VincentttWang/MSP430_WirelessCar/docs/hardware/MSP-EXP430F5529 硬件开发与引脚速查.md

# MSP-EXP430F5529 实验板硬件开发与引脚速查工程手册

> **文档依据**：TI 官方用户指南 *SLAU330B* (Rev 2.0 / Rev 2.2 PCB)
> **适用核心**：MSP430F5529 (80-Pin LQFP 封装)
> **手册定位**：嵌入式工程开发随身字典，涵盖所有可用引脚定义、物理排针映射、总线共享冲突、外设跳线及底层避坑指南。

---

## 目录

1. **MCU GPIO 端口全集引脚速查表 (Port 1 ~ Port 8)**
2. **板载外部扩展排针物理引脚图鉴 (J4, J5, J12, J13, RF1/2)**
3. **板载外设专用引脚分配与控制时序说明**
* 3.1 DOGS102x64 点阵液晶与背光驱动
* 3.2 MicroSD 卡 SPI 接口
* 3.3 三轴数字加速度计 (LIS3DH / CMA3000)
* 3.4 人机交互：按键、LED、电容触摸按键与电位器
* 3.5 调试、下载与板载虚拟串口 (eZ-FET / JTAG)

4. **板载跳线器 (Jumpers) 与电源模式配置指南**
5. **工程开发高频踩坑与冲突规避 (Critical Gotchas)**

---

## 1. MCU GPIO 端口全集引脚速查表 (Port 1 ~ Port 8)

| GPIO 引脚 | 复用功能 / 硬件外设 | 默认板载连接 / 物理去向 | 引出排针位置 | 硬件特性与工程开发注意事项 |
| --- | --- | --- | --- | --- |
| **P1.0** | TA0CLK / ACLK | 板载 LED1 (红色) | J12 Pin 15, JP3 | 经过跳线 `JP3 (LED JMP)` 和 470Ω 电阻接地。若作为高阻抗输入或捕获引脚，**必须拔下 JP3** 消除 LED 负载影响。 |
| **P1.1** | TA0.0 | 板载电容触摸 Pad 1 (叉号形 ╳) | 无直接排针 | 板载串联 680Ω 电阻至反贴蓝色 LED4，并连接触摸焊盘。不可作为通用高阻抗数字输入。 |
| **P1.2** | TA0.1 | 板载电容触摸 Pad 2 (方形 ◻) | 无直接排针 | 串接 680Ω 电阻至反贴蓝色 LED5，带触摸容性负载。 |
| **P1.3** | TA0.2 | 板载电容触摸 Pad 3 (八角形 ⯄) | 无直接排针 | 串接 680Ω 电阻至反贴蓝色 LED6，带触摸容性负载。 |
| **P1.4** | TA0.3 | 板载电容触摸 Pad 4 (三角形 △) | 无直接排针 | 串接 680Ω 电阻至反贴蓝色 LED7，带触摸容性负载。 |
| **P1.5** | TA0.4 / CBOUT | 板载电容触摸 Pad 5 (圆形 ◯) | 无直接排针 | 串接 680Ω 电阻至反贴蓝色 LED8，带触摸容性负载。 |
| **P1.6** | GPIO | USB PUR (上拉电阻使能) | 无外部排针 | 连接至 USB 硬件上拉控制网络及 BSL 按键 S4，用于向 USB Host 声明设备接入。一般开发请勿随意翻转。 |
| **P1.7** | GPIO | 用户按键 S1 | 无外部排针 | 按键按下时接地，板载**无硬件上拉电阻**，软件必须配置 `P1REN` 及 `P1OUT` 开启内部上拉。 |
| **P2.0** | TA1.1 | RF 接口定时器捕获/比较 | J12 Pin 16, RF1 Pin 9 | 专用于射频扩展模块或作为通用 GPIO / 定时器输出。 |
| **P2.1** | TA1.2 | 加速度计中断 2 (LIS3DH INT2)  | J12 Pin 6 | 在 Rev 2.2 PCB 上通过 0Ω 电阻 R58 连接加速度计 INT2。 |
| **P2.2** | GPIO | 用户按键 S2 | 无外部排针 | 按键按下时接地，板载**无硬件外部上拉**，MCU 端必须使能内部弱上拉。 |
| **P2.3** | TA2.0 | RF 模块扩展 / 定时器通道 | J12 Pin 5, RF1 Pin 7 | 通用引出，无板载外设干扰。 |
| **P2.4** | TA2.1 | RF 模块扩展 / 定时器通道 | J12 Pin 10, RF1 Pin 10 | 通用引出，无板载外设干扰。 |
| **P2.5** | GPIO | 加速度计中断 1 (ACCEL_INT1) | 无外部排针 | 接收加速度计中断脉冲，应配置为上升沿/下降沿外部中断。 |
| **P2.6** | TA0.1 / RF_STE | 射频模块片选 (RF_STE) | J12 Pin 1, RF1 Pin 11 | 作为 SPI 从机使能或主控软件片选输出。 |
| **P2.7** | GPIO | 加速度计片选 (ACCEL_CS) | 无外部排针 | 低电平有效。加速度计 SPI 传输时置低。 |
| **P3.0** | UCB0SIMO | RF 模块 / 加速度计共用 MOSI | J12 Pin 2, RF2 Pin 17 | ⚠️ **多设备总线共享**：同时连接至加速度计和射频插座，需依靠片选严格分时复用。 |
| **P3.1** | UCB0SOMI | RF 模块 / 加速度计共用 MISO | J12 Pin 3, RF2 Pin 19 | ⚠️ **多设备总线共享**：同上。 |
| **P3.2** | UCB0CLK | RF 模块 / 加速度计共用 SCK | J12 Pin 4, RF2 Pin 15 | ⚠️ **多设备总线共享**：同上。 |
| **P3.3** | XT2IN | 高频晶振输入 | 无 | 接入 4MHz 晶振 Q2。 |
| **P3.4** | XT2OUT | 高频晶振输出 | 无 | 接入 4MHz 晶振 Q2。 |
| **P3.5** | GPIO | 预留 / 内部无走线 | 无 | 内部未引出外设。 |
| **P3.6** | GPIO | 加速度计电源使能 (ACCEL_PWR)  | 无 | 输出高电平时为 LIS3DH/CMA3000 加速度计供电；低电平关断以降低系统待机功耗。 |
| **P3.7** | TB0OUTH / SVMOUT | MicroSD 卡片选 (SD_CS) | J5 Pin 11 | MicroSD SPI 片选，板载接有 47kΩ 上拉电阻。也可作为 TimerB 比较输出。 |
| **P4.0** | UCB1STE / UCA1CLK | RF 扩展接口控制线 | J5 Pin 9, J12 Pin 14, RF1 Pin 13 | USCI 扩展引脚。 |
| **P4.1** | UCB1SIMO / UCB1SDA  | LCD 显示屏 / SD 卡共用 MOSI | J5 Pin 5 & 10 | ⚠️ **多设备总线共享**：同时连接液晶屏与 MicroSD 卡。 |
| **P4.2** | UCB1SOMI / UCB1SCL  | MicroSD 卡数据输出 MISO | J5 Pin 3 & 12 | MicroSD 读数据线，兼做 I2C SCL。 |
| **P4.3** | UCB1CLK / UCA1STE | LCD 显示屏 / SD 卡共用 SCLK | J5 Pin 7 | ⚠️ **多设备总线共享**：LCD 与 SD 卡共用 SPI 时钟线。 |
| **P4.4** | UCA1TXD / UCA1SIMO  | 虚拟串口 TXD (发送) | J4 Pin 5 & 12, J12 Pin 13, J16, RF1 Pin 15 | 连接板载 eZ-FET 转换芯片 TUSB3410。通过 JP16 跳线连接；亦映射至排针。 |
| **P4.5** | UCA1RXD / UCA1SOMI  | 虚拟串口 RXD (接收) | J4 Pin 3 & 10, J12 Pin 11, J16, RF1 Pin 17 | 连接板载 eZ-FET 转换芯片。若外部占用串口，建议断开 JP16 对应跳线。 |
| **P4.6** | GPIO | RF 模块扩展 GPIO | J4 Pin 7, J12 Pin 12, RF1 Pin 19 | 干净的通用 I/O 引脚，无板载负载干扰。 |
| **P4.7** | GPIO | RF 模块扩展 GPIO | J4 Pin 9, J12 Pin 9, RF2 Pin 18 | 干净的通用 I/O 引脚。 |
| **P5.0** | A8 / VREF+ / VeREF+ | ADC 正基准电压输入/测试点 | TP1 测试点 | 可外部输入精准 ADC 参考基准。 |
| **P5.1** | A9 / VREF- / VeREF- | ADC 负基准电压输入 | J4 Pin 11 | 可配置为模拟通道 A9 或参考低端。 |
| **P5.2** | XT1IN | 低频 RTC 晶振输入 | 无 | 接入 32.768kHz 晶振 Q1。 |
| **P5.3** | XT1OUT | 低频 RTC 晶振输出 | 无 | 接入 32.768kHz 晶振 Q1。 |
| **P5.5** | GPIO | LCD 数据/命令选择 (LCD_D/C) | 无外部排针 | 高电平 = 数据 (Display RAM)；低电平 = 寄存器指令。 |
| **P5.6** | GPIO | LCD 硬件复位 (LCD_RST) | 无外部排针 | 低电平复位。板载接有 47kΩ 上拉电阻。 |
| **P5.7** | GPIO | LCD 片选使能 (LCD_CS) | 无外部排针 | 低电平有效。板载接有 47kΩ 上拉电阻。 |
| **P6.6** | CB6 / A6 | 比较器通道 6 / ADC 输入 6 | J4 Pin 2 | 独立模拟量输入通道，排针直出。 |
| **P6.7** | CB7 / A7 | 比较器通道 7 / ADC 输入 7 | J4 Pin 14 | 独立模拟量输入通道，排针直出。 |
| **P7.0** | CB8 / A12 | 比较器通道 8 / ADC 输入 12 | J5 Pin 2 | 独立模拟量输入通道。 |
| **P7.1** | CB9 / A13 | 比较器通道 9 / ADC 输入 13 | J5 Pin 4 | 独立模拟量输入通道。 |
| **P7.2** | CB10 / A14 | 比较器通道 10 / ADC 输入 14 | J5 Pin 6 | 独立模拟量输入通道。 |
| **P7.3** | CB11 / A15 | 比较器通道 11 / ADC 输入 15 | J5 Pin 8 | 独立模拟量输入通道。 |
| **P7.5** | TB0.3 | 定时器 B 通道 3 | J12 Pin 7, RF2 Pin 16 | 硬件 PWM 输出或输入捕获。 |
| **P7.6** | TB0.4 / GPIO | LCD 背光使能 (LCD_BLEN) | 无外部排针 | 连接至恒流芯片 TPS75105 的 EN。输入 PWM 信号可调节屏幕背光灰度。 |
| **P7.7** | TB0CLK / MCLK | 主时钟输出 / 定时器时钟输入 | J5 Pin 14 | 可用于时钟信号向外同步输出。 |
| **P8.0** | GPIO / A0 (模拟) | 模拟拇指滚轮电位器 (POT) | J4 Pin 8, JP2 | 经过跳线 `JP2 (POT)` 接到 50kΩ 电位器。**不用时请拔下 JP2**，避免分压漏电与模拟窜扰。 |
| **P8.1** | GPIO | 板载 LED2 (绿色) | J4 Pin 4 | 串接 470Ω 限流电阻至绿色 LED2。输出高电平点亮。 |
| **P8.2** | GPIO | 板载 LED3 (黄色) | J4 Pin 6 | 串接 470Ω 限流电阻至黄色 LED3。*(注：官方手册文档文字有笔误标为 P8.3，实际原理图与排针布线均为 P8.2)*。 |
| **RST/NMI** | SBWTDIO / JTAG_RST  | 硬件复位 / 仿真数据 | J1 Pin 11, JP16 Pin 3, S3 | 连接复位轻触按键 S3，接有 47kΩ 上拉和对地 1.1nF 电容滤波。 |
| **TEST** | SBWTCK / JTAG_TCK | 仿真时钟 | J1 Pin 8, JP16 Pin 1 | Spy-Bi-Wire 关键引脚。 |

---

## 2. 板载外部扩展排针物理引脚图鉴

实验板引出了 J4、J5 以及 J12/J13 等多组间距为 0.1 英寸（2.54mm）的双排针，方便用杜邦线或示波器探头外接信号。

### 2.1 排针 J4 (F5529 Pin Access Header 1)

*位置：单片机右上方靠近 USB 接口区域。标准 2×7 双排公针。*

```text
                  +-----+-----+
   (VCC 输出) VCC |  1  |  2  | P6.6 (CB6 / A6)
(UCA1RXD)    P4.5 |  3  |  4  | P8.1 (GPIO - LED2)
(UCA1TXD)    P4.4 |  5  |  6  | P8.2 (GPIO - LED3)
(GPIO)       P4.6 |  7  |  8  | P8.0 (GPIO - POT)
(GPIO)       P4.7 |  9  | 10  | P4.5 (UCA1RXD / UCA1SOMI)
(A9/VREF-)   P5.1 | 11  | 12  | P4.4 (UCA1TXD / UCA1SIMO)
            GND   | 13  | 14  | P6.7 (CB7 / A7)
                  +-----+-----+

```

> 📌 **注意**：P4.4 和 P4.5 在 J4 上各有**两个**物理引出引脚（Pin 3/10 与 Pin 5/12 同源），这是 PCB 为方便射频和串口双重跳线设计的并联网络。

---

### 2.2 排针 J5 (F5529 Pin Access Header 2)

*位置：单片机右下方靠近滚轮区域。标准 2×7 双排公针。*

```text
                               +-----+-----+
                (VCC 输出) VCC |  1  |  2  | P7.0 (CB8 / A12)
(UCB1SOMI / SD)           P4.2 |  3  |  4  | P7.1 (CB9 / A13)
(UCB1SIMO / LCD+SD)       P4.1 |  5  |  6  | P7.2 (CB10 / A14)
(UCB1CLK / LCD+SD)        P4.3 |  7  |  8  | P7.3 (CB11 / A15)
(UCB1STE / RF)            P4.0 |  9  | 10  | P4.1 (UCB1SIMO - LCD/SD)
(TB0OUTH / SD_CS)         P3.7 | 11  | 12  | P4.2 (UCB1SOMI - SD)
                         GND   | 13  | 14  | P7.7 (TB0CLK / MCLK)
                               +-----+-----+

```

> 📌 **注意**：J5 排针大量暴露了 UCB1 SPI 总线信号（P4.1、P4.2、P4.3）。若用于外接通用传感器，注意不要与板载 LCD 或 SD 卡发生总线争用。

---

### 2.3 排针 J12 (eZ-RF1 / eZ430-RF2500 Header)

*位置：板子右上方，标准 2×9 双排公针，兼容 TI eZ430-RF2500T 模块引脚。*

```text
                     +-----+-----+
(RF_STE)        P2.6 |  1  |  2  | P3.0 (RF_SIMO / UCB0)
(RF_SOMI)       P3.1 |  3  |  4  | P3.2 (RF_CLK / UCB0)
(TA2.0)         P2.3 |  5  |  6  | P2.1 (TA1.2)
(TB0.3)         P7.5 |  7  |  8  | GND
(GPIO)          P4.7 |  9  | 10  | P2.4 (TA2.1)
(RXD)           P4.5 | 11  | 12  | P4.6 (GPIO)
(TXD)           P4.4 | 13  | 14  | P4.0 (UCx1xx)
(LED1)          P1.0 | 15  | 16  | P2.0 (TA1.1)
               GND   | 17  | 18  | RF_PWR (受 JP14 控制供电)
                     +-----+-----+

```

> ⚠️ **供电警示**：J12 的 Pin 18 (`RF_PWR`) 必须在插上 **JP14 跳线帽** 后才有 3.3V 供电；若未插跳线，外接模块将无法上电。

---

### 2.4 排针 J13 (eZ-RF Target 调试接口)

*位置：6-Pin 单排接口，用于直插 eZ430 目标小板。*

| J13 引脚号 | 信号名 | MCU 连接端 / 功能 |
| --- | --- | --- |
| **Pin 1**  | TXD | P4.4 (UCA1TXD) |
| **Pin 2**  | RF_PWR | 受 JP14 控制的 3.3V 射频电源 |
| **Pin 3**  | RXD | P4.5 (UCA1RXD) |
| **Pin 4**  | GND | 系统参考地 |
| **Pin 5**  | RST | SBWTDIO (复位线) |
| **Pin 6**  | TEST | SBWTCK (测试时钟线) |

---

## 3. 板载外设专用引脚分配与控制时序说明

### 3.1 点阵液晶屏 DOGS102x64 与背光驱动

板载一块分辨率为 $102\times64$ 的单色点阵液晶（控制器 UC1701）及专用白色 LED 背光驱动。

| 功能信号 | 对应 MCU 引脚 | 电气特性与编程注意事项 |
| --- | --- | --- |
| **LCD_SIMO** | **P4.1** (UCB1SIMO) | SPI 数据输出，配置为 3 线 SPI Master（MSB first, Mode 0 或 Mode 3）。 |
| **LCD_SCLK** | **P4.3** (UCB1CLK)  | SPI 串行时钟线。最高支持约 20MHz。 |
| **LCD_CS** | **P5.7** | 片选低有效。板载带 47kΩ 上拉。向屏幕写指令或刷新显存前拉低，完成后拉高。 |
| **LCD_D/C**  | **P5.5** | 指令/数据选择：**低电平** 为控制命令；**高电平** 为显存数据。 |
| **LCD_RST**  | **P5.6** | 硬件复位低有效。板载带 47kΩ 上拉。上电后需给出不低于 10µs 的低脉冲完成硬件重置。 |
| **LCD_BLEN** | **P7.6** (TB0.4) | 背光恒流驱动 IC (TPS75105) 使能脚。常高全亮；使用 TimerB4 输出 PWM 可调节 0%~100% 亮度。 |

---

### 3.2 MicroSD 存储卡接口

采用 SPI 模式驱动标准 FAT16/FAT32 文件系统，插座位于板子顶部中央。

| 功能信号 | 对应 MCU 引脚 | 硬件特性与编程注意事项 |
| --- | --- | --- |
| **SD_CS** | **P3.7** | 片选低有效。板载带 47kΩ 强上拉电阻，空闲时保证 SD 卡处于未选中状态。 |
| **SD_SIMO** | **P4.1** (UCB1SIMO) | 与 LCD 共用。向 SD 卡发送 CMD 命令或写入 Block 块。 |
| **SD_SOMI** | **P4.2** (UCB1SOMI) | SD 卡数据返回（MISO）。板载带 47kΩ 上拉。 |
| **SD_SCLK** | **P4.3** (UCB1CLK)  | 与 LCD 共用。卡初始化阶段频率应限制在 100k~400kHz；进入传输阶段后再提速至 10M~20MHz。 |

---

### 3.3 三轴加速度计 (LIS3DH / CMA3000)

Rev 2.0 原装为 CMA3000-D01，Rev 2.2 替代为 ST 公司的 LIS3DH。采用 SPI 通信。

| 功能信号 | 对应 MCU 引脚 | 硬件特性与编程注意事项 |
| --- | --- | --- |
| **ACCEL_PWR**  | **P3.6** | **核心控制引脚**：加速度计电源通过 P3.6 供电。**初始化前必须将 P3.6 置高（输出 3.3V）并延时约 5ms 稳定电源**，否则读写寄存器无应答。 |
| **ACCEL_CS** | **P2.7** | 片选低有效。默认拉高。 |
| **ACCEL_SCK**  | **P3.2** (UCB0CLK)  | 与 RF 接口共享 UCB0 时钟。 |
| **ACCEL_SIMO** | **P3.0** (UCB0SIMO) | 与 RF 接口共享 UCB0 数据输出。 |
| **ACCEL_SOMI** | **P3.1** (UCB0SOMI) | 与 RF 接口共享 UCB0 数据输入。 |
| **ACCEL_INT1** | **P2.5** | 加速度阈值/敲击事件中断 1。 |
| **ACCEL_INT2** | **P2.1** | 仅限 Rev 2.2 PCB（通过 0Ω 电阻 R58 接入）。 |

---

### 3.4 人机交互元件

#### (1) 按键与电位器

* **按键 S1 (P1.7)**：按下为低电平。需配置内部弱上拉 (`P1REN |= BIT7; P1OUT |= BIT7;`)。
* **按键 S2 (P2.2)**：按下为低电平。需配置内部弱上拉 (`P2REN |= BIT2; P2OUT |= BIT2;`)。
* **复位按键 S3 (RST)**：硬件连通 MSP430 复位脚。
* **BSL 激活键 S4 (PUR)**：配合冷启动进入 USB 固件升级引导模式。
* **模拟滑轮电位器 (P8.0)**：接入 50kΩ 电位器滑动端。如果使用 ADC 通道采集电压，需闭合 **JP2 跳线**；若不用，务必断开 JP2，避免电位器分压消耗静态电流。

#### (2) LED 指示灯

* **LED1 (红色)**：接 **P1.0**。中间串接 **JP3 (LED JMP)**。高电平点亮。
* **LED2 (绿色)**：接 **P8.1**。高电平点亮。
* **LED3 (黄色)**：接 **P8.2**。高电平点亮。*(注：官方手册 Table 2 误标为 P8.3，请以 P8.2 为准)*。

#### (3) 触摸焊盘 (Cap-Touch Slider) 与背部指示灯

板子下方提供 5 个电容触摸电极（PAD1 ~ PAD5），每个焊盘反向焊有专属蓝色 LED（LED4 ~ LED8）：

* **PAD1 (╳)**：`P1.1` | **PAD2 (◻)**：`P1.2` | **PAD3 (⯄)**：`P1.3`
* **PAD4 (△)**：`P1.4` | **PAD5 (◯)**：`P1.5`
* **驱动原理**：利用 MSP430F5529 的 Pin-Oscillator 或外部 RC 充放电测量容值变化。引脚内部经过 680Ω 电阻连接至蓝色 LED 后接地。

---

### 3.5 调试、编程与通信接口

#### (1) 板载 eZ430-FET 仿真器跳线区 (JP16)

JP16 是一组 2×5 排针桥接器，连接板载仿真芯片与 F5529：

* `DVCC`：为板载仿真器的电平转换芯片提供目标板电压参考。
* `TXD`：P4.4 (MCU TX) $\rightarrow$ PC 虚拟串口接收端。
* `RXD`：P4.5 (MCU RX) $\leftarrow$ PC 虚拟串口发送端。
* `RST`：Spy-Bi-Wire 调试数据线 (SBWTDIO)。
* `TEST`：Spy-Bi-Wire 调试时钟线 (SBWTCK)。

> 💡 若需完全隔离板载仿真器（例如使用外接高精度分析仪或外接 JTAG 仿真盒），直接拔除 JP16 的全部跳线帽。

#### (2) 14-Pin 传统 JTAG 接口 (J1)

提供标准 14 针 JTAG 接口，支持外接 `MSP-FET430UIF` 开展 4-Wire 极速 JTAG 调试。

---

## 4. 板载跳线器 (Jumpers) 与电源模式配置指南

### 4.1 全板跳线器功能速查表

| 跳线位号 | 丝印名称  | 闭合 (插上跳线帽) | 断开 (拔除跳线帽) | 默认推荐状态 |
| --- | --- | --- | --- | --- |
| **JP2**  | POT | 连接 P8.0 至模拟电位器 | 断开 P8.0，释放为干净 GPIO/ADC | 使用滚轮时闭合 |
| **JP3**  | LED1 | 连接 P1.0 至 LED1 (红色) | 断开 P1.0，消除 LED 电流负载 | 调试指示时闭合 |
| **JP6**  | 430 PWR | 为 MCU 单片机供电 (DVCC) | MCU 断电。**可串联万用表测 MCU 单独功耗** | **必须闭合** |
| **JP7**  | SYS PWR | 为板载所有外设系统供电 (VCC) | 板载外设断电。**可串入万用表测整板功耗**  | **必须闭合** |
| **JP8**  | LDO (3针) | **ALT** (默认): 使用外部 TPS73533 高性能 3.3V LDO<br> | | |

<br>**INT**: 使用 F5529 片内集成 LDO 为系统供电 | 5529 USB 供电时无系统 VCC 输出 | 默认插在 **ALT** 侧 |
| **JP11** | JTAG (3针) | **EXT** (默认): JTAG 仿真盒不供电，需板载供电<br>

<br>**INT**: 允许 JTAG 仿真盒反向为板子系统供电 | JTAG 无法向系统供电 | 默认插在 **EXT** 侧 |
| **JP14** | RF PWR | 为射频扩展座 (J12, J13, RF2) 输送 3.3V 核心电源 | 射频扩展座完全断电 | 插入射频板时闭合 |
| **JP15** | USB PWR | 连通 5529 Mini-USB 的 5V VBUS 电源输入 | 5529 USB 接口供电断开 | 使用 5529 USB 供电时闭合 |
| **JP16** | eZ-FET | 连接 eZ-FET 调试仿真器与 UART 串口各路信号 | 彻底断开仿真模块与主控单片机的电气联系 | 正常开发全闭合 |

---

### 4.2 电源选择开关 (SW1) 与常用供电组合

板子左上方的拨动开关 **SW1 (POWER SEL)** 决定系统的电能入口：

```text
       SW1 档位设置                      工作模式说明
   +-------------------+
   | [■] LDO           | -> 使用右上方 "5529 USB" 端口供电 (经 TPS73533 降至 3.3V)
   | [ ] eZ            | -> 使用左下方 "eZ-FET USB" 端口供电 (经 TPS77301 降至 3.6V)
   | [ ] JTAG / BATT   | -> 使用 J10 接线端子外接干电池 (2~3V) 或通过 JTAG 仿真器供电
   +-------------------+

```

#### 四种常用供电配置速查：

1. **单 USB 独立运行开发 (最常用)**：
* 拨码开关 SW1 拨至 **`LDO`**。
* 数据线接入 **5529 USB**（右上角）。
* 跳线 `JP8` 选 **`ALT`**，`JP15` 闭合。

2. **免外接仿真器调试 (eZ-FET 调试)**：
* 拨码开关 SW1 拨至 **`eZ`**。
* 数据线接入 **eZ-FET USB**（左下角）。
* `JP16` 所有 5 组跳线帽全部短接。

3. **外接电池供电 (移动脱机)**：
* 电池插座 J10 接入 2 节 1.5V 干电池。
* 拨码开关 SW1 拨至 **`JTAG/BATT`**。
* 跳线 `JP11` 必须插在 **`EXT`** 位置。

4. **外部 MSP-FET430UIF 仿真盒供电**：
* SW1 拨至 **`JTAG/BATT`**。
* 跳线 `JP11` 插在 **`INT`** 位置。

---

### 4.3 超低功耗 (ULP) 动态电流测量方法

1. **仅测量 MSP430F5529 单芯片电流**：
* 取下 **JP6** 跳线帽。
* 将高精度微安表/皮安表串接在 **JP6** 的两个插针之间（或使用 JP6 旁边两个大过孔“430 PWR”引出线夹）。
* 此时可精准测得活动模式或 LPM3 停机模式下的 MCU 级电流（LPM3 典型值约为 2µA）。

2. **测量整板全系统功耗 (System Current)**：
* 取下 **JP7** 跳线帽。
* 将万用表串接入 **JP7** 两端。
* ⚠️ 注意：开启屏幕背光时整板电流约为 **25mA ~ 30mA** 属于正常状态。若要测试低功耗系统，需关闭液晶和背光。

---

## 5. 工程开发高频踩坑与冲突规避 (Critical Gotchas)

### ⚠️ 陷阱 1：SPI 外设总线复用踩坑

* **LCD 与 MicroSD 冲突**：
两者共用 **UCB1** 总线（`P4.1` SIMO, `P4.3` SCLK）。
* **解决法则**：操作 SD 卡前，务必先将 LCD 片选 `P5.7` 置高（禁用 LCD）；操作 LCD 前，务必先将 MicroSD 卡片选 `P3.7` 置高（禁用 SD 卡）。

* **加速度计与 RF 模块冲突**：
两者共用 **UCB0** 总线（`P3.0` SIMO, `P3.1` SOMI, `P3.2` SCK）。
* **解决法则**：在与无线射频通信时，确保加速度计片选 `P2.7` 保持高电平。

### ⚠️ 陷阱 2：加速度计读不出数据？P3.6 是使能开关！

许多开发者常误以为加速度计由系统 VCC 常供电，实际上 TI 原理图为了极限低功耗，将传感器 VDD 接在 **`P3.6`** 上。

* **避坑代码**：
```c
P3DIR |= BIT6;
P3OUT |= BIT6;   // 必须拉高给加速度计供电
__delay_cycles(50000); // 必须延时等待传感器电源稳定，再发起 SPI 寻址！

```

### ⚠️ 陷阱 3：官方文档 Table 2 与原理图的 LED3 勘误

* 官方手册第 19 页 Table 2 中将 **LED3** 误标记为 **P8.3**。
* **纠偏真相**：查阅原理图 Sheet 1 (Figure 10) 及 Table 3 (J4 排针定义)，LED3 硬件上实际连接至 **`P8.2`**。在工程中控制黄色 LED3，必须配置 `P8DIR |= BIT2; P8OUT |= BIT2;`。

### ⚠️ 陷阱 4：JTAG 彻底锁死 (Lockup) 应急抢救流程

如果由于电源不稳定、烧录时突然拔线或配置了非法的主频/核心电压（PMM VCORE 配置错误），导致 CCS 报错 `Unable to connect to target` 或 JTAG 锁死：

1. 拔下所有连接线（拔除 JTAG 线、USB 5529 线及 eZ-FET USB 线）。
2. 将电源选择开关 SW1 拨到 **`eZ`** 档位。
3. 用一根杜邦线将板子上的 **GND 测试孔** 与 **430 PWR 测试孔**（JP6 旁边的过孔）**短接 3 秒**，泄放 MCU 内部残余电荷。
4. 重新接上 USB 线，即可顺利解除锁死。

### ⚠️ 陷阱 5：USB 与干电池混用导致的“反充爆炸风险”

* 严禁在 SW1 拨在 `LDO` 档且插入 5529 USB 供电时，同时在 J10 接入普通不可充电干电池且将跳线乱插。
* 错误的供电跳线组合会导致 5V/3.3V 电源逆向灌入干电池夹，造成电池发热甚至漏液损坏板卡。使用电池供电时，必须将 SW1 切至 `JTAG/BATT`，且 JP11 选 `EXT`。

### ⚠️ 陷阱 6：P1.1 ~ P1.5 触摸按键不可当普通高阻输入

P1.1 至 P1.5 物理走线上并联有电容焊盘、680Ω 电阻以及 LED4~LED8 的对地回路。如果用于外接数字传感器作为输入引脚，电平会被下拉电阻强制拉低。建议这些引脚只用于原生的电容触摸方案，避免外部扩展使用。通用外接数字信号请优先使用排针 **J4、J5** 上的独立端口（如 P4.6, P4.7, P6.6, P6.7, P7.0~P7.3）。
