VincentttWang/MSP430_WirelessCar/NUEDC_2026/[Doc] Hardware/感为灰度Keil_MSPM0例程/examples/Software_IIC/keil/Objects/gpio_toggle_output_LP_MSPM0G3507_nortos_keil.htm

# Static Call Graph for image .\Objects\gpio_toggle_output_LP_MSPM0G3507_nortos_keil.axf

#<CALLGRAPH># ARM Linker, 6210000: Last Updated: Tue Jul 22 17:33:17 2025

### Maximum Stack Usage = 184 bytes + Unknown(Cycles, Untraceable Function Pointers)

### Call chain for Maximum Stack Depth:

__rt_entry_main ⇒ main ⇒ Ping ⇒ IIC_ReadBytes ⇒ IIC_RecvByte ⇒ delay_us

### Mutually Recursive functions

- NMI_Handler ⇒ NMI_Handler
- HardFault_Handler ⇒ HardFault_Handler
- SVC_Handler ⇒ SVC_Handler
- PendSV_Handler ⇒ PendSV_Handler
- SysTick_Handler ⇒ SysTick_Handler

### Function Pointers

- ADC0_IRQHandler from startup_mspm0g350x_uvision.o(.text) referenced from startup_mspm0g350x_uvision.o(RESET)
- ADC1_IRQHandler from startup_mspm0g350x_uvision.o(.text) referenced from startup_mspm0g350x_uvision.o(RESET)
- AES_IRQHandler from startup_mspm0g350x_uvision.o(.text) referenced from startup_mspm0g350x_uvision.o(RESET)
- CANFD0_IRQHandler from startup_mspm0g350x_uvision.o(.text) referenced from startup_mspm0g350x_uvision.o(RESET)
- DAC0_IRQHandler from startup_mspm0g350x_uvision.o(.text) referenced from startup_mspm0g350x_uvision.o(RESET)
- DMA_IRQHandler from startup_mspm0g350x_uvision.o(.text) referenced from startup_mspm0g350x_uvision.o(RESET)
- GROUP0_IRQHandler from startup_mspm0g350x_uvision.o(.text) referenced from startup_mspm0g350x_uvision.o(RESET)
- GROUP1_IRQHandler from startup_mspm0g350x_uvision.o(.text) referenced from startup_mspm0g350x_uvision.o(RESET)
- HardFault_Handler from startup_mspm0g350x_uvision.o(.text) referenced from startup_mspm0g350x_uvision.o(RESET)
- I2C0_IRQHandler from startup_mspm0g350x_uvision.o(.text) referenced from startup_mspm0g350x_uvision.o(RESET)
- I2C1_IRQHandler from startup_mspm0g350x_uvision.o(.text) referenced from startup_mspm0g350x_uvision.o(RESET)
- NMI_Handler from startup_mspm0g350x_uvision.o(.text) referenced from startup_mspm0g350x_uvision.o(RESET)
- PendSV_Handler from startup_mspm0g350x_uvision.o(.text) referenced from startup_mspm0g350x_uvision.o(RESET)
- RTC_IRQHandler from startup_mspm0g350x_uvision.o(.text) referenced from startup_mspm0g350x_uvision.o(RESET)
- Reset_Handler from startup_mspm0g350x_uvision.o(.text) referenced from startup_mspm0g350x_uvision.o(RESET)
- SPI0_IRQHandler from startup_mspm0g350x_uvision.o(.text) referenced from startup_mspm0g350x_uvision.o(RESET)
- SPI1_IRQHandler from startup_mspm0g350x_uvision.o(.text) referenced from startup_mspm0g350x_uvision.o(RESET)
- SVC_Handler from startup_mspm0g350x_uvision.o(.text) referenced from startup_mspm0g350x_uvision.o(RESET)
- SysTick_Handler from startup_mspm0g350x_uvision.o(.text) referenced from startup_mspm0g350x_uvision.o(RESET)
- TIMA0_IRQHandler from startup_mspm0g350x_uvision.o(.text) referenced from startup_mspm0g350x_uvision.o(RESET)
- TIMA1_IRQHandler from startup_mspm0g350x_uvision.o(.text) referenced from startup_mspm0g350x_uvision.o(RESET)
- TIMG0_IRQHandler from startup_mspm0g350x_uvision.o(.text) referenced from startup_mspm0g350x_uvision.o(RESET)
- TIMG12_IRQHandler from startup_mspm0g350x_uvision.o(.text) referenced from startup_mspm0g350x_uvision.o(RESET)
- TIMG6_IRQHandler from startup_mspm0g350x_uvision.o(.text) referenced from startup_mspm0g350x_uvision.o(RESET)
- TIMG7_IRQHandler from startup_mspm0g350x_uvision.o(.text) referenced from startup_mspm0g350x_uvision.o(RESET)
- TIMG8_IRQHandler from startup_mspm0g350x_uvision.o(.text) referenced from startup_mspm0g350x_uvision.o(RESET)
- UART0_IRQHandler from startup_mspm0g350x_uvision.o(.text) referenced from startup_mspm0g350x_uvision.o(RESET)
- UART1_IRQHandler from startup_mspm0g350x_uvision.o(.text) referenced from startup_mspm0g350x_uvision.o(RESET)
- UART2_IRQHandler from startup_mspm0g350x_uvision.o(.text) referenced from startup_mspm0g350x_uvision.o(RESET)
- UART3_IRQHandler from startup_mspm0g350x_uvision.o(.text) referenced from startup_mspm0g350x_uvision.o(RESET)
- __main from __main.o(!!!main) referenced from startup_mspm0g350x_uvision.o(.text)
- _printf_input_char from _printf_char_common.o(.text) referenced from _printf_char_common.o(.text)
- _sputc from _sputc.o(.text) referenced from noretval__2sprintf.o(.text)

### Global Symbols

__main (Thumb, 8 bytes, Stack size 0 bytes, __main.o(!!!main))

[Calls]

- >> __scatterload
- >> __rt_entry

[Address Reference Count : 1]

- startup_mspm0g350x_uvision.o(.text)

__scatterload (Thumb, 0 bytes, Stack size unknown bytes, __scatter.o(!!!scatter))

[Called By]

- >> __main

__scatterload_rt2 (Thumb, 74 bytes, Stack size unknown bytes, __scatter.o(!!!scatter), UNUSED)

[Calls]

- >> __rt_entry

__scatterload_rt2_thumb_only (Thumb, 0 bytes, Stack size unknown bytes, __scatter.o(!!!scatter), UNUSED)

__scatterload_loop (Thumb, 0 bytes, Stack size unknown bytes, __scatter.o(!!!scatter), UNUSED)

__scatterload_copy (Thumb, 26 bytes, Stack size unknown bytes, __scatter_copy.o(!!handler_copy), UNUSED)

[Calls]

- >> __scatterload_copy

[Called By]

- >> __scatterload_copy

__scatterload_null (Thumb, 2 bytes, Stack size unknown bytes, __scatter.o(!!handler_null), UNUSED)

__scatterload_zeroinit (Thumb, 28 bytes, Stack size unknown bytes, __scatter_zi.o(!!handler_zi), UNUSED)

_printf_percent (Thumb, 0 bytes, Stack size unknown bytes, _printf_percent.o(.ARM.Collect$$_printf_percent$$00000000))

[Called By]

- >> __printf

_printf_d (Thumb, 0 bytes, Stack size unknown bytes, _printf_d.o(.ARM.Collect$$_printf_percent$$00000009))

[Stack]

- Max Depth = 72 + Unknown Stack Size
- Call Chain = _printf_d ⇒ _printf_int_dec ⇒ _printf_int_common

[Calls]

- >> _printf_percent_end
- >> _printf_int_dec

_printf_percent_end (Thumb, 0 bytes, Stack size unknown bytes, _printf_percent_end.o(.ARM.Collect$$_printf_percent$$00000017))

[Called By]

- >> _printf_d

__rt_lib_init (Thumb, 0 bytes, Stack size unknown bytes, libinit.o(.ARM.Collect$$libinit$$00000000))

[Called By]

- >> __rt_entry_li

__rt_lib_init_alloca_1 (Thumb, 0 bytes, Stack size unknown bytes, libinit2.o(.ARM.Collect$$libinit$$00000030))

__rt_lib_init_argv_1 (Thumb, 0 bytes, Stack size unknown bytes, libinit2.o(.ARM.Collect$$libinit$$0000002E))

__rt_lib_init_atexit_1 (Thumb, 0 bytes, Stack size unknown bytes, libinit2.o(.ARM.Collect$$libinit$$0000001D))

__rt_lib_init_clock_1 (Thumb, 0 bytes, Stack size unknown bytes, libinit2.o(.ARM.Collect$$libinit$$00000023))

__rt_lib_init_cpp_1 (Thumb, 0 bytes, Stack size unknown bytes, libinit2.o(.ARM.Collect$$libinit$$00000034))

__rt_lib_init_exceptions_1 (Thumb, 0 bytes, Stack size unknown bytes, libinit2.o(.ARM.Collect$$libinit$$00000032))

__rt_lib_init_fp_1 (Thumb, 0 bytes, Stack size unknown bytes, libinit2.o(.ARM.Collect$$libinit$$00000002))

__rt_lib_init_fp_trap_1 (Thumb, 0 bytes, Stack size unknown bytes, libinit2.o(.ARM.Collect$$libinit$$00000021))

__rt_lib_init_getenv_1 (Thumb, 0 bytes, Stack size unknown bytes, libinit2.o(.ARM.Collect$$libinit$$00000025))

__rt_lib_init_heap_1 (Thumb, 0 bytes, Stack size unknown bytes, libinit2.o(.ARM.Collect$$libinit$$0000000C))

__rt_lib_init_lc_collate_1 (Thumb, 0 bytes, Stack size unknown bytes, libinit2.o(.ARM.Collect$$libinit$$00000013))

__rt_lib_init_lc_ctype_1 (Thumb, 0 bytes, Stack size unknown bytes, libinit2.o(.ARM.Collect$$libinit$$00000015))

__rt_lib_init_lc_monetary_1 (Thumb, 0 bytes, Stack size unknown bytes, libinit2.o(.ARM.Collect$$libinit$$00000017))

__rt_lib_init_lc_numeric_1 (Thumb, 0 bytes, Stack size unknown bytes, libinit2.o(.ARM.Collect$$libinit$$00000019))

__rt_lib_init_lc_time_1 (Thumb, 0 bytes, Stack size unknown bytes, libinit2.o(.ARM.Collect$$libinit$$0000001B))

__rt_lib_init_preinit_1 (Thumb, 0 bytes, Stack size unknown bytes, libinit2.o(.ARM.Collect$$libinit$$00000006))

__rt_lib_init_rand_1 (Thumb, 0 bytes, Stack size unknown bytes, libinit2.o(.ARM.Collect$$libinit$$00000010))

__rt_lib_init_relocate_pie_1 (Thumb, 0 bytes, Stack size unknown bytes, libinit2.o(.ARM.Collect$$libinit$$00000004))

__rt_lib_init_return (Thumb, 0 bytes, Stack size unknown bytes, libinit2.o(.ARM.Collect$$libinit$$00000035))

__rt_lib_init_signal_1 (Thumb, 0 bytes, Stack size unknown bytes, libinit2.o(.ARM.Collect$$libinit$$0000001F))

__rt_lib_init_stdio_1 (Thumb, 0 bytes, Stack size unknown bytes, libinit2.o(.ARM.Collect$$libinit$$00000027))

__rt_lib_init_user_alloc_1 (Thumb, 0 bytes, Stack size unknown bytes, libinit2.o(.ARM.Collect$$libinit$$0000000E))

__rt_lib_shutdown (Thumb, 0 bytes, Stack size unknown bytes, libshutdown.o(.ARM.Collect$$libshutdown$$00000000))

[Called By]

- >> __rt_exit_ls

__rt_lib_shutdown_cpp_1 (Thumb, 0 bytes, Stack size unknown bytes, libshutdown2.o(.ARM.Collect$$libshutdown$$00000002))

__rt_lib_shutdown_fp_trap_1 (Thumb, 0 bytes, Stack size unknown bytes, libshutdown2.o(.ARM.Collect$$libshutdown$$00000007))

__rt_lib_shutdown_heap_1 (Thumb, 0 bytes, Stack size unknown bytes, libshutdown2.o(.ARM.Collect$$libshutdown$$0000000F))

__rt_lib_shutdown_return (Thumb, 0 bytes, Stack size unknown bytes, libshutdown2.o(.ARM.Collect$$libshutdown$$00000010))

__rt_lib_shutdown_signal_1 (Thumb, 0 bytes, Stack size unknown bytes, libshutdown2.o(.ARM.Collect$$libshutdown$$0000000A))

__rt_lib_shutdown_stdio_1 (Thumb, 0 bytes, Stack size unknown bytes, libshutdown2.o(.ARM.Collect$$libshutdown$$00000004))

__rt_lib_shutdown_user_alloc_1 (Thumb, 0 bytes, Stack size unknown bytes, libshutdown2.o(.ARM.Collect$$libshutdown$$0000000C))

__rt_entry (Thumb, 0 bytes, Stack size unknown bytes, __rtentry.o(.ARM.Collect$$rtentry$$00000000))

[Called By]

- >> __scatterload_rt2
- >> __main

__rt_entry_presh_1 (Thumb, 0 bytes, Stack size unknown bytes, __rtentry2.o(.ARM.Collect$$rtentry$$00000002))

__rt_entry_sh (Thumb, 0 bytes, Stack size unknown bytes, __rtentry4.o(.ARM.Collect$$rtentry$$00000004))

[Stack]

- Max Depth = 8 + Unknown Stack Size
- Call Chain = __rt_entry_sh ⇒ __user_setup_stackheap

[Calls]

- >> __user_setup_stackheap

__rt_entry_li (Thumb, 0 bytes, Stack size unknown bytes, __rtentry2.o(.ARM.Collect$$rtentry$$0000000A))

[Calls]

- >> __rt_lib_init

__rt_entry_postsh_1 (Thumb, 0 bytes, Stack size unknown bytes, __rtentry2.o(.ARM.Collect$$rtentry$$00000009))

__rt_entry_main (Thumb, 0 bytes, Stack size unknown bytes, __rtentry2.o(.ARM.Collect$$rtentry$$0000000D))

[Stack]

- Max Depth = 184 + Unknown Stack Size
- Call Chain = __rt_entry_main ⇒ main ⇒ Ping ⇒ IIC_ReadBytes ⇒ IIC_RecvByte ⇒ delay_us

[Calls]

- >> main
- >> exit

__rt_entry_postli_1 (Thumb, 0 bytes, Stack size unknown bytes, __rtentry2.o(.ARM.Collect$$rtentry$$0000000C))

__rt_exit (Thumb, 0 bytes, Stack size unknown bytes, rtexit.o(.ARM.Collect$$rtexit$$00000000))

[Called By]

- >> exit

__rt_exit_ls (Thumb, 0 bytes, Stack size unknown bytes, rtexit2.o(.ARM.Collect$$rtexit$$00000003))

[Calls]

- >> __rt_lib_shutdown

__rt_exit_prels_1 (Thumb, 0 bytes, Stack size unknown bytes, rtexit2.o(.ARM.Collect$$rtexit$$00000002))

__rt_exit_exit (Thumb, 0 bytes, Stack size unknown bytes, rtexit2.o(.ARM.Collect$$rtexit$$00000004))

[Calls]

- >> _sys_exit

Reset_Handler (Thumb, 4 bytes, Stack size 0 bytes, startup_mspm0g350x_uvision.o(.text))
[Address Reference Count : 1]

- startup_mspm0g350x_uvision.o(RESET)

NMI_Handler (Thumb, 2 bytes, Stack size 0 bytes, startup_mspm0g350x_uvision.o(.text))

[Calls]

- >> NMI_Handler

[Called By]

- >> NMI_Handler

[Address Reference Count : 1]

- startup_mspm0g350x_uvision.o(RESET)

HardFault_Handler (Thumb, 2 bytes, Stack size 0 bytes, startup_mspm0g350x_uvision.o(.text))

[Calls]

- >> HardFault_Handler

[Called By]

- >> HardFault_Handler

[Address Reference Count : 1]

- startup_mspm0g350x_uvision.o(RESET)

SVC_Handler (Thumb, 2 bytes, Stack size 0 bytes, startup_mspm0g350x_uvision.o(.text))

[Calls]

- >> SVC_Handler

[Called By]

- >> SVC_Handler

[Address Reference Count : 1]

- startup_mspm0g350x_uvision.o(RESET)

PendSV_Handler (Thumb, 2 bytes, Stack size 0 bytes, startup_mspm0g350x_uvision.o(.text))

[Calls]

- >> PendSV_Handler

[Called By]

- >> PendSV_Handler

[Address Reference Count : 1]

- startup_mspm0g350x_uvision.o(RESET)

SysTick_Handler (Thumb, 2 bytes, Stack size 0 bytes, startup_mspm0g350x_uvision.o(.text))

[Calls]

- >> SysTick_Handler

[Called By]

- >> SysTick_Handler

[Address Reference Count : 1]

- startup_mspm0g350x_uvision.o(RESET)

ADC0_IRQHandler (Thumb, 0 bytes, Stack size 0 bytes, startup_mspm0g350x_uvision.o(.text))
[Address Reference Count : 1]

- startup_mspm0g350x_uvision.o(RESET)

ADC1_IRQHandler (Thumb, 0 bytes, Stack size 0 bytes, startup_mspm0g350x_uvision.o(.text))
[Address Reference Count : 1]

- startup_mspm0g350x_uvision.o(RESET)

AES_IRQHandler (Thumb, 0 bytes, Stack size 0 bytes, startup_mspm0g350x_uvision.o(.text))
[Address Reference Count : 1]

- startup_mspm0g350x_uvision.o(RESET)

CANFD0_IRQHandler (Thumb, 0 bytes, Stack size 0 bytes, startup_mspm0g350x_uvision.o(.text))
[Address Reference Count : 1]

- startup_mspm0g350x_uvision.o(RESET)

DAC0_IRQHandler (Thumb, 0 bytes, Stack size 0 bytes, startup_mspm0g350x_uvision.o(.text))
[Address Reference Count : 1]

- startup_mspm0g350x_uvision.o(RESET)

DMA_IRQHandler (Thumb, 0 bytes, Stack size 0 bytes, startup_mspm0g350x_uvision.o(.text))
[Address Reference Count : 1]

- startup_mspm0g350x_uvision.o(RESET)

Default_Handler (Thumb, 2 bytes, Stack size 0 bytes, startup_mspm0g350x_uvision.o(.text), UNUSED)

[Calls]

- >> Default_Handler

[Called By]

- >> Default_Handler

GROUP0_IRQHandler (Thumb, 0 bytes, Stack size 0 bytes, startup_mspm0g350x_uvision.o(.text))
[Address Reference Count : 1]

- startup_mspm0g350x_uvision.o(RESET)

GROUP1_IRQHandler (Thumb, 0 bytes, Stack size 0 bytes, startup_mspm0g350x_uvision.o(.text))
[Address Reference Count : 1]

- startup_mspm0g350x_uvision.o(RESET)

I2C0_IRQHandler (Thumb, 0 bytes, Stack size 0 bytes, startup_mspm0g350x_uvision.o(.text))
[Address Reference Count : 1]

- startup_mspm0g350x_uvision.o(RESET)

I2C1_IRQHandler (Thumb, 0 bytes, Stack size 0 bytes, startup_mspm0g350x_uvision.o(.text))
[Address Reference Count : 1]

- startup_mspm0g350x_uvision.o(RESET)

RTC_IRQHandler (Thumb, 0 bytes, Stack size 0 bytes, startup_mspm0g350x_uvision.o(.text))
[Address Reference Count : 1]

- startup_mspm0g350x_uvision.o(RESET)

SPI0_IRQHandler (Thumb, 0 bytes, Stack size 0 bytes, startup_mspm0g350x_uvision.o(.text))
[Address Reference Count : 1]

- startup_mspm0g350x_uvision.o(RESET)

SPI1_IRQHandler (Thumb, 0 bytes, Stack size 0 bytes, startup_mspm0g350x_uvision.o(.text))
[Address Reference Count : 1]

- startup_mspm0g350x_uvision.o(RESET)

TIMA0_IRQHandler (Thumb, 0 bytes, Stack size 0 bytes, startup_mspm0g350x_uvision.o(.text))
[Address Reference Count : 1]

- startup_mspm0g350x_uvision.o(RESET)

TIMA1_IRQHandler (Thumb, 0 bytes, Stack size 0 bytes, startup_mspm0g350x_uvision.o(.text))
[Address Reference Count : 1]

- startup_mspm0g350x_uvision.o(RESET)

TIMG0_IRQHandler (Thumb, 0 bytes, Stack size 0 bytes, startup_mspm0g350x_uvision.o(.text))
[Address Reference Count : 1]

- startup_mspm0g350x_uvision.o(RESET)

TIMG12_IRQHandler (Thumb, 0 bytes, Stack size 0 bytes, startup_mspm0g350x_uvision.o(.text))
[Address Reference Count : 1]

- startup_mspm0g350x_uvision.o(RESET)

TIMG6_IRQHandler (Thumb, 0 bytes, Stack size 0 bytes, startup_mspm0g350x_uvision.o(.text))
[Address Reference Count : 1]

- startup_mspm0g350x_uvision.o(RESET)

TIMG7_IRQHandler (Thumb, 0 bytes, Stack size 0 bytes, startup_mspm0g350x_uvision.o(.text))
[Address Reference Count : 1]

- startup_mspm0g350x_uvision.o(RESET)

TIMG8_IRQHandler (Thumb, 0 bytes, Stack size 0 bytes, startup_mspm0g350x_uvision.o(.text))
[Address Reference Count : 1]

- startup_mspm0g350x_uvision.o(RESET)

UART0_IRQHandler (Thumb, 0 bytes, Stack size 0 bytes, startup_mspm0g350x_uvision.o(.text))
[Address Reference Count : 1]

- startup_mspm0g350x_uvision.o(RESET)

UART1_IRQHandler (Thumb, 0 bytes, Stack size 0 bytes, startup_mspm0g350x_uvision.o(.text))
[Address Reference Count : 1]

- startup_mspm0g350x_uvision.o(RESET)

UART2_IRQHandler (Thumb, 0 bytes, Stack size 0 bytes, startup_mspm0g350x_uvision.o(.text))
[Address Reference Count : 1]

- startup_mspm0g350x_uvision.o(RESET)

UART3_IRQHandler (Thumb, 0 bytes, Stack size 0 bytes, startup_mspm0g350x_uvision.o(.text))
[Address Reference Count : 1]

- startup_mspm0g350x_uvision.o(RESET)

__user_initial_stackheap (Thumb, 10 bytes, Stack size 0 bytes, startup_mspm0g350x_uvision.o(.text))

[Called By]

- >> __user_setup_stackheap

__2sprintf (Thumb, 36 bytes, Stack size 32 bytes, noretval__2sprintf.o(.text))

[Stack]

- Max Depth = 120 + Unknown Stack Size
- Call Chain = __2sprintf ⇒ _printf_char_common ⇒ __printf

[Calls]

- >> _sputc
- >> _printf_char_common

[Called By]

- >> main

__printf (Thumb, 108 bytes, Stack size 24 bytes, __printf.o(.text))

[Stack]

- Max Depth = 24 + Unknown Stack Size
- Call Chain = __printf

[Calls]

- >> _printf_percent

[Called By]

- >> _printf_char_common

_printf_int_dec (Thumb, 90 bytes, Stack size 32 bytes, _printf_dec.o(.text))

[Stack]

- Max Depth = 72
- Call Chain = _printf_int_dec ⇒ _printf_int_common

[Calls]

- >> __rt_udiv10
- >> _printf_int_common
- >> _printf_truncate_unsigned (Weak Reference)
- >> _printf_truncate_signed (Weak Reference)

[Called By]

- >> _printf_d

_memset_w (Thumb, 26 bytes, Stack size 0 bytes, rt_memclr.o(.text), UNUSED)

[Called By]

- >> __rt_memclr_w
- >> _memset

_memset (Thumb, 30 bytes, Stack size 0 bytes, rt_memclr.o(.text), UNUSED)

[Calls]

- >> _memset_w

[Called By]

- >> __aeabi_memclr

__aeabi_memclr (Thumb, 4 bytes, Stack size 0 bytes, rt_memclr.o(.text), UNUSED)

[Calls]

- >> _memset

__rt_memclr (Thumb, 0 bytes, Stack size 0 bytes, rt_memclr.o(.text), UNUSED)

__aeabi_memclr4 (Thumb, 0 bytes, Stack size 0 bytes, rt_memclr.o(.text))

[Called By]

- >> main

__aeabi_memclr8 (Thumb, 0 bytes, Stack size 0 bytes, rt_memclr.o(.text), UNUSED)

__rt_memclr_w (Thumb, 4 bytes, Stack size 0 bytes, rt_memclr.o(.text), UNUSED)

[Calls]

- >> _memset_w

__use_two_region_memory (Thumb, 2 bytes, Stack size 0 bytes, heapauxi.o(.text), UNUSED)

__rt_heap_escrow$2region (Thumb, 2 bytes, Stack size 0 bytes, heapauxi.o(.text), UNUSED)

__rt_heap_expand$2region (Thumb, 2 bytes, Stack size 0 bytes, heapauxi.o(.text), UNUSED)

_printf_int_common (Thumb, 176 bytes, Stack size 40 bytes, _printf_intcommon.o(.text))

[Stack]

- Max Depth = 40
- Call Chain = _printf_int_common

[Calls]

- >> _printf_pre_padding (Weak Reference)
- >> _printf_post_padding (Weak Reference)

[Called By]

- >> _printf_int_dec

_printf_char_common (Thumb, 32 bytes, Stack size 64 bytes, _printf_char_common.o(.text))

[Stack]

- Max Depth = 88 + Unknown Stack Size
- Call Chain = _printf_char_common ⇒ __printf

[Calls]

- >> __printf

[Called By]

- >> __2sprintf

_sputc (Thumb, 10 bytes, Stack size 0 bytes, _sputc.o(.text))

[Called By]

- >> __2sprintf

[Address Reference Count : 1]

- noretval__2sprintf.o(.text)

__rt_udiv10 (Thumb, 40 bytes, Stack size 0 bytes, rtudiv10.o(.text))

[Called By]

- >> _printf_int_dec

__user_setup_stackheap (Thumb, 62 bytes, Stack size 8 bytes, sys_stackheap_outer.o(.text))

[Stack]

- Max Depth = 8
- Call Chain = __user_setup_stackheap

[Calls]

- >> __user_initial_stackheap
- >> __user_perproc_libspace

[Called By]

- >> __rt_entry_sh

exit (Thumb, 16 bytes, Stack size 8 bytes, exit.o(.text))

[Stack]

- Max Depth = 8 + Unknown Stack Size
- Call Chain = exit

[Calls]

- >> __rt_exit
- >> _call_atexit_fns (Weak Reference)

[Called By]

- >> __rt_entry_main

__user_libspace (Thumb, 8 bytes, Stack size 0 bytes, libspace.o(.text), UNUSED)

__user_perproc_libspace (Thumb, 0 bytes, Stack size 0 bytes, libspace.o(.text))

[Called By]

- >> __user_setup_stackheap

__user_perthread_libspace (Thumb, 0 bytes, Stack size 0 bytes, libspace.o(.text), UNUSED)

_sys_exit (Thumb, 8 bytes, Stack size 0 bytes, sys_exit.o(.text))

[Called By]

- >> __rt_exit_exit

__I$use$semihosting (Thumb, 0 bytes, Stack size 0 bytes, use_no_semi.o(.text), UNUSED)

__use_no_semihosting_swi (Thumb, 2 bytes, Stack size 0 bytes, use_no_semi.o(.text), UNUSED)

__semihosting_library_function (Thumb, 0 bytes, Stack size unknown bytes, indicate_semi.o(.text), UNUSED)

DL_ADC12_setClockConfig (Thumb, 64 bytes, Stack size 16 bytes, dl_adc12.o(.text.DL_ADC12_setClockConfig))

[Stack]

- Max Depth = 16
- Call Chain = DL_ADC12_setClockConfig

[Called By]

- >> SYSCFG_DL_ADC1_init

DL_Common_delayCycles (Thumb, 10 bytes, Stack size 0 bytes, dl_common.o(.text.DL_Common_delayCycles))

[Called By]

- >> SYSCFG_DL_initPower

DL_DMA_initChannel (Thumb, 68 bytes, Stack size 16 bytes, dl_dma.o(.text.DL_DMA_initChannel))

[Stack]

- Max Depth = 16
- Call Chain = DL_DMA_initChannel

[Called By]

- >> SYSCFG_DL_DMA_CH0_init

DL_I2C_setClockConfig (Thumb, 38 bytes, Stack size 16 bytes, dl_i2c.o(.text.DL_I2C_setClockConfig))

[Stack]

- Max Depth = 16
- Call Chain = DL_I2C_setClockConfig

[Called By]

- >> SYSCFG_DL_I2C_0_init

DL_SYSCTL_configSYSPLL (Thumb, 196 bytes, Stack size 36 bytes, dl_sysctl_mspm0g1x0x_g3x0x.o(.text.DL_SYSCTL_configSYSPLL))

[Stack]

- Max Depth = 36
- Call Chain = DL_SYSCTL_configSYSPLL

[Called By]

- >> SYSCFG_DL_SYSCTL_init

DL_SYSCTL_setHFCLKSourceHFXTParams (Thumb, 80 bytes, Stack size 20 bytes, dl_sysctl_mspm0g1x0x_g3x0x.o(.text.DL_SYSCTL_setHFCLKSourceHFXTParams))

[Stack]

- Max Depth = 20
- Call Chain = DL_SYSCTL_setHFCLKSourceHFXTParams

[Called By]

- >> SYSCFG_DL_SYSCTL_init

DL_SYSCTL_switchMCLKfromSYSOSCtoHSCLK (Thumb, 40 bytes, Stack size 0 bytes, dl_sysctl_mspm0g1x0x_g3x0x.o(.text.DL_SYSCTL_switchMCLKfromSYSOSCtoHSCLK))

[Called By]

- >> SYSCFG_DL_SYSCTL_init

DL_UART_init (Thumb, 72 bytes, Stack size 16 bytes, dl_uart.o(.text.DL_UART_init))

[Stack]

- Max Depth = 16
- Call Chain = DL_UART_init

[Called By]

- >> SYSCFG_DL_UART_1_init
- >> SYSCFG_DL_UART_0_init

DL_UART_setClockConfig (Thumb, 18 bytes, Stack size 8 bytes, dl_uart.o(.text.DL_UART_setClockConfig))

[Stack]

- Max Depth = 8
- Call Chain = DL_UART_setClockConfig

[Called By]

- >> SYSCFG_DL_UART_1_init
- >> SYSCFG_DL_UART_0_init

IIC_ReadBytes (Thumb, 232 bytes, Stack size 48 bytes, software_iic.o(.text.IIC_ReadBytes))

[Stack]

- Max Depth = 120
- Call Chain = IIC_ReadBytes ⇒ IIC_RecvByte ⇒ delay_us

[Calls]

- >> IIC_RecvByte
- >> IIC_SendByte
- >> delay_us

[Called By]

- >> Ping
- >> main

IIC_RecvByte (Thumb, 268 bytes, Stack size 56 bytes, software_iic.o(.text.IIC_RecvByte))

[Stack]

- Max Depth = 72
- Call Chain = IIC_RecvByte ⇒ delay_us

[Calls]

- >> delay_us

[Called By]

- >> IIC_ReadBytes

IIC_SendByte (Thumb, 304 bytes, Stack size 24 bytes, software_iic.o(.text.IIC_SendByte))

[Stack]

- Max Depth = 40
- Call Chain = IIC_SendByte ⇒ delay_us

[Calls]

- >> delay_us

[Called By]

- >> IIC_WriteBytes
- >> IIC_ReadBytes
- >> i2c_reset

IIC_WriteBytes (Thumb, 144 bytes, Stack size 40 bytes, software_iic.o(.text.IIC_WriteBytes))

[Stack]

- Max Depth = 80
- Call Chain = IIC_WriteBytes ⇒ IIC_SendByte ⇒ delay_us

[Calls]

- >> IIC_SendByte
- >> delay_us

[Called By]

- >> main

Ping (Thumb, 30 bytes, Stack size 16 bytes, software_iic.o(.text.Ping))

[Stack]

- Max Depth = 136
- Call Chain = Ping ⇒ IIC_ReadBytes ⇒ IIC_RecvByte ⇒ delay_us

[Calls]

- >> IIC_ReadBytes

[Called By]

- >> main

SYSCFG_DL_ADC1_init (Thumb, 60 bytes, Stack size 8 bytes, ti_msp_dl_config.o(.text.SYSCFG_DL_ADC1_init))

[Stack]

- Max Depth = 24
- Call Chain = SYSCFG_DL_ADC1_init ⇒ DL_ADC12_setClockConfig

[Calls]

- >> DL_ADC12_setClockConfig

[Called By]

- >> SYSCFG_DL_init

SYSCFG_DL_DMA_CH0_init (Thumb, 16 bytes, Stack size 8 bytes, ti_msp_dl_config.o(.text.SYSCFG_DL_DMA_CH0_init))

[Stack]

- Max Depth = 24
- Call Chain = SYSCFG_DL_DMA_CH0_init ⇒ DL_DMA_initChannel

[Calls]

- >> DL_DMA_initChannel

[Called By]

- >> SYSCFG_DL_DMA_init

SYSCFG_DL_DMA_init (Thumb, 8 bytes, Stack size 8 bytes, ti_msp_dl_config.o(.text.SYSCFG_DL_DMA_init))

[Stack]

- Max Depth = 32
- Call Chain = SYSCFG_DL_DMA_init ⇒ SYSCFG_DL_DMA_CH0_init ⇒ DL_DMA_initChannel

[Calls]

- >> SYSCFG_DL_DMA_CH0_init

[Called By]

- >> SYSCFG_DL_init

SYSCFG_DL_GPIO_init (Thumb, 88 bytes, Stack size 0 bytes, ti_msp_dl_config.o(.text.SYSCFG_DL_GPIO_init))

[Called By]

- >> SYSCFG_DL_init

SYSCFG_DL_I2C_0_init (Thumb, 72 bytes, Stack size 8 bytes, ti_msp_dl_config.o(.text.SYSCFG_DL_I2C_0_init))

[Stack]

- Max Depth = 24
- Call Chain = SYSCFG_DL_I2C_0_init ⇒ DL_I2C_setClockConfig

[Calls]

- >> DL_I2C_setClockConfig

[Called By]

- >> SYSCFG_DL_init

SYSCFG_DL_SYSCTL_init (Thumb, 132 bytes, Stack size 24 bytes, ti_msp_dl_config.o(.text.SYSCFG_DL_SYSCTL_init))

[Stack]

- Max Depth = 60
- Call Chain = SYSCFG_DL_SYSCTL_init ⇒ DL_SYSCTL_configSYSPLL

[Calls]

- >> DL_SYSCTL_switchMCLKfromSYSOSCtoHSCLK
- >> DL_SYSCTL_configSYSPLL
- >> DL_SYSCTL_setHFCLKSourceHFXTParams

[Called By]

- >> SYSCFG_DL_init

SYSCFG_DL_SYSTICK_init (Thumb, 24 bytes, Stack size 0 bytes, ti_msp_dl_config.o(.text.SYSCFG_DL_SYSTICK_init))

[Called By]

- >> SYSCFG_DL_init

SYSCFG_DL_UART_0_init (Thumb, 76 bytes, Stack size 8 bytes, ti_msp_dl_config.o(.text.SYSCFG_DL_UART_0_init))

[Stack]

- Max Depth = 24
- Call Chain = SYSCFG_DL_UART_0_init ⇒ DL_UART_init

[Calls]

- >> DL_UART_init
- >> DL_UART_setClockConfig

[Called By]

- >> SYSCFG_DL_init

SYSCFG_DL_UART_1_init (Thumb, 92 bytes, Stack size 8 bytes, ti_msp_dl_config.o(.text.SYSCFG_DL_UART_1_init))

[Stack]

- Max Depth = 24
- Call Chain = SYSCFG_DL_UART_1_init ⇒ DL_UART_init

[Calls]

- >> DL_UART_init
- >> DL_UART_setClockConfig

[Called By]

- >> SYSCFG_DL_init

SYSCFG_DL_init (Thumb, 40 bytes, Stack size 8 bytes, ti_msp_dl_config.o(.text.SYSCFG_DL_init))

[Stack]

- Max Depth = 68
- Call Chain = SYSCFG_DL_init ⇒ SYSCFG_DL_SYSCTL_init ⇒ DL_SYSCTL_configSYSPLL

[Calls]

- >> SYSCFG_DL_SYSTICK_init
- >> SYSCFG_DL_DMA_init
- >> SYSCFG_DL_ADC1_init
- >> SYSCFG_DL_UART_1_init
- >> SYSCFG_DL_UART_0_init
- >> SYSCFG_DL_I2C_0_init
- >> SYSCFG_DL_SYSCTL_init
- >> SYSCFG_DL_GPIO_init
- >> SYSCFG_DL_initPower

[Called By]

- >> main

SYSCFG_DL_initPower (Thumb, 52 bytes, Stack size 16 bytes, ti_msp_dl_config.o(.text.SYSCFG_DL_initPower))

[Stack]

- Max Depth = 16
- Call Chain = SYSCFG_DL_initPower

[Calls]

- >> DL_Common_delayCycles

[Called By]

- >> SYSCFG_DL_init

delay_ms (Thumb, 64 bytes, Stack size 16 bytes, time.o(.text.delay_ms))

[Stack]

- Max Depth = 16
- Call Chain = delay_ms

[Called By]

- >> main

delay_us (Thumb, 64 bytes, Stack size 16 bytes, time.o(.text.delay_us))

[Stack]

- Max Depth = 16
- Call Chain = delay_us

[Called By]

- >> IIC_RecvByte
- >> IIC_SendByte
- >> IIC_WriteBytes
- >> IIC_ReadBytes
- >> i2c_reset

i2c_reset (Thumb, 176 bytes, Stack size 24 bytes, software_iic.o(.text.i2c_reset))

[Stack]

- Max Depth = 64
- Call Chain = i2c_reset ⇒ IIC_SendByte ⇒ delay_us

[Calls]

- >> IIC_SendByte
- >> delay_us

[Called By]

- >> main

main (Thumb, 412 bytes, Stack size 48 bytes, gpio_toggle_output.o(.text.main))

[Stack]

- Max Depth = 184 + Unknown Stack Size
- Call Chain = main ⇒ Ping ⇒ IIC_ReadBytes ⇒ IIC_RecvByte ⇒ delay_us

[Calls]

- >> IIC_WriteBytes
- >> IIC_ReadBytes
- >> delay_ms
- >> Ping
- >> uart0_send_string
- >> i2c_reset
- >> SYSCFG_DL_init
- >> __aeabi_memclr4
- >> __2sprintf

[Called By]

- >> __rt_entry_main

uart0_send_string (Thumb, 52 bytes, Stack size 0 bytes, uart.o(.text.uart0_send_string))

[Called By]

- >> main

### Local Symbols

_printf_input_char (Thumb, 10 bytes, Stack size 0 bytes, _printf_char_common.o(.text))
[Address Reference Count : 1]

- _printf_char_common.o(.text)

### Undefined Global Symbols

_call_atexit_fns (ARM, 0 bytes, Stack size 0 bytes, UNDEFINED)

[Called By]

- >> exit

_printf_post_padding (ARM, 0 bytes, Stack size 0 bytes, UNDEFINED)

[Called By]

- >> _printf_int_common

_printf_pre_padding (ARM, 0 bytes, Stack size 0 bytes, UNDEFINED)

[Called By]

- >> _printf_int_common

_printf_truncate_signed (ARM, 0 bytes, Stack size 0 bytes, UNDEFINED)

[Called By]

- >> _printf_int_dec

_printf_truncate_unsigned (ARM, 0 bytes, Stack size 0 bytes, UNDEFINED)

[Called By]

- >> _printf_int_dec
