VincentttWang/MSP430_WirelessCar/NUEDC_2026/[Demo] MSPM0_Car_v5/docs/interfaces/bsp_key.md

# bsp/key 接口说明

## 模块职责

`bsp/key` 负责板级按键读取、消抖和事件生成。接口、硬件配置表和状态数组都按多按键方式组织，当前实现三颗：

| ID | 引脚 | 用途 | 引脚初始化位置 |
| --- | --- | --- | --- |
| `KEY_ID_1` | PB21 | 板载用户键（菜单/确认） | SysConfig |
| `KEY_ID_DOWN` | PB25 | 巡线校准向导 | SysConfig |
| `KEY_ID_UP` | PA14 | OLED 页面切换（仪表盘 ⇄ 八路灰度监视） | `Key_Init()` 现场配置 |

该模块属于 BSP 层，只依赖：

- `board/sys_config/ti_msp_dl_config.h` 中的 GPIO 配置宏
- `bsp/time` 提供的毫秒时间源
- TI DriverLib 的 GPIO 读取接口

## 硬件映射宏

默认映射到 SysConfig 生成的 KEY1 引脚：

```c
#ifndef KEY1_PORT
#define KEY1_PORT Key_PORT
#endif

#ifndef KEY1_PIN
#define KEY1_PIN Key_PIN_1_PIN
#endif

#ifndef KEY1_ACTIVE_LOW
#define KEY1_ACTIVE_LOW 1U
#endif
```

如果后续改板或增加按键，可以在编译配置中覆盖这些宏，或在 `key.h` 中增加 `KEY2_PORT`、`KEY2_PIN`、`KEY2_ACTIVE_LOW`，再扩展内部 `s_key_hw[]` 配置表。

### UP 键（PA14）

`PA14` 没有进 SysConfig 的 Key 组，由 `Key_Init()` 现场按「上拉输入」配置：

```c
#ifndef KEY_UP_PORT
#define KEY_UP_PORT (GPIOA)
#endif
#ifndef KEY_UP_PIN
#define KEY_UP_PIN (DL_GPIO_PIN_14)
#endif
#ifndef KEY_UP_IOMUX
#define KEY_UP_IOMUX (IOMUX_PINCM36)
#endif
#ifndef KEY_UP_ACTIVE_LOW
#define KEY_UP_ACTIVE_LOW 1U
#endif
```

换脚或改板时改这四个宏即可，不需要重新生成 SysConfig。

## 时间参数宏

```c
#define KEY_DEBOUNCE_MS          20U
#define KEY_SHORT_PRESS_MIN_MS   50U
#define KEY_LONG_PRESS_MS        1000U
#define KEY_DOUBLE_CLICK_MS      300U
```

这些宏允许在编译期覆盖。当前不提供运行时配置接口，避免 BSP 驱动保存额外业务配置。

## 公开类型

### `KEY_ID`

```c
typedef enum {
    KEY_ID_1 = 0,
    KEY_ID_DOWN,
    KEY_ID_UP,
    KEY_ID_MAX
} KEY_ID;
```

### `KEY_EVENT`

```c
typedef enum {
    KEY_EVENT_NONE = 0,
    KEY_EVENT_SHORT_PRESS,
    KEY_EVENT_LONG_PRESS,
    KEY_EVENT_DOUBLE_CLICK
} KEY_EVENT;
```

事件类型仅描述稳定事件，不导出按下、释放、消抖等内部状态。

## 公开接口

### `void Key_Init(void)`

初始化按键内部状态。GPIO 初始化仍由 SysConfig 生成代码完成。

### `void Key_Scan(void)`

扫描并推进按键状态机。当前由 `SysTick_Handler()` 每 10 ms 调用。

### `KEY_EVENT Key_GetEvent(KEY_ID key_id)`

读取并消费指定按键的待处理事件。无事件或 `key_id` 非法时返回 `KEY_EVENT_NONE`。

### `bool Key_IsPressed(KEY_ID key_id)`

返回指定按键的稳定按下状态。

### `bool Key_IsShortPress(KEY_ID key_id)`

仅当待处理事件为短按时返回 `true`，并消费该事件；如果当前是长按或双击事件，不会误清除。

普通短按需要等待 `KEY_DOUBLE_CLICK_MS` 双击窗口超时后才会生成，因此它适合用于需要同时区分单击和双击的菜单逻辑。

### `bool Key_IsShortRelease(KEY_ID key_id)`

短按释放消抖完成后立即返回 `true`，不等待双击窗口超时。该接口被消费后，本次点击后续不会再生成普通短按事件。

该接口主要用于需要低延迟响应的测试动作，例如 `Device check` 中的 yaw/pitch 步进电机点动测试。使用时需要注意：它无法在触发前等待判断用户是否还会继续第二次点击，因此不适合替代普通菜单中的单击确认逻辑。

### `bool Key_IsLongPress(KEY_ID key_id)`

仅当待处理事件为长按时返回 `true`，并消费该事件。

### `bool Key_IsDoubleClick(KEY_ID key_id)`

仅当待处理事件为双击时返回 `true`，并消费该事件。

### `void Key_ClearEvent(KEY_ID key_id)`

清除指定按键的待处理事件。

### `void Key_ClearAllEvents(void)`

清除所有按键的待处理事件。

## 兼容宏

为了降低本轮重写对上层应用的影响，保留单按键便捷宏：

```c
#define Key_Read()         Key_IsPressed(KEY_ID_1)
#define Key_short_press()  Key_IsShortPress(KEY_ID_1)
#define Key_long_press()   Key_IsLongPress(KEY_ID_1)
#define Key_double_click() Key_IsDoubleClick(KEY_ID_1)

#define Key_Down_IsPressed()      Key_IsPressed(KEY_ID_DOWN)
#define Key_Down_IsShortPress()   Key_IsShortPress(KEY_ID_DOWN)
#define Key_Up_IsPressed()        Key_IsPressed(KEY_ID_UP)
#define Key_Up_IsShortPress()     Key_IsShortPress(KEY_ID_UP)
```

后续如果上层流程统一改用 `Key_GetEvent()`，可以再考虑移除这些兼容宏。
