VincentttWang/MSP430_WirelessCar/docs/images/report/fig4-1.png

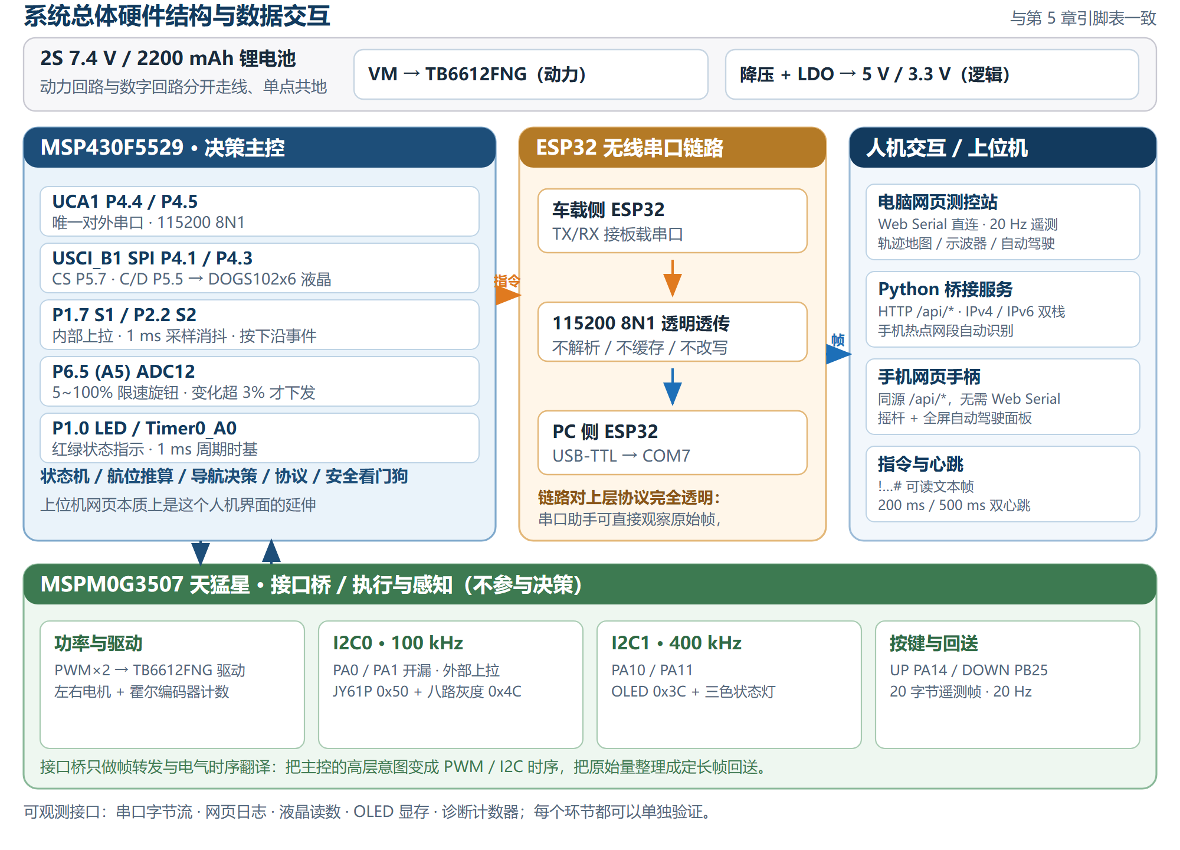
docs/images/report/fig4-1.png
