VincentttWang/MSP430_WirelessCar/docs/images/report/source/car_calib.jpg

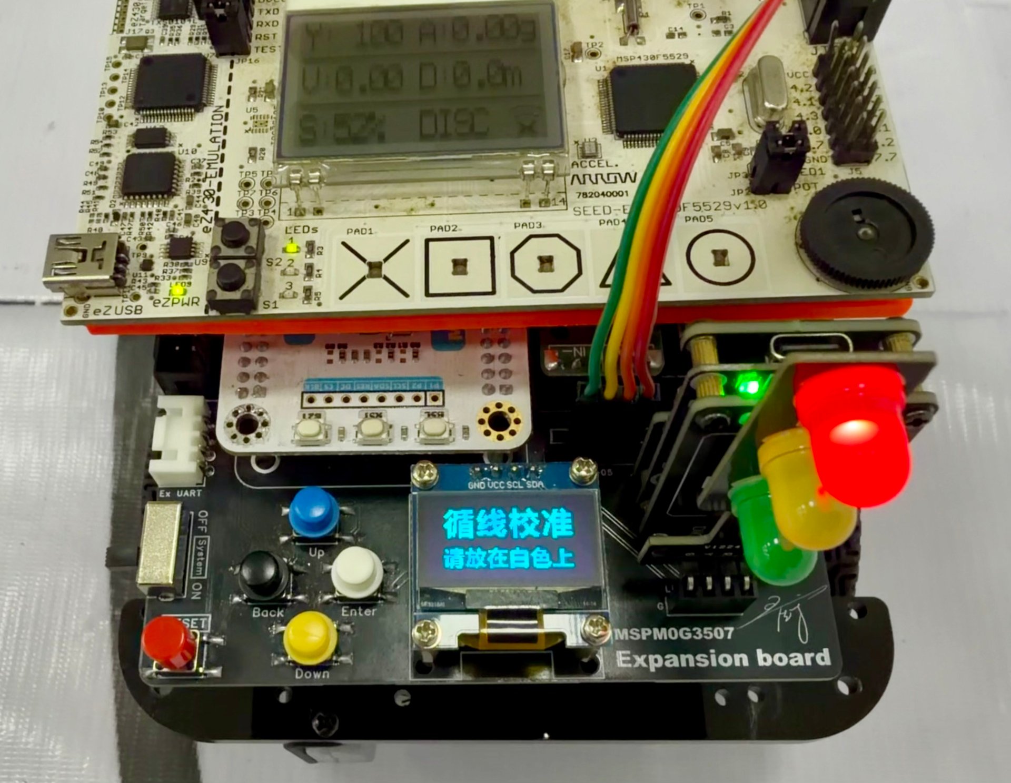
docs/images/report/source/car_calib.jpg
