VincentttWang/MSP430_WirelessCar/docs/images/report/source/car_dual_display.jpg

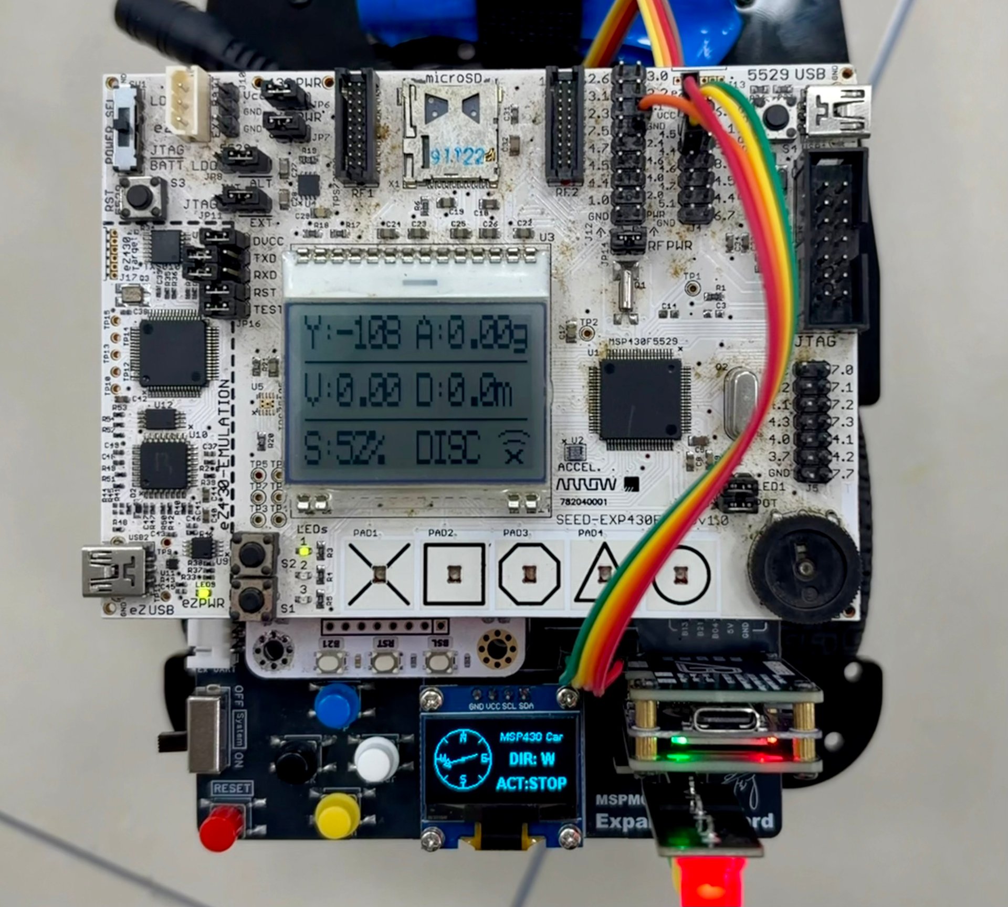
docs/images/report/source/car_dual_display.jpg
