VincentttWang/MSP430_WirelessCar/docs/images/report/source/car_gray_monitor.jpg

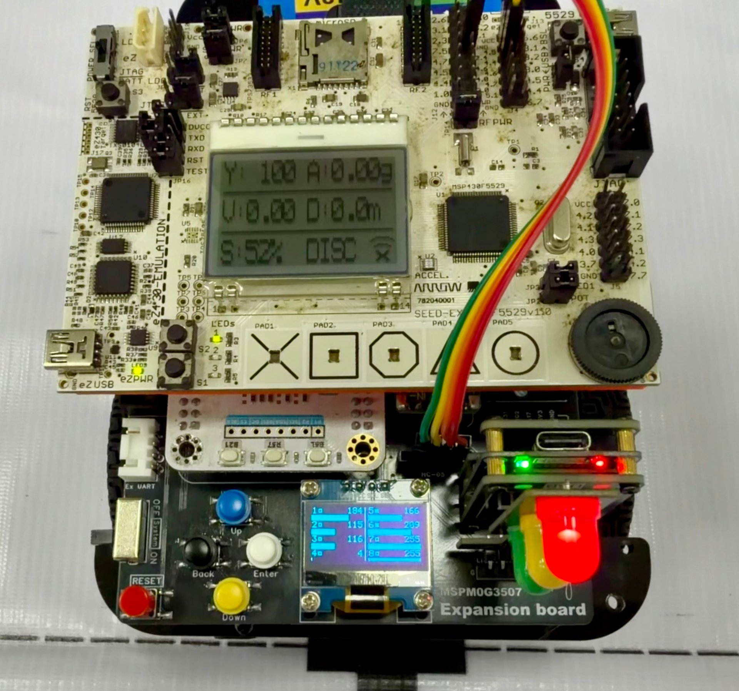
docs/images/report/source/car_gray_monitor.jpg
