VincentttWang/MSP430_WirelessCar/docs/images/tb6612_crop.png

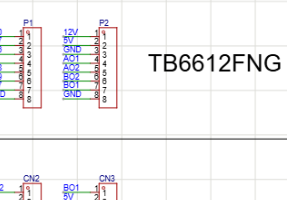
docs/images/tb6612_crop.png
