VincentttWang/MSP430_WirelessCar/docs/MSP430选题_U202413712_王佳宁/figures/fig6_dogs102_lcd.png

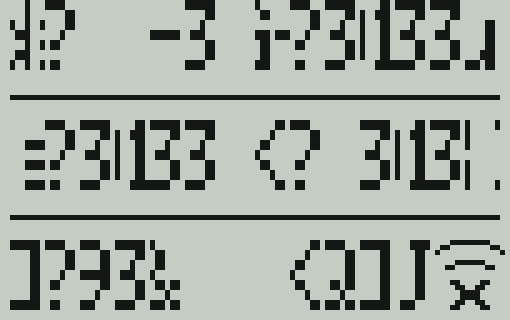
docs/MSP430选题_U202413712_王佳宁/figures/fig6_dogs102_lcd.png
