VincentttWang/MSP430_WirelessCar/docs/hardware/SCH_天猛星小车拓展板v5.pdf

# TB6612FNG

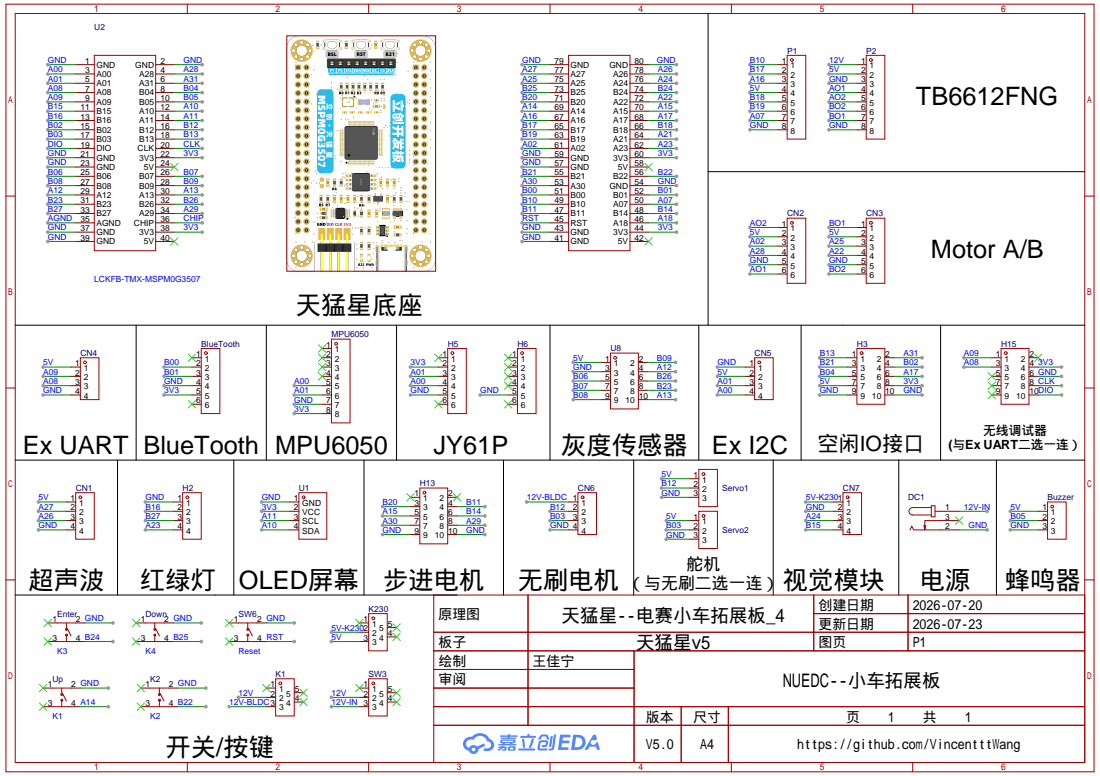
[picture p36: page 1]

更新日期 | 2026-07-23

板子 | 天猛星v5 | 图页 | P1
绘制 | 王佳宁 | NUEDC--小车拓展板
审阅

V5.0 | A4 | https://github.com/VincentttWang
