VincentttWang/MSP430_WirelessCar/firmware_MSP430F5529/HAL_Board.c

/*******************************************************************************
 *
 *  HAL_Board.c - General experimenter's board port initialization and control
 *
 *  Copyright (C) 2010 Texas Instruments Incorporated - http://www.ti.com/
 *
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
 *    Redistributions of source code must retain the above copyright
 *    notice, this list of conditions and the following disclaimer.
 *
 *    Redistributions in binary form must reproduce the above copyright
 *    notice, this list of conditions and the following disclaimer in the
 *    documentation and/or other materials provided with the
 *    distribution.
 *
 *    Neither the name of Texas Instruments Incorporated nor the names of
 *    its contributors may be used to endorse or promote products derived
 *    from this software without specific prior written permission.
 *
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
 ******************************************************************************/

/***************************************************************************//**
 * @file       HAL_Board.c
 * @addtogroup HAL_Board
 * @{
 ******************************************************************************/
#include "msp430.h"
#include "HAL_Board.h"

#define XT1_XT2_PORT_DIR            P5DIR
#define XT1_XT2_PORT_OUT            P5OUT
#define XT1_XT2_PORT_SEL            P5SEL
#define XT1_ENABLE                  (BIT4 + BIT5)
#define XT2_ENABLE                  (BIT2 + BIT3)

#define LED145678_PORT_DIR          P1DIR
#define LED145678_PORT_OUT          P1OUT
#define LED23_PORT_DIR              P8DIR
#define LED23_PORT_OUT              P8OUT

/***************************************************************************//**
 * @brief  Initialize the board - configure ports
 * @param  None
 * @return none
 ******************************************************************************/

void Board_init(void)
{
    // Setup XT1 and XT2
    XT1_XT2_PORT_SEL |= XT1_ENABLE;

    // Configure LED ports
    LED145678_PORT_OUT &= ~(BIT0 + BIT1 + BIT2 + BIT3 + BIT4 + BIT5);
    LED145678_PORT_DIR |= BIT0 + BIT1 + BIT2 + BIT3 + BIT4 + BIT5;
    LED23_PORT_OUT &= ~(BIT1 + BIT2);
    LED23_PORT_DIR |= BIT1 + BIT2;

    // Configure button ports
    PADIR &= ~0x0480;               // Buttons on P1.7/P2.2 are inputs

    // Configure CapTouch ports
    P1OUT &= ~0x7E;
    P1DIR |= 0x7E;
    P6OUT = 0x00;
    P6DIR = 0x00;

    // Configure Cma3000 ports
    P2DIR &= ~BIT5;                 // ACCEL_INT pin is input
    P2OUT &= ~BIT7;                 // SCK
    P2DIR |= BIT7;
    P3OUT &= ~(BIT3 + BIT5 + BIT6); // ACCEL_SIMO, ACCEL_CS, ACCEL_PWR to low
    P3DIR &= ~BIT4;                 // ACCEL_SOMI pin is input
    P3DIR |= BIT3 + BIT5 + BIT6;    // ACCEL_SIMO, ACCEL_CS, ACCEL_PWR as outp

    // Configure Dogs102x6 ports
    P5OUT &= ~(BIT6 + BIT7);        // LCD_C/D, LCD_RST
    P5DIR |= BIT6 + BIT7;
    P7OUT &= ~(BIT4 + BIT6);        // LCD_CS, LCD_BL_EN
    P7DIR |= BIT4 + BIT6;
    P4OUT &= ~(BIT1 + BIT3);        // SIMO, SCK
    P4DIR &= ~BIT2;                 // SOMI pin is input
    P4DIR |= BIT1 + BIT3;

    // Configure SDCard ports
    P3OUT |= BIT7;                  // SD_CS to high
    P3DIR |= BIT7;

    // Configure Wheel ports
    P6DIR &= ~BIT5;                 // A5 ADC input
    P8OUT &= ~BIT0;                 // POT_PWR
    P8DIR |= BIT0;

    // Configure unused ports for low power
    P2OUT &= ~(BIT0 + BIT1 + BIT3 + BIT4 + BIT6);
    P2DIR |= BIT0 + BIT1 + BIT3 + BIT4 + BIT6;

    P3OUT &= ~(BIT0 + BIT1 + BIT2);
    P3DIR |= BIT0 + BIT1 + BIT2;

    P4OUT &= ~(BIT0 + BIT6 + BIT7);
    P4DIR |= BIT0 + BIT6 + BIT7;

    P5OUT &= ~BIT1;
    P5DIR |= BIT1;

    P6OUT &= ~(BIT6 + BIT7);
    P6DIR |= BIT6 + BIT7;

    P7OUT &= ~(BIT0 + BIT1 + BIT2 + BIT3 + BIT5 + BIT7);
    P7DIR |= BIT0 + BIT1 + BIT2 + BIT3 + BIT5 + BIT7;
}

/***************************************************************************//**
 * @brief  Turn on LEDs
 * @param  ledMask   Use values defined in HAL_board.h for the LEDs to turn on
 * @return none
 ******************************************************************************/

void Board_ledOn(uint8_t ledMask)
{
    if (ledMask & LED1) LED145678_PORT_OUT |= BIT0;
    if (ledMask & LED2) LED23_PORT_OUT |= BIT1;
    if (ledMask & LED3) LED23_PORT_OUT |= BIT2;
    if (ledMask & LED4) LED145678_PORT_OUT |= BIT1;
    if (ledMask & LED5) LED145678_PORT_OUT |= BIT2;
    if (ledMask & LED6) LED145678_PORT_OUT |= BIT3;
    if (ledMask & LED7) LED145678_PORT_OUT |= BIT4;
    if (ledMask & LED8) LED145678_PORT_OUT |= BIT5;
}

/***************************************************************************//**
 * @brief  Turn off LEDs
 * @param  ledMask   Use values defined in HAL_board.h for the LEDs to turn off
 * @return none
 ******************************************************************************/

void Board_ledOff(uint8_t ledMask)
{
    if (ledMask & LED1) LED145678_PORT_OUT &= ~BIT0;
    if (ledMask & LED2) LED23_PORT_OUT &= ~BIT1;
    if (ledMask & LED3) LED23_PORT_OUT &= ~BIT2;
    if (ledMask & LED4) LED145678_PORT_OUT &= ~BIT1;
    if (ledMask & LED5) LED145678_PORT_OUT &= ~BIT2;
    if (ledMask & LED6) LED145678_PORT_OUT &= ~BIT3;
    if (ledMask & LED7) LED145678_PORT_OUT &= ~BIT4;
    if (ledMask & LED8) LED145678_PORT_OUT &= ~BIT5;
}

/***************************************************************************//**
 * @brief  Toggle LEDs
 * @param  ledMask   Use values defined in HAL_board.h for the LEDs to toggle
 * @return none
 ******************************************************************************/

void Board_ledToggle(uint8_t ledMask)
{
    if (ledMask & LED1) LED145678_PORT_OUT ^= BIT0;
    if (ledMask & LED2) LED23_PORT_OUT ^= BIT1;
    if (ledMask & LED3) LED23_PORT_OUT ^= BIT2;
    if (ledMask & LED4) LED145678_PORT_OUT ^= BIT1;
    if (ledMask & LED5) LED145678_PORT_OUT ^= BIT2;
    if (ledMask & LED6) LED145678_PORT_OUT ^= BIT3;
    if (ledMask & LED7) LED145678_PORT_OUT ^= BIT4;
    if (ledMask & LED8) LED145678_PORT_OUT ^= BIT5;
}

/***************************************************************************//**
 * @}
 ******************************************************************************/
