VincentttWang/MSP430_WirelessCar/firmware_MSP430F5529/HAL_UCS.c

/*******************************************************************************
 *
 * HAL_UCS.c
 * Provides Functions to Initialize the UCS/FLL and clock sources
 * 
 *
 * Copyright (C) 2010 Texas Instruments Incorporated - http://www.ti.com/ 
 * 
 * 
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
 *    Redistributions of source code must retain the above copyright 
 *    notice, this list of conditions and the following disclaimer.
 *
 *    Redistributions in binary form must reproduce the above copyright
 *    notice, this list of conditions and the following disclaimer in the 
 *    documentation and/or other materials provided with the   
 *    distribution.
 *
 *    Neither the name of Texas Instruments Incorporated nor the names of
 *    its contributors may be used to endorse or promote products derived
 *    from this software without specific prior written permission.
 *
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
 * Created: Version 1.0 11/24/2009
 * Updated: Version 2.0 12/15/2010
 *          Added Functions: XT2_Stop() and XT1_Stop()
 *          Modified all functions to preserve drive settings
 *  
 ******************************************************************************/

#include "msp430.h"
#include "HAL_UCS.h"

/*******************************************************************************
 * Check and define required Defines
 ******************************************************************************/
#ifndef XT1LFOFFG               // Defines if not available in header file
#define XT1LFOFFG   0
#endif

#ifndef XT1HFOFFG               // Defines if not available in header file
#define XT1HFOFFG   0
#endif

#ifndef XT2OFFG                 // Defines if not available in header file
#define XT2OFFG     0
#endif

#ifndef XTS                     // Defines if not available in header file
#define XTS         0
#endif

#ifndef XT2DRIVE_3              // Defines if not available in header file
#define XT2DRIVE_3  0
#endif

void LFXT_Start(uint16_t xtdrive)
{
  uint16_t timeout = 50000;
  // If the drive setting is not already set to maximum
  // Set it to max for LFXT startup
  if ((UCSCTL6 & XT1DRIVE_3)!= XT1DRIVE_3) { 
    UCSCTL6_L |= XT1DRIVE1_L + XT1DRIVE0_L; // Highest drive setting for XT1startup
  }

  while ((SFRIFG1 & OFIFG) && timeout--) {   // Check OFIFG fault flag with timeout
    UCSCTL7 &= ~(DCOFFG+XT1LFOFFG+XT1HFOFFG+XT2OFFG); // Clear OSC fault flags
    SFRIFG1 &= ~OFIFG;        // Clear OFIFG fault flag
  }
  
  UCSCTL6 = (UCSCTL6 & ~(XT1DRIVE_3)) | (xtdrive); // set requested Drive mode
}

uint16_t LFXT_Start_Timeout(uint16_t xtdrive, uint16_t timeout)
{
 // If the drive setting is not already set to maximum
  // Set it to max for LFXT startup
  if ((UCSCTL6 & XT1DRIVE_3)!= XT1DRIVE_3) { 
   UCSCTL6_L |= XT1DRIVE1_L+XT1DRIVE0_L; // Highest drive setting for XT1startup
  }

  while ((SFRIFG1 & OFIFG) && timeout--){   // Check OFIFG fault flag
    UCSCTL7 &= ~(DCOFFG+XT1LFOFFG+XT1HFOFFG+XT2OFFG); // Clear OSC flaut Flags fault flags
    SFRIFG1 &= ~OFIFG;        // Clear OFIFG fault flag
  }
  
  UCSCTL6 = (UCSCTL6 & ~(XT1DRIVE_3)) |(xtdrive); // set Drive mode
  
  if (timeout)
    return (UCS_STATUS_OK);
  else
    return (UCS_STATUS_ERROR);
}

void XT1_Start(uint16_t xtdrive)
{
  // Check if drive value is the expected one
  if ((UCSCTL6 & XT1DRIVE_3) != xtdrive) {
    UCSCTL6 &= ~XT1DRIVE_3;                 // Clear XT1drive field
    UCSCTL6 |= xtdrive;                     // Set requested value
  }
  
  UCSCTL6 &= ~XT1OFF;                       // Enable XT1
  UCSCTL6 |= XTS;                           // Enable HF mode

  while (SFRIFG1 & OFIFG) {   // Check OFIFG fault flag
    UCSCTL7 &= ~(DCOFFG+XT1LFOFFG+XT1HFOFFG+XT2OFFG); // Clear OSC flaut Flags
    SFRIFG1 &= ~OFIFG;        // Clear OFIFG fault flag
  }
}

uint16_t XT1_Start_Timeout(uint16_t xtdrive, uint16_t timeout)
{
  // Check if drive value is the expected one
  if ((UCSCTL6 & XT1DRIVE_3) != xtdrive) {
    UCSCTL6 &= ~XT1DRIVE_3;                 // Clear XT1drive field
    UCSCTL6 |= xtdrive;                     // Set requested value
  }
  
  UCSCTL6 &= ~XT1OFF;                       // Enable XT1
  UCSCTL6 |= XTS;                           // Enable HF mode

  while ((SFRIFG1 & OFIFG) && timeout--) {  // Check OFIFG fault flag
    UCSCTL7 &= ~(DCOFFG+XT1LFOFFG+XT1HFOFFG+XT2OFFG); // Clear OSC flaut Flags
    SFRIFG1 &= ~OFIFG;                      // Clear OFIFG fault flag
  }
  
  if (timeout) {
    return UCS_STATUS_OK;
  }
  else {
    return UCS_STATUS_ERROR;
  }
}

void XT1_Bypass(void)
{
  UCSCTL6 |= XT1BYPASS;

  while (SFRIFG1 & OFIFG) {   // Check OFIFG fault flag
    UCSCTL7 &= ~(DCOFFG+XT1LFOFFG+XT1HFOFFG+XT2OFFG); // Clear OSC flaut Flags
    SFRIFG1 &= ~OFIFG;        // Clear OFIFG fault flag
  }
}

void XT1_Stop(void)
{
  UCSCTL6 |= XT1OFF;                         // Switch off XT1 oscillator
}

void XT2_Start(uint16_t xtdrive)
{
  // Check if drive value is the expected one
  if ((UCSCTL6 & XT2DRIVE_3) != xtdrive) {
    UCSCTL6 &= ~XT2DRIVE_3;                 // Clear XT2drive field
    UCSCTL6 |= xtdrive;                     // Set requested value
  }
  
  UCSCTL6 &= ~XT2OFF; 
  
  while (SFRIFG1 & OFIFG) {                 // Check OFIFG fault flag
    UCSCTL7 &= ~(DCOFFG+XT1LFOFFG+XT1HFOFFG+XT2OFFG); // Clear OSC flaut Flags
    SFRIFG1 &= ~OFIFG;                      // Clear OFIFG fault flag
  }
}

uint16_t XT2_Start_Timeout(uint16_t xtdrive, uint16_t timeout)
{
  // Check if drive value is the expected one
  if ((UCSCTL6 & XT2DRIVE_3) != xtdrive)  {
    UCSCTL6 &= ~XT2DRIVE_3;                 // Clear XT2drive field
    UCSCTL6 |= xtdrive;                     // Set requested value
  }
  
  UCSCTL6 &= ~XT2OFF; 

  while ((SFRIFG1 & OFIFG) && timeout--) {  // Check OFIFG fault flag
    UCSCTL7 &= ~(DCOFFG+XT1LFOFFG+XT1HFOFFG+XT2OFFG); // Clear OSC flaut Flags
    SFRIFG1 &= ~OFIFG;        // Clear OFIFG fault flag
  }
  
  if (timeout) {
    return UCS_STATUS_OK;
  }
  else {
    return UCS_STATUS_ERROR;
  }
}

void XT2_Bypass(void)
{
#ifdef XT2BYPASS              // On devices without XT2 this function will be empty
  UCSCTL6 |= XT2BYPASS;

  while (SFRIFG1 & OFIFG) {   // Check OFIFG fault flag
    UCSCTL7 &= ~(DCOFFG+XT1LFOFFG+XT1HFOFFG+XT2OFFG); // Clear OSC flaut Flags
    SFRIFG1 &= ~OFIFG;        // Clear OFIFG fault flag
  }
#endif
}

void XT2_Stop(void)
{
  UCSCTL6 |= XT2OFF;                         // Switch off XT2 oscillator
}

void Init_FLL_Settle(uint16_t fsystem, uint16_t ratio)
{
  volatile uint16_t x = ratio * 32;       

  Init_FLL(fsystem, ratio);
  
  while (x--) {
   __delay_cycles(30); 
  }
}

void Init_FLL(uint16_t fsystem, uint16_t ratio)
{
  uint16_t d, dco_div_bits;
  uint16_t mode = 0;

  // Save actual state of FLL loop control, then disable it. This is needed to
  // prevent the FLL from acting as we are making fundamental modifications to
  // the clock setup.
  uint16_t srRegisterState = __get_SR_register() & SCG0;
  __bic_SR_register(SCG0);  
  
  d = ratio;
  dco_div_bits = FLLD__2;        // Have at least a divider of 2
  
  if (fsystem > 16000) {
    d >>= 1 ;
    mode = 1;
  }
  else {
    fsystem <<= 1;               // fsystem = fsystem * 2
  }

  while (d > 512) {
    dco_div_bits = dco_div_bits + FLLD0;  // Set next higher div level
    d >>= 1;
  }

  UCSCTL0 = 0x0000;              // Set DCO to lowest Tap

  UCSCTL2 &= ~(0x03FF);          // Reset FN bits
  UCSCTL2 = dco_div_bits | (d - 1);

  if (fsystem <= 630)            //           fsystem < 0.63MHz
	UCSCTL1 = DCORSEL_0;
  else if (fsystem <  1250)      // 0.63MHz < fsystem < 1.25MHz
	UCSCTL1 = DCORSEL_1;
  else if (fsystem <  2500)      // 1.25MHz < fsystem <  2.5MHz
	UCSCTL1 = DCORSEL_2;
  else if (fsystem <  5000)      // 2.5MHz  < fsystem <    5MHz
	UCSCTL1 = DCORSEL_3;
  else if (fsystem <  10000)     // 5MHz    < fsystem <   10MHz
	UCSCTL1 = DCORSEL_4;
  else if (fsystem <  20000)     // 10MHz   < fsystem <   20MHz
	UCSCTL1 = DCORSEL_5;
  else if (fsystem <  40000)     // 20MHz   < fsystem <   40MHz
	UCSCTL1 = DCORSEL_6;
  else
	UCSCTL1 = DCORSEL_7;

  uint16_t fll_timeout = 50000;
  while ((SFRIFG1 & OFIFG) && fll_timeout--) {            // Check OFIFG fault flag with timeout
    UCSCTL7 &= ~(DCOFFG+XT1LFOFFG+XT1HFOFFG+XT2OFFG);     // Clear OSC fault flags
    SFRIFG1 &= ~OFIFG;                                    // Clear OFIFG fault flag
  }

  if (mode == 1) {                              		  // fsystem > 16000
    SELECT_MCLK_SMCLK(SELM__DCOCLK + SELS__DCOCLK);       // Select DCOCLK
  }
  else {
    SELECT_MCLK_SMCLK(SELM__DCOCLKDIV + SELS__DCOCLKDIV); // Select DCODIVCLK
  }
  
  __bis_SR_register(srRegisterState);	                  // Restore previous SCG0
}
