VincentttWang/MSP430_WirelessCar/NUEDC_2026/[Doc] Hardware/感为灰度Keil_MSPM0例程/examples/Hardware_IIC/keil/User/hardware_iic.h

#include "IIC.h"
#include "gw_grayscale_sensor.h"
unsigned char Ping(void);
unsigned char IIC_Get_Digtal(void);
unsigned char IIC_Get_Anolog(unsigned char * Result,unsigned char len);
unsigned char IIC_Get_Single_Anolog(unsigned char Channel);
unsigned char IIC_Get_Normalize(unsigned char * Result,unsigned char len);
unsigned short IIC_Get_Offset(void );
unsigned char IIC_ReadByte(unsigned char Salve_Adress,unsigned char Reg_Address);
unsigned char IIC_ReadBytes(unsigned char Salve_Adress,unsigned char Reg_Address,unsigned char *Result,unsigned char len);
unsigned char IIC_WriteByte(unsigned char Salve_Adress,unsigned char Reg_Address,unsigned char data);
unsigned char IIC_WriteBytes(unsigned char Salve_Adress,unsigned char Reg_Address,unsigned char *data,unsigned char len);
void i2c_reset(void);
