VincentttWang/MSP430_WirelessCar/NUEDC_2026/[Doc] Hardware/感为灰度Keil_MSPM0例程/examples/Software_IIC/keil/User/hardware_iic.h

#include "IIC.h"
#include "gw_color_sensor.h"
unsigned char Ping(void);
unsigned char IIC_Get_HSL(unsigned char * Result,unsigned char len);
unsigned char IIC_Get_RGB(unsigned char * Result,unsigned char len);
