VincentttWang/MSP430_WirelessCar/NUEDC_2026/[Demo] MSPM0_Car_v5/board/sys_config/ti_msp_dl_config.c

/*
 * Copyright (c) 2023, Texas Instruments Incorporated
 * All rights reserved.
 *
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
 * *  Redistributions of source code must retain the above copyright
 *    notice, this list of conditions and the following disclaimer.
 *
 * *  Redistributions in binary form must reproduce the above copyright
 *    notice, this list of conditions and the following disclaimer in the
 *    documentation and/or other materials provided with the distribution.
 *
 * *  Neither the name of Texas Instruments Incorporated nor the names of
 *    its contributors may be used to endorse or promote products derived
 *    from this software without specific prior written permission.
 *
 * THIS SOFTWARE IS PROVIDED BY THE COPYRIGHT HOLDERS AND CONTRIBUTORS "AS IS"
 * AND ANY EXPRESS OR IMPLIED WARRANTIES, INCLUDING, BUT NOT LIMITED TO,
 * THE IMPLIED WARRANTIES OF MERCHANTABILITY AND FITNESS FOR A PARTICULAR
 * PURPOSE ARE DISCLAIMED. IN NO EVENT SHALL THE COPYRIGHT OWNER OR
 * CONTRIBUTORS BE LIABLE FOR ANY DIRECT, INDIRECT, INCIDENTAL, SPECIAL,
 * EXEMPLARY, OR CONSEQUENTIAL DAMAGES (INCLUDING, BUT NOT LIMITED TO,
 * PROCUREMENT OF SUBSTITUTE GOODS OR SERVICES; LOSS OF USE, DATA, OR PROFITS;
 * OR BUSINESS INTERRUPTION) HOWEVER CAUSED AND ON ANY THEORY OF LIABILITY,
 * WHETHER IN CONTRACT, STRICT LIABILITY, OR TORT (INCLUDING NEGLIGENCE OR
 * OTHERWISE) ARISING IN ANY WAY OUT OF THE USE OF THIS SOFTWARE,
 * EVEN IF ADVISED OF THE POSSIBILITY OF SUCH DAMAGE.
 */

/*
 *  ============ ti_msp_dl_config.c =============
 *  Configured MSPM0 DriverLib module definitions
 *
 *  DO NOT EDIT - This file is generated for the MSPM0G350X
 *  by the SysConfig tool.
 */

#include "ti_msp_dl_config.h"

DL_TimerG_backupConfig gMotorBackup;
DL_TimerG_backupConfig gSMotor_1Backup;
DL_TimerA_backupConfig gTIMER_0Backup;

/*
 *  ======== SYSCFG_DL_init ========
 *  Perform any initialization needed before using any board APIs
 */
SYSCONFIG_WEAK void SYSCFG_DL_init(void)
{
    SYSCFG_DL_initPower();
    SYSCFG_DL_GPIO_init();
    /* Module-Specific Initializations*/
    SYSCFG_DL_SYSCTL_init();
    SYSCFG_DL_Motor_init();
    SYSCFG_DL_MotorA_init();
    SYSCFG_DL_SMotor_1_init();
    SYSCFG_DL_SMotor_2_init();
    SYSCFG_DL_TIMER_0_init();
    SYSCFG_DL_OLED_init();
    SYSCFG_DL_Gray_JY61P_I2C_init();
    SYSCFG_DL_Debug_init();
    SYSCFG_DL_Wireless_init();
    SYSCFG_DL_K230_init();
    SYSCFG_DL_SYSTICK_init();
    /* Ensure backup structures have no valid state */
	gMotorBackup.backupRdy 	= false;
	gSMotor_1Backup.backupRdy 	= false;
	gTIMER_0Backup.backupRdy 	= false;


}
/*
 * User should take care to save and restore register configuration in application.
 * See Retention Configuration section for more details.
 */
SYSCONFIG_WEAK bool SYSCFG_DL_saveConfiguration(void)
{
    bool retStatus = true;

	retStatus &= DL_TimerG_saveConfiguration(Motor_INST, &gMotorBackup);
	retStatus &= DL_TimerG_saveConfiguration(SMotor_1_INST, &gSMotor_1Backup);
	retStatus &= DL_TimerA_saveConfiguration(TIMER_0_INST, &gTIMER_0Backup);

    return retStatus;
}


SYSCONFIG_WEAK bool SYSCFG_DL_restoreConfiguration(void)
{
    bool retStatus = true;

	retStatus &= DL_TimerG_restoreConfiguration(Motor_INST, &gMotorBackup, false);
	retStatus &= DL_TimerG_restoreConfiguration(SMotor_1_INST, &gSMotor_1Backup, false);
	retStatus &= DL_TimerA_restoreConfiguration(TIMER_0_INST, &gTIMER_0Backup, false);

    return retStatus;
}

SYSCONFIG_WEAK void SYSCFG_DL_initPower(void)
{
    DL_GPIO_reset(GPIOA);
    DL_GPIO_reset(GPIOB);
    DL_TimerG_reset(Motor_INST);
    DL_TimerG_reset(MotorA_INST);
    DL_TimerG_reset(SMotor_1_INST);
    DL_TimerG_reset(SMotor_2_INST);
    DL_TimerA_reset(TIMER_0_INST);
    DL_I2C_reset(OLED_INST);
    DL_I2C_reset(Gray_JY61P_I2C_INST);
    DL_UART_Main_reset(Debug_INST);
    DL_UART_Main_reset(Wireless_INST);
    DL_UART_Main_reset(K230_INST);


    DL_GPIO_enablePower(GPIOA);
    DL_GPIO_enablePower(GPIOB);
    DL_TimerG_enablePower(Motor_INST);
    DL_TimerG_enablePower(MotorA_INST);
    DL_TimerG_enablePower(SMotor_1_INST);
    DL_TimerG_enablePower(SMotor_2_INST);
    DL_TimerA_enablePower(TIMER_0_INST);
    DL_I2C_enablePower(OLED_INST);
    DL_I2C_enablePower(Gray_JY61P_I2C_INST);
    DL_UART_Main_enablePower(Debug_INST);
    DL_UART_Main_enablePower(Wireless_INST);
    DL_UART_Main_enablePower(K230_INST);

    delay_cycles(POWER_STARTUP_DELAY);
}

SYSCONFIG_WEAK void SYSCFG_DL_GPIO_init(void)
{
    /* 初始化三色 LED (H2: PB16红, PB27黄, PA23绿) */
    DL_GPIO_initDigitalOutputFeatures(LED_R_IOMUX,
        DL_GPIO_INVERSION_DISABLE, DL_GPIO_RESISTOR_PULL_DOWN,
        DL_GPIO_DRIVE_STRENGTH_LOW, DL_GPIO_HIZ_DISABLE);
    DL_GPIO_initDigitalOutputFeatures(LED_Y_IOMUX,
        DL_GPIO_INVERSION_DISABLE, DL_GPIO_RESISTOR_PULL_DOWN,
        DL_GPIO_DRIVE_STRENGTH_LOW, DL_GPIO_HIZ_DISABLE);
    DL_GPIO_initDigitalOutputFeatures(LED_G_IOMUX,
        DL_GPIO_INVERSION_DISABLE, DL_GPIO_RESISTOR_PULL_DOWN,
        DL_GPIO_DRIVE_STRENGTH_LOW, DL_GPIO_HIZ_DISABLE);

    /* 初始未连接状态：红灯亮，黄灯灭，绿灯灭 */
    DL_GPIO_setPins(LED_R_PORT, LED_R_PIN);
    DL_GPIO_clearPins(LED_Y_PORT, LED_Y_PIN);
    DL_GPIO_clearPins(LED_G_PORT, LED_G_PIN);
    DL_GPIO_enableOutput(LED_R_PORT, LED_R_PIN);
    DL_GPIO_enableOutput(LED_Y_PORT, LED_Y_PIN);
    DL_GPIO_enableOutput(LED_G_PORT, LED_G_PIN);


    DL_GPIO_initPeripheralOutputFunction(GPIO_Motor_C0_IOMUX,GPIO_Motor_C0_IOMUX_FUNC);
    DL_GPIO_enableOutput(GPIO_Motor_C0_PORT, GPIO_Motor_C0_PIN);
    DL_GPIO_initPeripheralOutputFunction(GPIO_Motor_C1_IOMUX,GPIO_Motor_C1_IOMUX_FUNC);
    DL_GPIO_enableOutput(GPIO_Motor_C1_PORT, GPIO_Motor_C1_PIN);
    DL_GPIO_initPeripheralOutputFunction(GPIO_SMotor_1_C0_IOMUX,GPIO_SMotor_1_C0_IOMUX_FUNC);
    DL_GPIO_enableOutput(GPIO_SMotor_1_C0_PORT, GPIO_SMotor_1_C0_PIN);
    DL_GPIO_initPeripheralOutputFunction(GPIO_SMotor_2_C1_IOMUX,GPIO_SMotor_2_C1_IOMUX_FUNC);
    DL_GPIO_enableOutput(GPIO_SMotor_2_C1_PORT, GPIO_SMotor_2_C1_PIN);

    DL_GPIO_initPeripheralInputFunctionFeatures(GPIO_OLED_IOMUX_SDA,
        GPIO_OLED_IOMUX_SDA_FUNC, DL_GPIO_INVERSION_DISABLE,
        DL_GPIO_RESISTOR_NONE, DL_GPIO_HYSTERESIS_DISABLE,
        DL_GPIO_WAKEUP_DISABLE);
    DL_GPIO_initPeripheralInputFunctionFeatures(GPIO_OLED_IOMUX_SCL,
        GPIO_OLED_IOMUX_SCL_FUNC, DL_GPIO_INVERSION_DISABLE,
        DL_GPIO_RESISTOR_NONE, DL_GPIO_HYSTERESIS_DISABLE,
        DL_GPIO_WAKEUP_DISABLE);
    DL_GPIO_enableHiZ(GPIO_OLED_IOMUX_SDA);
    DL_GPIO_enableHiZ(GPIO_OLED_IOMUX_SCL);

    DL_GPIO_initPeripheralInputFunctionFeatures(GPIO_Gray_JY61P_I2C_IOMUX_SDA,
        GPIO_Gray_JY61P_I2C_IOMUX_SDA_FUNC, DL_GPIO_INVERSION_DISABLE,
        DL_GPIO_RESISTOR_PULL_UP, DL_GPIO_HYSTERESIS_DISABLE,
        DL_GPIO_WAKEUP_DISABLE);
    DL_GPIO_initPeripheralInputFunctionFeatures(GPIO_Gray_JY61P_I2C_IOMUX_SCL,
        GPIO_Gray_JY61P_I2C_IOMUX_SCL_FUNC, DL_GPIO_INVERSION_DISABLE,
        DL_GPIO_RESISTOR_PULL_UP, DL_GPIO_HYSTERESIS_DISABLE,
        DL_GPIO_WAKEUP_DISABLE);
    DL_GPIO_enableHiZ(GPIO_Gray_JY61P_I2C_IOMUX_SDA);
    DL_GPIO_enableHiZ(GPIO_Gray_JY61P_I2C_IOMUX_SCL);

    DL_GPIO_initPeripheralOutputFunction(
        GPIO_Debug_IOMUX_TX, GPIO_Debug_IOMUX_TX_FUNC);
    DL_GPIO_initPeripheralInputFunction(
        GPIO_Debug_IOMUX_RX, GPIO_Debug_IOMUX_RX_FUNC);
    DL_GPIO_initPeripheralOutputFunction(
        GPIO_Wireless_IOMUX_TX, GPIO_Wireless_IOMUX_TX_FUNC);
    DL_GPIO_initPeripheralInputFunction(
        GPIO_Wireless_IOMUX_RX, GPIO_Wireless_IOMUX_RX_FUNC);
    DL_GPIO_initPeripheralOutputFunction(
        GPIO_K230_IOMUX_TX, GPIO_K230_IOMUX_TX_FUNC);
    DL_GPIO_initPeripheralInputFunction(
        GPIO_K230_IOMUX_RX, GPIO_K230_IOMUX_RX_FUNC);

    DL_GPIO_initDigitalInputFeatures(Key_PIN_1_IOMUX,
		 DL_GPIO_INVERSION_DISABLE, DL_GPIO_RESISTOR_PULL_UP,
		 DL_GPIO_HYSTERESIS_DISABLE, DL_GPIO_WAKEUP_DISABLE);

    /* 天猛星 DOWN 按键 (PB25) 上拉输入配置 */
    DL_GPIO_initDigitalInputFeatures(Key_PIN_DOWN_IOMUX,
		 DL_GPIO_INVERSION_DISABLE, DL_GPIO_RESISTOR_PULL_UP,
		 DL_GPIO_HYSTERESIS_DISABLE, DL_GPIO_WAKEUP_DISABLE);

    /* 板载蜂鸣器 (PB5) 推挽输出配置 */
    DL_GPIO_initDigitalOutputFeatures(Buzzer_IOMUX,
		 DL_GPIO_INVERSION_DISABLE, DL_GPIO_RESISTOR_PULL_DOWN,
		 DL_GPIO_DRIVE_STRENGTH_LOW, DL_GPIO_HIZ_DISABLE);
    DL_GPIO_clearPins(Buzzer_PORT, Buzzer_PIN);
    DL_GPIO_enableOutput(Buzzer_PORT, Buzzer_PIN);

    DL_GPIO_initDigitalOutputFeatures(SMotor_IO_DIR1_IOMUX,
		 DL_GPIO_INVERSION_DISABLE, DL_GPIO_RESISTOR_PULL_DOWN,
		 DL_GPIO_DRIVE_STRENGTH_LOW, DL_GPIO_HIZ_DISABLE);

    /* PB15 (PinCM32) is dedicated to UART2_TX (CN7 Pin 4 to MSP430) */
    /* PB16 (PinCM33) is dedicated to Traffic Light LED_R (H2 Pin 2) */

    DL_GPIO_initDigitalOutput(SMotor_IO_EN2_IOMUX);

    DL_GPIO_initDigitalOutputFeatures(Motor_IO_AIN1_IOMUX,
		 DL_GPIO_INVERSION_DISABLE, DL_GPIO_RESISTOR_PULL_DOWN,
		 DL_GPIO_DRIVE_STRENGTH_LOW, DL_GPIO_HIZ_DISABLE);

    DL_GPIO_initDigitalOutputFeatures(Motor_IO_AIN2_IOMUX,
		 DL_GPIO_INVERSION_DISABLE, DL_GPIO_RESISTOR_PULL_DOWN,
		 DL_GPIO_DRIVE_STRENGTH_LOW, DL_GPIO_HIZ_DISABLE);

    DL_GPIO_initDigitalOutputFeatures(Motor_IO_BIN1_IOMUX,
		 DL_GPIO_INVERSION_DISABLE, DL_GPIO_RESISTOR_PULL_DOWN,
		 DL_GPIO_DRIVE_STRENGTH_LOW, DL_GPIO_HIZ_DISABLE);

    DL_GPIO_initDigitalOutputFeatures(Motor_IO_BIN2_IOMUX,
		 DL_GPIO_INVERSION_DISABLE, DL_GPIO_RESISTOR_PULL_DOWN,
		 DL_GPIO_DRIVE_STRENGTH_LOW, DL_GPIO_HIZ_DISABLE);

    DL_GPIO_initDigitalInputFeatures(Motor_IO_E1A_IOMUX,
		 DL_GPIO_INVERSION_DISABLE, DL_GPIO_RESISTOR_PULL_UP,
		 DL_GPIO_HYSTERESIS_DISABLE, DL_GPIO_WAKEUP_DISABLE);

    DL_GPIO_initDigitalInputFeatures(Motor_IO_E1B_IOMUX,
		 DL_GPIO_INVERSION_DISABLE, DL_GPIO_RESISTOR_PULL_UP,
		 DL_GPIO_HYSTERESIS_DISABLE, DL_GPIO_WAKEUP_DISABLE);

    DL_GPIO_initDigitalInputFeatures(Tracking_Tracking_1_IOMUX,
		 DL_GPIO_INVERSION_DISABLE, DL_GPIO_RESISTOR_PULL_DOWN,
		 DL_GPIO_HYSTERESIS_DISABLE, DL_GPIO_WAKEUP_DISABLE);

    DL_GPIO_initDigitalInputFeatures(Tracking_Tracking_2_IOMUX,
		 DL_GPIO_INVERSION_DISABLE, DL_GPIO_RESISTOR_PULL_DOWN,
		 DL_GPIO_HYSTERESIS_DISABLE, DL_GPIO_WAKEUP_DISABLE);

    DL_GPIO_initDigitalInputFeatures(Tracking_Tracking_3_IOMUX,
		 DL_GPIO_INVERSION_DISABLE, DL_GPIO_RESISTOR_PULL_DOWN,
		 DL_GPIO_HYSTERESIS_DISABLE, DL_GPIO_WAKEUP_DISABLE);

    DL_GPIO_initDigitalInputFeatures(Tracking_Tracking_4_IOMUX,
		 DL_GPIO_INVERSION_DISABLE, DL_GPIO_RESISTOR_PULL_DOWN,
		 DL_GPIO_HYSTERESIS_DISABLE, DL_GPIO_WAKEUP_DISABLE);

    DL_GPIO_initDigitalInputFeatures(Tracking_Tracking_5_IOMUX,
		 DL_GPIO_INVERSION_DISABLE, DL_GPIO_RESISTOR_PULL_DOWN,
		 DL_GPIO_HYSTERESIS_DISABLE, DL_GPIO_WAKEUP_DISABLE);

    DL_GPIO_initDigitalInputFeatures(Tracking_Tracking_6_IOMUX,
		 DL_GPIO_INVERSION_DISABLE, DL_GPIO_RESISTOR_PULL_DOWN,
		 DL_GPIO_HYSTERESIS_DISABLE, DL_GPIO_WAKEUP_DISABLE);

    DL_GPIO_initDigitalInputFeatures(Tracking_Tracking_7_IOMUX,
		 DL_GPIO_INVERSION_DISABLE, DL_GPIO_RESISTOR_PULL_DOWN,
		 DL_GPIO_HYSTERESIS_DISABLE, DL_GPIO_WAKEUP_DISABLE);

    DL_GPIO_initDigitalInputFeatures(Tracking_Tracking_8_IOMUX,
		 DL_GPIO_INVERSION_DISABLE, DL_GPIO_RESISTOR_PULL_DOWN,
		 DL_GPIO_HYSTERESIS_DISABLE, DL_GPIO_WAKEUP_DISABLE);

    DL_GPIO_initDigitalOutput(Key_PIN_2_IOMUX);

    DL_GPIO_clearPins(GPIOA, Motor_IO_AIN1_PIN);
    DL_GPIO_enableOutput(GPIOA, Motor_IO_AIN1_PIN);
    DL_GPIO_setLowerPinsPolarity(GPIOA, DL_GPIO_PIN_2_EDGE_RISE);
    DL_GPIO_setUpperPinsPolarity(GPIOA, DL_GPIO_PIN_28_EDGE_RISE);
    DL_GPIO_setLowerPinsInputFilter(GPIOA, DL_GPIO_PIN_2_INPUT_FILTER_3_CYCLES);
    DL_GPIO_setUpperPinsInputFilter(GPIOA, DL_GPIO_PIN_28_INPUT_FILTER_3_CYCLES);
    DL_GPIO_clearInterruptStatus(GPIOA, Motor_IO_E1A_PIN |
		Motor_IO_E1B_PIN);
    DL_GPIO_enableInterrupt(GPIOA, Motor_IO_E1A_PIN |
		Motor_IO_E1B_PIN);
    DL_GPIO_clearPins(GPIOB, SMotor_IO_DIR1_PIN |
		SMotor_IO_EN2_PIN |
		Motor_IO_AIN2_PIN |
		Motor_IO_BIN1_PIN |
		Motor_IO_BIN2_PIN |
		Key_PIN_2_PIN);
    DL_GPIO_enableOutput(GPIOB, SMotor_IO_DIR1_PIN |
		SMotor_IO_EN2_PIN |
		Motor_IO_AIN2_PIN |
		Motor_IO_BIN1_PIN |
		Motor_IO_BIN2_PIN |
		Key_PIN_2_PIN);

}


SYSCONFIG_WEAK void SYSCFG_DL_SYSCTL_init(void)
{

	//Low Power Mode is configured to be SLEEP0
    DL_SYSCTL_setBORThreshold(DL_SYSCTL_BOR_THRESHOLD_LEVEL_0);

    DL_SYSCTL_setSYSOSCFreq(DL_SYSCTL_SYSOSC_FREQ_BASE);
    /* Set default configuration */
    DL_SYSCTL_disableHFXT();
    DL_SYSCTL_disableSYSPLL();
    DL_SYSCTL_setULPCLKDivider(DL_SYSCTL_ULPCLK_DIV_1);
    DL_SYSCTL_setMCLKDivider(DL_SYSCTL_MCLK_DIVIDER_DISABLE);
    /* INT_GROUP1 Priority */
    NVIC_SetPriority(GPIOA_INT_IRQn, 0);

}


/*
 * Timer clock configuration to be sourced by  / 8 (4000000 Hz)
 * timerClkFreq = (timerClkSrc / (timerClkDivRatio * (timerClkPrescale + 1)))
 *   4000000 Hz = 4000000 Hz / (8 * (0 + 1))
 */
static const DL_TimerG_ClockConfig gMotorClockConfig = {
    .clockSel = DL_TIMER_CLOCK_BUSCLK,
    .divideRatio = DL_TIMER_CLOCK_DIVIDE_8,
    .prescale = 0U
};

static const DL_TimerG_PWMConfig gMotorConfig = {
    .pwmMode = DL_TIMER_PWM_MODE_EDGE_ALIGN_UP,
    .period = 1000,
    .isTimerWithFourCC = false,
    .startTimer = DL_TIMER_START,
};

SYSCONFIG_WEAK void SYSCFG_DL_Motor_init(void) {

    DL_TimerG_setClockConfig(
        Motor_INST, (DL_TimerG_ClockConfig *) &gMotorClockConfig);

    DL_TimerG_initPWMMode(
        Motor_INST, (DL_TimerG_PWMConfig *) &gMotorConfig);

    // Set Counter control to the smallest CC index being used
    DL_TimerG_setCounterControl(Motor_INST,DL_TIMER_CZC_CCCTL0_ZCOND,DL_TIMER_CAC_CCCTL0_ACOND,DL_TIMER_CLC_CCCTL0_LCOND);

    DL_TimerG_setCaptureCompareOutCtl(Motor_INST, DL_TIMER_CC_OCTL_INIT_VAL_LOW,
		DL_TIMER_CC_OCTL_INV_OUT_DISABLED, DL_TIMER_CC_OCTL_SRC_FUNCVAL,
		DL_TIMERG_CAPTURE_COMPARE_0_INDEX);

    DL_TimerG_setCaptCompUpdateMethod(Motor_INST, DL_TIMER_CC_UPDATE_METHOD_IMMEDIATE, DL_TIMERG_CAPTURE_COMPARE_0_INDEX);
    DL_TimerG_setCaptureCompareValue(Motor_INST, 500, DL_TIMER_CC_0_INDEX);

    DL_TimerG_setCaptureCompareOutCtl(Motor_INST, DL_TIMER_CC_OCTL_INIT_VAL_LOW,
		DL_TIMER_CC_OCTL_INV_OUT_DISABLED, DL_TIMER_CC_OCTL_SRC_FUNCVAL,
		DL_TIMERG_CAPTURE_COMPARE_1_INDEX);

    DL_TimerG_setCaptCompUpdateMethod(Motor_INST, DL_TIMER_CC_UPDATE_METHOD_IMMEDIATE, DL_TIMERG_CAPTURE_COMPARE_1_INDEX);
    DL_TimerG_setCaptureCompareValue(Motor_INST, 500, DL_TIMER_CC_1_INDEX);

    DL_TimerG_enableClock(Motor_INST);


    
    DL_TimerG_setCCPDirection(Motor_INST , DL_TIMER_CC0_OUTPUT | DL_TIMER_CC1_OUTPUT );


}

/*
 * A 通道 PWM：PB10 = TIMG0_CCP0。
 * PB10 没有 TIMG7 复用（只有 TIMG0/TIMG6/TIMG8），而 TIMG6/TIMG8 已被
 * 两路步进电机占用，所以这里单独开 TIMG0。
 * 时钟与 Motor_INST 完全一致：BUSCLK / 8 = 4MHz，period 1000 -> 4kHz，
 * 保证左右轮 PWM 频率相同，不会出现一侧啸叫、一侧不转。
 */
static const DL_TimerG_ClockConfig gMotorAClockConfig = {
    .clockSel = DL_TIMER_CLOCK_BUSCLK,
    .divideRatio = DL_TIMER_CLOCK_DIVIDE_8,
    .prescale = 0U
};

static const DL_TimerG_PWMConfig gMotorAConfig = {
    .pwmMode = DL_TIMER_PWM_MODE_EDGE_ALIGN_UP,
    .period = 1000,
    .isTimerWithFourCC = false,
    .startTimer = DL_TIMER_START,
};

SYSCONFIG_WEAK void SYSCFG_DL_MotorA_init(void) {

    DL_TimerG_setClockConfig(
        MotorA_INST, (DL_TimerG_ClockConfig *) &gMotorAClockConfig);

    DL_TimerG_initPWMMode(
        MotorA_INST, (DL_TimerG_PWMConfig *) &gMotorAConfig);

    DL_TimerG_setCounterControl(MotorA_INST, DL_TIMER_CZC_CCCTL0_ZCOND,
        DL_TIMER_CAC_CCCTL0_ACOND, DL_TIMER_CLC_CCCTL0_LCOND);

    DL_TimerG_setCaptureCompareOutCtl(MotorA_INST, DL_TIMER_CC_OCTL_INIT_VAL_LOW,
        DL_TIMER_CC_OCTL_INV_OUT_DISABLED, DL_TIMER_CC_OCTL_SRC_FUNCVAL,
        DL_TIMERG_CAPTURE_COMPARE_0_INDEX);

    DL_TimerG_setCaptCompUpdateMethod(MotorA_INST,
        DL_TIMER_CC_UPDATE_METHOD_IMMEDIATE, DL_TIMERG_CAPTURE_COMPARE_0_INDEX);
    DL_TimerG_setCaptureCompareValue(MotorA_INST, 0, DL_TIMER_CC_0_INDEX);

    DL_TimerG_enableClock(MotorA_INST);
    DL_TimerG_setCCPDirection(MotorA_INST, DL_TIMER_CC0_OUTPUT);
}
/*
 * Timer clock configuration to be sourced by  / 8 (4000000 Hz)
 * timerClkFreq = (timerClkSrc / (timerClkDivRatio * (timerClkPrescale + 1)))
 *   62500 Hz = 4000000 Hz / (8 * (63 + 1))
 */
static const DL_TimerG_ClockConfig gSMotor_1ClockConfig = {
    .clockSel = DL_TIMER_CLOCK_BUSCLK,
    .divideRatio = DL_TIMER_CLOCK_DIVIDE_8,
    .prescale = 63U
};

static const DL_TimerG_PWMConfig gSMotor_1Config = {
    .pwmMode = DL_TIMER_PWM_MODE_EDGE_ALIGN_UP,
    .period = 1000,
    .isTimerWithFourCC = false,
    .startTimer = DL_TIMER_START,
};

SYSCONFIG_WEAK void SYSCFG_DL_SMotor_1_init(void) {

    DL_TimerG_setClockConfig(
        SMotor_1_INST, (DL_TimerG_ClockConfig *) &gSMotor_1ClockConfig);

    DL_TimerG_initPWMMode(
        SMotor_1_INST, (DL_TimerG_PWMConfig *) &gSMotor_1Config);

    // Set Counter control to the smallest CC index being used
    DL_TimerG_setCounterControl(SMotor_1_INST,DL_TIMER_CZC_CCCTL0_ZCOND,DL_TIMER_CAC_CCCTL0_ACOND,DL_TIMER_CLC_CCCTL0_LCOND);

    DL_TimerG_setCaptureCompareOutCtl(SMotor_1_INST, DL_TIMER_CC_OCTL_INIT_VAL_LOW,
		DL_TIMER_CC_OCTL_INV_OUT_DISABLED, DL_TIMER_CC_OCTL_SRC_FUNCVAL,
		DL_TIMERG_CAPTURE_COMPARE_0_INDEX);

    DL_TimerG_setCaptCompUpdateMethod(SMotor_1_INST, DL_TIMER_CC_UPDATE_METHOD_IMMEDIATE, DL_TIMERG_CAPTURE_COMPARE_0_INDEX);
    DL_TimerG_setCaptureCompareValue(SMotor_1_INST, 0, DL_TIMER_CC_0_INDEX);

    DL_TimerG_enableClock(SMotor_1_INST);


    
    DL_TimerG_setCCPDirection(SMotor_1_INST , DL_TIMER_CC0_OUTPUT );


}
/*
 * Timer clock configuration to be sourced by  / 8 (4000000 Hz)
 * timerClkFreq = (timerClkSrc / (timerClkDivRatio * (timerClkPrescale + 1)))
 *   62500 Hz = 4000000 Hz / (8 * (63 + 1))
 */
static const DL_TimerG_ClockConfig gSMotor_2ClockConfig = {
    .clockSel = DL_TIMER_CLOCK_BUSCLK,
    .divideRatio = DL_TIMER_CLOCK_DIVIDE_8,
    .prescale = 63U
};

static const DL_TimerG_PWMConfig gSMotor_2Config = {
    .pwmMode = DL_TIMER_PWM_MODE_EDGE_ALIGN_UP,
    .period = 1000,
    .isTimerWithFourCC = false,
    .startTimer = DL_TIMER_START,
};

SYSCONFIG_WEAK void SYSCFG_DL_SMotor_2_init(void) {

    DL_TimerG_setClockConfig(
        SMotor_2_INST, (DL_TimerG_ClockConfig *) &gSMotor_2ClockConfig);

    DL_TimerG_initPWMMode(
        SMotor_2_INST, (DL_TimerG_PWMConfig *) &gSMotor_2Config);

    // Set Counter control to the smallest CC index being used
    DL_TimerG_setCounterControl(SMotor_2_INST,DL_TIMER_CZC_CCCTL1_ZCOND,DL_TIMER_CAC_CCCTL1_ACOND,DL_TIMER_CLC_CCCTL1_LCOND);

    DL_TimerG_setCaptureCompareOutCtl(SMotor_2_INST, DL_TIMER_CC_OCTL_INIT_VAL_LOW,
		DL_TIMER_CC_OCTL_INV_OUT_DISABLED, DL_TIMER_CC_OCTL_SRC_FUNCVAL,
		DL_TIMERG_CAPTURE_COMPARE_1_INDEX);

    DL_TimerG_setCaptCompUpdateMethod(SMotor_2_INST, DL_TIMER_CC_UPDATE_METHOD_IMMEDIATE, DL_TIMERG_CAPTURE_COMPARE_1_INDEX);
    DL_TimerG_setCaptureCompareValue(SMotor_2_INST, 0, DL_TIMER_CC_1_INDEX);

    DL_TimerG_enableClock(SMotor_2_INST);


    
    DL_TimerG_setCCPDirection(SMotor_2_INST , DL_TIMER_CC1_OUTPUT );


}



/*
 * Timer clock configuration to be sourced by BUSCLK /  (4000000 Hz)
 * timerClkFreq = (timerClkSrc / (timerClkDivRatio * (timerClkPrescale + 1)))
 *   40000 Hz = 4000000 Hz / (8 * (99 + 1))
 */
static const DL_TimerA_ClockConfig gTIMER_0ClockConfig = {
    .clockSel    = DL_TIMER_CLOCK_BUSCLK,
    .divideRatio = DL_TIMER_CLOCK_DIVIDE_8,
    .prescale    = 99U,
};

/*
 * Timer load value (where the counter starts from) is calculated as (timerPeriod * timerClockFreq) - 1
 * TIMER_0_INST_LOAD_VALUE = (100ms * 40000 Hz) - 1
 */
static const DL_TimerA_TimerConfig gTIMER_0TimerConfig = {
    .period     = TIMER_0_INST_LOAD_VALUE,
    .timerMode  = DL_TIMER_TIMER_MODE_PERIODIC,
    .startTimer = DL_TIMER_START,
};

SYSCONFIG_WEAK void SYSCFG_DL_TIMER_0_init(void) {

    DL_TimerA_setClockConfig(TIMER_0_INST,
        (DL_TimerA_ClockConfig *) &gTIMER_0ClockConfig);

    DL_TimerA_initTimerMode(TIMER_0_INST,
        (DL_TimerA_TimerConfig *) &gTIMER_0TimerConfig);
    DL_TimerA_enableInterrupt(TIMER_0_INST , DL_TIMERA_INTERRUPT_ZERO_EVENT);
	NVIC_SetPriority(TIMER_0_INST_INT_IRQN, 3);
    DL_TimerA_enableClock(TIMER_0_INST);





}


static const DL_I2C_ClockConfig gOLEDClockConfig = {
    .clockSel = DL_I2C_CLOCK_BUSCLK,
    .divideRatio = DL_I2C_CLOCK_DIVIDE_1,
};

static const DL_I2C_ClockConfig gGray_JY61P_I2CClockConfig = {
    .clockSel = DL_I2C_CLOCK_BUSCLK,
    .divideRatio = DL_I2C_CLOCK_DIVIDE_1,
};

SYSCONFIG_WEAK void SYSCFG_DL_Gray_JY61P_I2C_init(void) {
    DL_I2C_setClockConfig(Gray_JY61P_I2C_INST,
        (DL_I2C_ClockConfig *) &gGray_JY61P_I2CClockConfig);
    DL_I2C_setAnalogGlitchFilterPulseWidth(Gray_JY61P_I2C_INST,
        DL_I2C_ANALOG_GLITCH_FILTER_WIDTH_50NS);
    DL_I2C_enableAnalogGlitchFilter(Gray_JY61P_I2C_INST);

    /* Configure Controller Mode */
    DL_I2C_resetControllerTransfer(Gray_JY61P_I2C_INST);
    /* 100kHz (Standard)，32MHz/((TPR+1)*10)；JY61P 在 400kHz 下容易位错误并拉死 SDA。
     * wit_sdk.c 的 JY61P_I2C_Init() 里还会再强制写一次，防止 SysConfig 重新生成时被改回。 */
    DL_I2C_setTimerPeriod(Gray_JY61P_I2C_INST, 31);
    DL_I2C_setControllerTXFIFOThreshold(Gray_JY61P_I2C_INST, DL_I2C_TX_FIFO_LEVEL_EMPTY);
    DL_I2C_setControllerRXFIFOThreshold(Gray_JY61P_I2C_INST, DL_I2C_RX_FIFO_LEVEL_BYTES_1);
    DL_I2C_enableControllerClockStretching(Gray_JY61P_I2C_INST);

    /* Configure Interrupts */
    DL_I2C_enableInterrupt(Gray_JY61P_I2C_INST,
                           DL_I2C_INTERRUPT_CONTROLLER_ARBITRATION_LOST |
                           DL_I2C_INTERRUPT_CONTROLLER_NACK |
                           DL_I2C_INTERRUPT_CONTROLLER_RXFIFO_TRIGGER |
                           DL_I2C_INTERRUPT_CONTROLLER_RX_DONE |
                           DL_I2C_INTERRUPT_CONTROLLER_TX_DONE);

    /* Enable module */
    DL_I2C_enableController(Gray_JY61P_I2C_INST);
}

SYSCONFIG_WEAK void SYSCFG_DL_OLED_init(void) {

    DL_I2C_setClockConfig(OLED_INST,
        (DL_I2C_ClockConfig *) &gOLEDClockConfig);
    DL_I2C_setAnalogGlitchFilterPulseWidth(OLED_INST,
        DL_I2C_ANALOG_GLITCH_FILTER_WIDTH_50NS);
    DL_I2C_enableAnalogGlitchFilter(OLED_INST);

    /* Configure Controller Mode */
    DL_I2C_resetControllerTransfer(OLED_INST);
    /* Set frequency to 400000 Hz*/
    DL_I2C_setTimerPeriod(OLED_INST, 7);
    DL_I2C_setControllerTXFIFOThreshold(OLED_INST, DL_I2C_TX_FIFO_LEVEL_EMPTY);
    DL_I2C_setControllerRXFIFOThreshold(OLED_INST, DL_I2C_RX_FIFO_LEVEL_BYTES_1);
    DL_I2C_enableControllerClockStretching(OLED_INST);


    /* Enable module */
    DL_I2C_enableController(OLED_INST);


}

static const DL_UART_Main_ClockConfig gDebugClockConfig = {
    .clockSel    = DL_UART_MAIN_CLOCK_BUSCLK,
    .divideRatio = DL_UART_MAIN_CLOCK_DIVIDE_RATIO_1
};

static const DL_UART_Main_Config gDebugConfig = {
    .mode        = DL_UART_MAIN_MODE_NORMAL,
    .direction   = DL_UART_MAIN_DIRECTION_TX_RX,
    .flowControl = DL_UART_MAIN_FLOW_CONTROL_NONE,
    .parity      = DL_UART_MAIN_PARITY_NONE,
    .wordLength  = DL_UART_MAIN_WORD_LENGTH_8_BITS,
    .stopBits    = DL_UART_MAIN_STOP_BITS_ONE
};

SYSCONFIG_WEAK void SYSCFG_DL_Debug_init(void)
{
    DL_UART_Main_setClockConfig(Debug_INST, (DL_UART_Main_ClockConfig *) &gDebugClockConfig);

    DL_UART_Main_init(Debug_INST, (DL_UART_Main_Config *) &gDebugConfig);
    /*
     * Configure baud rate by setting oversampling and baud rate divisors.
     *  Target baud rate: 115200
     *  Actual baud rate: 115211.52
     */
    DL_UART_Main_setOversampling(Debug_INST, DL_UART_OVERSAMPLING_RATE_16X);
    DL_UART_Main_setBaudRateDivisor(Debug_INST, Debug_IBRD_32_MHZ_115200_BAUD, Debug_FBRD_32_MHZ_115200_BAUD);



    DL_UART_Main_enable(Debug_INST);
}

static const DL_UART_Main_ClockConfig gWirelessClockConfig = {
    .clockSel    = DL_UART_MAIN_CLOCK_BUSCLK,
    .divideRatio = DL_UART_MAIN_CLOCK_DIVIDE_RATIO_1
};

static const DL_UART_Main_Config gWirelessConfig = {
    .mode        = DL_UART_MAIN_MODE_NORMAL,
    .direction   = DL_UART_MAIN_DIRECTION_TX_RX,
    .flowControl = DL_UART_MAIN_FLOW_CONTROL_NONE,
    .parity      = DL_UART_MAIN_PARITY_NONE,
    .wordLength  = DL_UART_MAIN_WORD_LENGTH_8_BITS,
    .stopBits    = DL_UART_MAIN_STOP_BITS_ONE
};

SYSCONFIG_WEAK void SYSCFG_DL_Wireless_init(void)
{
    DL_UART_Main_setClockConfig(Wireless_INST, (DL_UART_Main_ClockConfig *) &gWirelessClockConfig);

    DL_UART_Main_init(Wireless_INST, (DL_UART_Main_Config *) &gWirelessConfig);
    /*
     * Configure baud rate by setting oversampling and baud rate divisors.
     *  Target baud rate: 115200
     *  Actual baud rate: 115211.52
     */
    DL_UART_Main_setOversampling(Wireless_INST, DL_UART_OVERSAMPLING_RATE_16X);
    DL_UART_Main_setBaudRateDivisor(Wireless_INST, Wireless_IBRD_32_MHZ_115200_BAUD, Wireless_FBRD_32_MHZ_115200_BAUD);

    DL_UART_Main_enable(Wireless_INST);
}

static const DL_UART_Main_ClockConfig gK230ClockConfig = {
    .clockSel    = DL_UART_MAIN_CLOCK_BUSCLK,
    .divideRatio = DL_UART_MAIN_CLOCK_DIVIDE_RATIO_1
};

static const DL_UART_Main_Config gK230Config = {
    .mode        = DL_UART_MAIN_MODE_NORMAL,
    .direction   = DL_UART_MAIN_DIRECTION_TX_RX,
    .flowControl = DL_UART_MAIN_FLOW_CONTROL_NONE,
    .parity      = DL_UART_MAIN_PARITY_NONE,
    .wordLength  = DL_UART_MAIN_WORD_LENGTH_8_BITS,
    .stopBits    = DL_UART_MAIN_STOP_BITS_ONE
};

SYSCONFIG_WEAK void SYSCFG_DL_K230_init(void)
{
    DL_UART_Main_setClockConfig(K230_INST, (DL_UART_Main_ClockConfig *) &gK230ClockConfig);

    DL_UART_Main_init(K230_INST, (DL_UART_Main_Config *) &gK230Config);
    /*
     * Configure baud rate by setting oversampling and baud rate divisors.
     *  Target baud rate: 115200
     *  Actual baud rate: 115211.52
     */
    DL_UART_Main_setOversampling(K230_INST, DL_UART_OVERSAMPLING_RATE_16X);
    DL_UART_Main_setBaudRateDivisor(K230_INST, K230_IBRD_32_MHZ_115200_BAUD, K230_FBRD_32_MHZ_115200_BAUD);


    /* Configure Interrupts */
    DL_UART_Main_enableInterrupt(K230_INST,
                                 DL_UART_MAIN_INTERRUPT_RX |
                                 DL_UART_MAIN_INTERRUPT_TX);
    /* Setting the Interrupt Priority */
    NVIC_SetPriority(K230_INST_INT_IRQN, 0);


    DL_UART_Main_enable(K230_INST);
}

SYSCONFIG_WEAK void SYSCFG_DL_SYSTICK_init(void)
{
    /*
     * Initializes the SysTick period to 1.00 ms,
     * enables the interrupt, and starts the SysTick Timer
     */
    DL_SYSTICK_config(32000);
}
