VincentttWang/MSP430_WirelessCar/NUEDC_2026/[Demo] MSPM0_Car_v5/bsp/imu/wit_sdk.c

#include "wit_sdk.h"
#include <stdio.h>
#include <string.h>

#define GYROSCOPE_BUFFER_SIZE    33
#define JY61P_FRAME_SIZE         11
#define GYROSCOPE_CH_DATA_SIZE   10

static SerialWrite p_WitSerialWriteFunc = NULL;
static WitI2cWrite p_WitI2cWriteFunc = NULL;
static WitI2cRead p_WitI2cReadFunc = NULL;
static CanWrite p_WitCanWriteFunc = NULL;
static RegUpdateCb p_WitRegUpdateCbFunc = NULL;
static DelaymsCb p_WitDelaymsFunc = NULL;

static uint8_t s_ucAddr = 0xff;
static uint8_t s_ucWitDataBuff[WIT_DATA_BUFF_SIZE];
static uint32_t s_uiWitDataCnt = 0, s_uiProtoclo = 0, s_uiReadRegIndex = 0;
int16_t sReg[REGSIZE];

uint8_t GyroscopeUsart3RxBuffer[33];
double GyroscopeChannelData[10] = {0};
#define FuncW 0x06
#define FuncR 0x03

static int16_t JY61P_ReadI16(const uint8_t *buf, uint8_t low_index);
static uint8_t JY61P_FrameChecksum(const uint8_t *buf);
static void JY61P_DecodeFrame(const uint8_t *buf);

static int16_t JY61P_ReadI16(const uint8_t *buf, uint8_t low_index)
{
    return (int16_t)(((uint16_t)buf[(uint8_t)(low_index + 1U)] << 8) | buf[low_index]);
}

static uint8_t JY61P_FrameChecksum(const uint8_t *buf)
{
    uint16_t sum = 0U;

    for(uint8_t i = 0U; i < (JY61P_FRAME_SIZE - 1U); i++){
        sum += buf[i];
    }

    return (uint8_t)(sum & 0xFFU);
}

static void JY61P_DecodeFrame(const uint8_t *buf)
{
    if((buf == NULL) || (buf[0] != 0x55U) || (buf[10] != JY61P_FrameChecksum(buf))){
        return;
    }

    switch(buf[1]){
        case WIT_ACC:
            GyroscopeChannelData[0] = (double)JY61P_ReadI16(buf, 2U) / 32768.0 * 16.0;
            GyroscopeChannelData[1] = (double)JY61P_ReadI16(buf, 4U) / 32768.0 * 16.0;
            GyroscopeChannelData[2] = (double)JY61P_ReadI16(buf, 6U) / 32768.0 * 16.0;
            GyroscopeChannelData[9] = (double)JY61P_ReadI16(buf, 8U) / 100.0;
            break;
        case WIT_GYRO:
            GyroscopeChannelData[3] = (double)JY61P_ReadI16(buf, 2U) / 32768.0 * 2000.0;
            GyroscopeChannelData[4] = (double)JY61P_ReadI16(buf, 4U) / 32768.0 * 2000.0;
            GyroscopeChannelData[5] = (double)JY61P_ReadI16(buf, 6U) / 32768.0 * 2000.0;
            break;
        case WIT_ANGLE:
            GyroscopeChannelData[6] = (double)JY61P_ReadI16(buf, 2U) / 32768.0 * 180.0;
            GyroscopeChannelData[7] = (double)JY61P_ReadI16(buf, 4U) / 32768.0 * 180.0;
            /* 陀螺仪安装于底盘底部，翻转航向角正负方向 */
            GyroscopeChannelData[8] = -(double)JY61P_ReadI16(buf, 6U) / 32768.0 * 180.0;
            break;
        default:
            break;
    }
}

static const uint8_t __auchCRCHi[256] = {
    0x00, 0xC1, 0x81, 0x40, 0x01, 0xC0, 0x80, 0x41, 0x01, 0xC0, 0x80, 0x41, 0x00, 0xC1, 0x81,
    0x40, 0x01, 0xC0, 0x80, 0x41, 0x00, 0xC1, 0x81, 0x40, 0x00, 0xC1, 0x81, 0x40, 0x01, 0xC0,
    0x80, 0x41, 0x01, 0xC0, 0x80, 0x41, 0x00, 0xC1, 0x81, 0x40, 0x00, 0xC1, 0x81, 0x40, 0x01,
    0xC0, 0x80, 0x41, 0x00, 0xC1, 0x81, 0x40, 0x01, 0xC0, 0x80, 0x41, 0x01, 0xC0, 0x80, 0x41,
    0x00, 0xC1, 0x81, 0x40, 0x01, 0xC0, 0x80, 0x41, 0x00, 0xC1, 0x81, 0x40, 0x00, 0xC1, 0x81,
    0x40, 0x01, 0xC0, 0x80, 0x41, 0x00, 0xC1, 0x81, 0x40, 0x01, 0xC0, 0x80, 0x41, 0x01, 0xC0,
    0x80, 0x41, 0x00, 0xC1, 0x81, 0x40, 0x00, 0xC1, 0x81, 0x40, 0x01, 0xC0, 0x80, 0x41, 0x01,
    0xC0, 0x80, 0x41, 0x00, 0xC1, 0x81, 0x40, 0x01, 0xC0, 0x80, 0x41, 0x00, 0xC1, 0x81, 0x40,
    0x00, 0xC1, 0x81, 0x40, 0x01, 0xC0, 0x80, 0x41, 0x01, 0xC0, 0x80, 0x41, 0x00, 0xC1, 0x81,
    0x40, 0x00, 0xC1, 0x81, 0x40, 0x01, 0xC0, 0x80, 0x41, 0x00, 0xC1, 0x81, 0x40, 0x01, 0xC0,
    0x80, 0x41, 0x01, 0xC0, 0x80, 0x41, 0x00, 0xC1, 0x81, 0x40, 0x00, 0xC1, 0x81, 0x40, 0x01,
    0xC0, 0x80, 0x41, 0x01, 0xC0, 0x80, 0x41, 0x00, 0xC1, 0x81, 0x40, 0x01, 0xC0, 0x80, 0x41,
    0x00, 0xC1, 0x81, 0x40, 0x00, 0xC1, 0x81, 0x40, 0x01, 0xC0, 0x80, 0x41, 0x00, 0xC1, 0x81,
    0x40, 0x01, 0xC0, 0x80, 0x41, 0x01, 0xC0, 0x80, 0x41, 0x00, 0xC1, 0x81, 0x40, 0x01, 0xC0,
    0x80, 0x41, 0x00, 0xC1, 0x81, 0x40, 0x00, 0xC1, 0x81, 0x40, 0x01, 0xC0, 0x80, 0x41, 0x01,
    0xC0, 0x80, 0x41, 0x00, 0xC1, 0x81, 0x40, 0x00, 0xC1, 0x81, 0x40, 0x01, 0xC0, 0x80, 0x41,
    0x00, 0xC1, 0x81, 0x40, 0x01, 0xC0, 0x80, 0x41, 0x01, 0xC0, 0x80, 0x41, 0x00, 0xC1, 0x81,
    0x40
};
static const uint8_t __auchCRCLo[256] = {
    0x00, 0xC0, 0xC1, 0x01, 0xC3, 0x03, 0x02, 0xC2, 0xC6, 0x06, 0x07, 0xC7, 0x05, 0xC5, 0xC4,
    0x04, 0xCC, 0x0C, 0x0D, 0xCD, 0x0F, 0xCF, 0xCE, 0x0E, 0x0A, 0xCA, 0xCB, 0x0B, 0xC9, 0x09,
    0x08, 0xC8, 0xD8, 0x18, 0x19, 0xD9, 0x1B, 0xDB, 0xDA, 0x1A, 0x1E, 0xDE, 0xDF, 0x1F, 0xDD,
    0x1D, 0x1C, 0xDC, 0x14, 0xD4, 0xD5, 0x15, 0xD7, 0x17, 0x16, 0xD6, 0xD2, 0x12, 0x13, 0xD3,
    0x11, 0xD1, 0xD0, 0x10, 0xF0, 0x30, 0x31, 0xF1, 0x33, 0xF3, 0xF2, 0x32, 0x36, 0xF6, 0xF7,
    0x37, 0xF5, 0x35, 0x34, 0xF4, 0x3C, 0xFC, 0xFD, 0x3D, 0xFF, 0x3F, 0x3E, 0xFE, 0xFA, 0x3A,
    0x3B, 0xFB, 0x39, 0xF9, 0xF8, 0x38, 0x28, 0xE8, 0xE9, 0x29, 0xEB, 0x2B, 0x2A, 0xEA, 0xEE,
    0x2E, 0x2F, 0xEF, 0x2D, 0xED, 0xEC, 0x2C, 0xE4, 0x24, 0x25, 0xE5, 0x27, 0xE7, 0xE6, 0x26,
    0x22, 0xE2, 0xE3, 0x23, 0xE1, 0x21, 0x20, 0xE0, 0xA0, 0x60, 0x61, 0xA1, 0x63, 0xA3, 0xA2,
    0x62, 0x66, 0xA6, 0xA7, 0x67, 0xA5, 0x65, 0x64, 0xA4, 0x6C, 0xAC, 0xAD, 0x6D, 0xAF, 0x6F,
    0x6E, 0xAE, 0xAA, 0x6A, 0x6B, 0xAB, 0x69, 0xA9, 0xA8, 0x68, 0x78, 0xB8, 0xB9, 0x79, 0xBB,
    0x7B, 0x7A, 0xBA, 0xBE, 0x7E, 0x7F, 0xBF, 0x7D, 0xBD, 0xBC, 0x7C, 0xB4, 0x74, 0x75, 0xB5,
    0x77, 0xB7, 0xB6, 0x76, 0x72, 0xB2, 0xB3, 0x73, 0xB1, 0x71, 0x70, 0xB0, 0x50, 0x90, 0x91,
    0x51, 0x93, 0x53, 0x52, 0x92, 0x96, 0x56, 0x57, 0x97, 0x55, 0x95, 0x94, 0x54, 0x9C, 0x5C,
    0x5D, 0x9D, 0x5F, 0x9F, 0x9E, 0x5E, 0x5A, 0x9A, 0x9B, 0x5B, 0x99, 0x59, 0x58, 0x98, 0x88,
    0x48, 0x49, 0x89, 0x4B, 0x8B, 0x8A, 0x4A, 0x4E, 0x8E, 0x8F, 0x4F, 0x8D, 0x4D, 0x4C, 0x8C,
    0x44, 0x84, 0x85, 0x45, 0x87, 0x47, 0x46, 0x86, 0x82, 0x42, 0x43, 0x83, 0x41, 0x81, 0x80,
    0x40
};


static uint16_t __CRC16(uint8_t *puchMsg, uint16_t usDataLen)
{
    uint8_t uchCRCHi = 0xFF;
    uint8_t uchCRCLo = 0xFF;
    uint8_t uIndex;
    int i = 0;
    uchCRCHi = 0xFF;
    uchCRCLo = 0xFF;
    for (; i<usDataLen; i++)
    {
        uIndex = uchCRCHi ^ puchMsg[i];
        uchCRCHi = uchCRCLo ^ __auchCRCHi[uIndex];
        uchCRCLo = __auchCRCLo[uIndex] ;
    }
    return (uint16_t)(((uint16_t)uchCRCHi << 8) | (uint16_t)uchCRCLo) ;
}
static uint8_t __CaliSum(uint8_t *data, uint32_t len)
{
    uint32_t i;
    uint8_t ucCheck = 0;
    for(i=0; i<len; i++) ucCheck += *(data + i);
    return ucCheck;
}
int32_t WitSerialWriteRegister(SerialWrite Write_func)
{
    if(!Write_func)return WIT_HAL_INVAL;
    p_WitSerialWriteFunc = Write_func;
    return WIT_HAL_OK;
}
static void CopeWitData(uint8_t ucIndex, uint16_t *p_data, uint32_t uiLen)
{
    uint32_t uiReg1 = 0, uiReg2 = 0, uiReg1Len = 0, uiReg2Len = 0;
    uint16_t *p_usReg1Val = p_data;
    uint16_t *p_usReg2Val = p_data+3;
    
    uiReg1Len = 4;
    switch(ucIndex)
    {
        case WIT_ACC:   uiReg1 = AX;    uiReg1Len = 3;  uiReg2 = TEMP;  uiReg2Len = 1;  break;
        case WIT_ANGLE: uiReg1 = Roll;  uiReg1Len = 3;  uiReg2 = VERSION;  uiReg2Len = 1;  break;
        case WIT_TIME:  uiReg1 = YYMM;	break;
        case WIT_GYRO:  uiReg1 = GX;  uiLen = 3;break;
        case WIT_MAGNETIC: uiReg1 = HX;  uiLen = 3;break;
        case WIT_DPORT: uiReg1 = D0Status;  break;
        case WIT_PRESS: uiReg1 = PressureL;  break;
        case WIT_GPS:   uiReg1 = LonL;  break;
        case WIT_VELOCITY: uiReg1 = GPSHeight;  break;
        case WIT_QUATER:    uiReg1 = q0;  break;
        case WIT_GSA:   uiReg1 = SVNUM;  break;
        case WIT_REGVALUE:  uiReg1 = s_uiReadRegIndex;  break;
		default:
			return ;

    }
    if(uiLen == 3)
    {
        uiReg1Len = 3;
        uiReg2Len = 0;
    }
    if(uiReg1Len)
	{
		memcpy(&sReg[uiReg1], p_usReg1Val, uiReg1Len<<1);
		p_WitRegUpdateCbFunc(uiReg1, uiReg1Len);
	}
    if(uiReg2Len)
	{
		memcpy(&sReg[uiReg2], p_usReg2Val, uiReg2Len<<1);
		p_WitRegUpdateCbFunc(uiReg2, uiReg2Len);
	}
}

void WitSerialDataIn(uint8_t ucData)
{
    uint16_t usCRC16, usTemp, i, usData[4];
    uint8_t ucSum;

    if(p_WitRegUpdateCbFunc == NULL)return ;
    s_ucWitDataBuff[s_uiWitDataCnt++] = ucData;
    switch(s_uiProtoclo)
    {
        case WIT_PROTOCOL_NORMAL:
            if(s_ucWitDataBuff[0] != 0x55)
            {
                s_uiWitDataCnt--;
                memcpy(s_ucWitDataBuff, &s_ucWitDataBuff[1], s_uiWitDataCnt);
                return ;
            }
            if(s_uiWitDataCnt >= 11)
            {
                ucSum = __CaliSum(s_ucWitDataBuff, 10);
                if(ucSum != s_ucWitDataBuff[10])
                {
                    s_uiWitDataCnt--;
                    memcpy(s_ucWitDataBuff, &s_ucWitDataBuff[1], s_uiWitDataCnt);
                    return ;
                }
                usData[0] = ((uint16_t)s_ucWitDataBuff[3] << 8) | (uint16_t)s_ucWitDataBuff[2];
                usData[1] = ((uint16_t)s_ucWitDataBuff[5] << 8) | (uint16_t)s_ucWitDataBuff[4];
                usData[2] = ((uint16_t)s_ucWitDataBuff[7] << 8) | (uint16_t)s_ucWitDataBuff[6];
                usData[3] = ((uint16_t)s_ucWitDataBuff[9] << 8) | (uint16_t)s_ucWitDataBuff[8];
                CopeWitData(s_ucWitDataBuff[1], usData, 4);
                s_uiWitDataCnt = 0;
            }
        break;
        case WIT_PROTOCOL_MODBUS:
            if(s_uiWitDataCnt > 2)
            {
                if(s_ucWitDataBuff[1] != FuncR)
                {
                    s_uiWitDataCnt--;
                    memcpy(s_ucWitDataBuff, &s_ucWitDataBuff[1], s_uiWitDataCnt);
                    return ;
                }
                if(s_uiWitDataCnt < (s_ucWitDataBuff[2] + 5))return ;
                usTemp = ((uint16_t)s_ucWitDataBuff[s_uiWitDataCnt-2] << 8) | s_ucWitDataBuff[s_uiWitDataCnt-1];
                usCRC16 = __CRC16(s_ucWitDataBuff, s_uiWitDataCnt-2);
                if(usTemp != usCRC16)
                {
                    s_uiWitDataCnt--;
                    memcpy(s_ucWitDataBuff, &s_ucWitDataBuff[1], s_uiWitDataCnt);
                    return ;
                }
                usTemp = s_ucWitDataBuff[2] >> 1;
                for(i = 0; i < usTemp; i++)
                {
                    sReg[i+s_uiReadRegIndex] = ((uint16_t)s_ucWitDataBuff[(i<<1)+3] << 8) | s_ucWitDataBuff[(i<<1)+4];
                }
                p_WitRegUpdateCbFunc(s_uiReadRegIndex, usTemp);
                s_uiWitDataCnt = 0;
            }
        break;
        case WIT_PROTOCOL_CAN:
        case WIT_PROTOCOL_I2C:
        s_uiWitDataCnt = 0;
        break;
    }
    if(s_uiWitDataCnt == WIT_DATA_BUFF_SIZE)s_uiWitDataCnt = 0;
}
int32_t WitI2cFuncRegister(WitI2cWrite write_func, WitI2cRead read_func)
{
    if(!write_func)return WIT_HAL_INVAL;
    if(!read_func)return WIT_HAL_INVAL;
    p_WitI2cWriteFunc = write_func;
    p_WitI2cReadFunc = read_func;
    return WIT_HAL_OK;
}
int32_t WitCanWriteRegister(CanWrite Write_func)
{
    if(!Write_func)return WIT_HAL_INVAL;
    p_WitCanWriteFunc = Write_func;
    return WIT_HAL_OK;
}
void WitCanDataIn(uint8_t ucData[8], uint8_t ucLen)
{
	uint16_t usData[3];
    if(p_WitRegUpdateCbFunc == NULL)return ;
    if(ucLen < 8)return ;
    switch(s_uiProtoclo)
    {
        case WIT_PROTOCOL_CAN:
            if(ucData[0] != 0x55)return ;
            usData[0] = ((uint16_t)ucData[3] << 8) | ucData[2];
            usData[1] = ((uint16_t)ucData[5] << 8) | ucData[4];
            usData[2] = ((uint16_t)ucData[7] << 8) | ucData[6];
            CopeWitData(ucData[1], usData, 3);
            break;
        case WIT_PROTOCOL_NORMAL:
        case WIT_PROTOCOL_MODBUS:
        case WIT_PROTOCOL_I2C:
            break;
    }
}
int32_t WitRegisterCallBack(RegUpdateCb update_func)
{
    if(!update_func)return WIT_HAL_INVAL;
    p_WitRegUpdateCbFunc = update_func;
    return WIT_HAL_OK;
}
int32_t WitWriteReg(uint32_t uiReg, uint16_t usData)
{
    uint16_t usCRC;
    uint8_t ucBuff[8];
    if(uiReg >= REGSIZE)return WIT_HAL_INVAL;
    switch(s_uiProtoclo)
    {
        case WIT_PROTOCOL_NORMAL:
            if(p_WitSerialWriteFunc == NULL)return WIT_HAL_EMPTY;
            ucBuff[0] = 0xFF;
            ucBuff[1] = 0xAA;
            ucBuff[2] = uiReg & 0xFF;
            ucBuff[3] = usData & 0xff;
            ucBuff[4] = usData >> 8;
            p_WitSerialWriteFunc(ucBuff, 5);
            break;
        case WIT_PROTOCOL_MODBUS:
            if(p_WitSerialWriteFunc == NULL)return WIT_HAL_EMPTY;
            ucBuff[0] = s_ucAddr;
            ucBuff[1] = FuncW;
            ucBuff[2] = uiReg >> 8;
            ucBuff[3] = uiReg & 0xFF;
            ucBuff[4] = usData >> 8;
            ucBuff[5] = usData & 0xff;
            usCRC = __CRC16(ucBuff, 6);
            ucBuff[6] = usCRC >> 8;
            ucBuff[7] = usCRC & 0xff;
            p_WitSerialWriteFunc(ucBuff, 8);
            break;
        case WIT_PROTOCOL_CAN:
            if(p_WitCanWriteFunc == NULL)return WIT_HAL_EMPTY;
            ucBuff[0] = 0xFF;
            ucBuff[1] = 0xAA;
            ucBuff[2] = uiReg & 0xFF;
            ucBuff[3] = usData & 0xff;
            ucBuff[4] = usData >> 8;
            p_WitCanWriteFunc(s_ucAddr, ucBuff, 5);
            break;
        case WIT_PROTOCOL_I2C:
            if(p_WitI2cWriteFunc == NULL)return WIT_HAL_EMPTY;
            ucBuff[0] = usData & 0xff;
            ucBuff[1] = usData >> 8;
			if(p_WitI2cWriteFunc(s_ucAddr << 1, uiReg, ucBuff, 2) != 1)
			{
				//printf("i2c write fail\r\n");
			}
        break;
	default: 
            return WIT_HAL_INVAL;        
    }
    return WIT_HAL_OK;
}
int32_t WitReadReg(uint32_t uiReg, uint32_t uiReadNum)
{
    uint16_t usTemp, i;
    uint8_t ucBuff[8];
    if((uiReg + uiReadNum) >= REGSIZE)return WIT_HAL_INVAL;
    switch(s_uiProtoclo)
    {
        case WIT_PROTOCOL_NORMAL:
            if(uiReadNum > 4)return WIT_HAL_INVAL;
            if(p_WitSerialWriteFunc == NULL)return WIT_HAL_EMPTY;
            ucBuff[0] = 0xFF;
            ucBuff[1] = 0xAA;
            ucBuff[2] = 0x27;
            ucBuff[3] = uiReg & 0xff;
            ucBuff[4] = uiReg >> 8;
            p_WitSerialWriteFunc(ucBuff, 5);
            break;
        case WIT_PROTOCOL_MODBUS:
            if(p_WitSerialWriteFunc == NULL)return WIT_HAL_EMPTY;
            usTemp = uiReadNum << 1;
            if((usTemp + 5) > WIT_DATA_BUFF_SIZE)return WIT_HAL_NOMEM;
            ucBuff[0] = s_ucAddr;
            ucBuff[1] = FuncR;
            ucBuff[2] = uiReg >> 8;
            ucBuff[3] = uiReg & 0xFF;
            ucBuff[4] = uiReadNum >> 8;
            ucBuff[5] = uiReadNum & 0xff;
            usTemp = __CRC16(ucBuff, 6);
            ucBuff[6] = usTemp >> 8;
            ucBuff[7] = usTemp & 0xff;
            p_WitSerialWriteFunc(ucBuff, 8);
            break;
        case WIT_PROTOCOL_CAN:
            if(uiReadNum > 3)return WIT_HAL_INVAL;
            if(p_WitCanWriteFunc == NULL)return WIT_HAL_EMPTY;
            ucBuff[0] = 0xFF;
            ucBuff[1] = 0xAA;
            ucBuff[2] = 0x27;
            ucBuff[3] = uiReg & 0xff;
            ucBuff[4] = uiReg >> 8;
            p_WitCanWriteFunc(s_ucAddr, ucBuff, 5);
            break;
        case WIT_PROTOCOL_I2C:
            if(p_WitI2cReadFunc == NULL)return WIT_HAL_EMPTY;
            usTemp = uiReadNum << 1;
            if(WIT_DATA_BUFF_SIZE < usTemp)return WIT_HAL_NOMEM;
            if(p_WitI2cReadFunc(s_ucAddr << 1, uiReg, s_ucWitDataBuff, usTemp) == 1)
            {
                if(p_WitRegUpdateCbFunc == NULL)return WIT_HAL_EMPTY;
                for(i = 0; i < uiReadNum; i++)
                {
                    sReg[i+uiReg] = ((uint16_t)s_ucWitDataBuff[(i<<1)+1] << 8) | s_ucWitDataBuff[i<<1];
                }
                p_WitRegUpdateCbFunc(uiReg, uiReadNum);
            }
			
            break;
		default: 
            return WIT_HAL_INVAL;
    }
    s_uiReadRegIndex = uiReg;

    return WIT_HAL_OK;
}
int32_t WitInit(uint32_t uiProtocol, uint8_t ucAddr)
{
	if(uiProtocol > WIT_PROTOCOL_I2C)return WIT_HAL_INVAL;
    s_uiProtoclo = uiProtocol;
    s_ucAddr = ucAddr;
    s_uiWitDataCnt = 0;
    return WIT_HAL_OK;
}
void WitDeInit(void)
{
    p_WitSerialWriteFunc = NULL;
    p_WitI2cWriteFunc = NULL;
    p_WitI2cReadFunc = NULL;
    p_WitCanWriteFunc = NULL;
    p_WitRegUpdateCbFunc = NULL;
    s_ucAddr = 0xff;
    s_uiWitDataCnt = 0;
    s_uiProtoclo = 0;
}

int32_t WitDelayMsRegister(DelaymsCb delayms_func)
{
    if(!delayms_func)return WIT_HAL_INVAL;
    p_WitDelaymsFunc = delayms_func;
    return WIT_HAL_OK;
}

char CheckRange(short sTemp,short sMin,short sMax)
{
    if ((sTemp>=sMin)&&(sTemp<=sMax)) return 1;
    else return 0;
}
/*Acceleration calibration demo*/
int32_t WitStartAccCali(void)
{
/*
	First place the equipment horizontally, and then perform the following operations
*/
	if(WitWriteReg(KEY, KEY_UNLOCK) != WIT_HAL_OK)	    return  WIT_HAL_ERROR;// unlock reg
	if(s_uiProtoclo == WIT_PROTOCOL_MODBUS)	p_WitDelaymsFunc(20);
	else if(s_uiProtoclo == WIT_PROTOCOL_NORMAL) p_WitDelaymsFunc(1);
	else ;
	if(WitWriteReg(CALSW, CALGYROACC) != WIT_HAL_OK)	return  WIT_HAL_ERROR;
	return WIT_HAL_OK;
}
int32_t WitStopAccCali(void)
{
	if(WitWriteReg(CALSW, NORMAL) != WIT_HAL_OK)	return  WIT_HAL_ERROR;
	if(s_uiProtoclo == WIT_PROTOCOL_MODBUS)	p_WitDelaymsFunc(20);
	else if(s_uiProtoclo == WIT_PROTOCOL_NORMAL) p_WitDelaymsFunc(1);
	else ;
	if(WitWriteReg(SAVE, SAVE_PARAM) != WIT_HAL_OK)	return  WIT_HAL_ERROR;
	return WIT_HAL_OK;
}
/*Magnetic field calibration*/
int32_t WitStartMagCali(void)
{
	if(WitWriteReg(KEY, KEY_UNLOCK) != WIT_HAL_OK)	return  WIT_HAL_ERROR;
	if(s_uiProtoclo == WIT_PROTOCOL_MODBUS)	p_WitDelaymsFunc(20);
	else if(s_uiProtoclo == WIT_PROTOCOL_NORMAL) p_WitDelaymsFunc(1);
	else ;
	if(WitWriteReg(CALSW, CALMAGMM) != WIT_HAL_OK)	return  WIT_HAL_ERROR;
	return WIT_HAL_OK;
}
int32_t WitStopMagCali(void)
{
	if(WitWriteReg(KEY, KEY_UNLOCK) != WIT_HAL_OK)	return  WIT_HAL_ERROR;
	if(s_uiProtoclo == WIT_PROTOCOL_MODBUS)	p_WitDelaymsFunc(20);
	else if(s_uiProtoclo == WIT_PROTOCOL_NORMAL) p_WitDelaymsFunc(1);
	else ;
	if(WitWriteReg(CALSW, NORMAL) != WIT_HAL_OK)	return  WIT_HAL_ERROR;
	return WIT_HAL_OK;
}
/*change Band*/
int32_t WitSetUartBaud(int32_t uiBaudIndex)
{
	if(!CheckRange(uiBaudIndex,WIT_BAUD_4800,WIT_BAUD_230400))
	{
		return WIT_HAL_INVAL;
	}
	if(WitWriteReg(KEY, KEY_UNLOCK) != WIT_HAL_OK)	return  WIT_HAL_ERROR;
	if(s_uiProtoclo == WIT_PROTOCOL_MODBUS)	p_WitDelaymsFunc(20);
	else if(s_uiProtoclo == WIT_PROTOCOL_NORMAL) p_WitDelaymsFunc(1);
	else ;
	if(WitWriteReg(BAUD, uiBaudIndex) != WIT_HAL_OK)	return  WIT_HAL_ERROR;
	return WIT_HAL_OK;
}
/*change Can Band*/
int32_t WitSetCanBaud(int32_t uiBaudIndex)
{
	if(!CheckRange(uiBaudIndex,CAN_BAUD_1000000,CAN_BAUD_3000))
	{
		return WIT_HAL_INVAL;
	}
	if(WitWriteReg(KEY, KEY_UNLOCK) != WIT_HAL_OK)	return  WIT_HAL_ERROR;
	if(s_uiProtoclo == WIT_PROTOCOL_MODBUS)	p_WitDelaymsFunc(20);
	else if(s_uiProtoclo == WIT_PROTOCOL_NORMAL) p_WitDelaymsFunc(1);
	else ;
	if(WitWriteReg(BAUD, uiBaudIndex) != WIT_HAL_OK)	return  WIT_HAL_ERROR;
	return WIT_HAL_OK;
}
/*change Bandwidth*/
int32_t WitSetBandwidth(int32_t uiBaudWidth)
{	
	if(!CheckRange(uiBaudWidth,BANDWIDTH_256HZ,BANDWIDTH_5HZ))
	{
		return WIT_HAL_INVAL;
	}
	if(WitWriteReg(KEY, KEY_UNLOCK) != WIT_HAL_OK)	return  WIT_HAL_ERROR;
	if(s_uiProtoclo == WIT_PROTOCOL_MODBUS)	p_WitDelaymsFunc(20);
	else if(s_uiProtoclo == WIT_PROTOCOL_NORMAL) p_WitDelaymsFunc(1);
	else ;
	if(WitWriteReg(BANDWIDTH, uiBaudWidth) != WIT_HAL_OK)	return  WIT_HAL_ERROR;
	return WIT_HAL_OK;
}

/*change output rate */
int32_t WitSetOutputRate(int32_t uiRate)
{	
	if(!CheckRange(uiRate,RRATE_02HZ,RRATE_NONE))
	{
		return WIT_HAL_INVAL;
	}
	if(WitWriteReg(KEY, KEY_UNLOCK) != WIT_HAL_OK)	return  WIT_HAL_ERROR;
	if(s_uiProtoclo == WIT_PROTOCOL_MODBUS)	p_WitDelaymsFunc(20);
	else if(s_uiProtoclo == WIT_PROTOCOL_NORMAL) p_WitDelaymsFunc(1);
	else ;
	if(WitWriteReg(RRATE, uiRate) != WIT_HAL_OK)	return  WIT_HAL_ERROR;
	return WIT_HAL_OK;
}

/*change WitSetContent */
int32_t WitSetContent(int32_t uiRsw)
{	
	if(!CheckRange(uiRsw,RSW_TIME,RSW_MASK))
	{
		return WIT_HAL_INVAL;
	}
	if(WitWriteReg(KEY, KEY_UNLOCK) != WIT_HAL_OK)	return  WIT_HAL_ERROR;
	if(s_uiProtoclo == WIT_PROTOCOL_MODBUS)	p_WitDelaymsFunc(20);
	else if(s_uiProtoclo == WIT_PROTOCOL_NORMAL) p_WitDelaymsFunc(1);
	else ;
	if(WitWriteReg(RSW, uiRsw) != WIT_HAL_OK)	return  WIT_HAL_ERROR;
	return WIT_HAL_OK;
}

void IT_JY61P(void){
    if(GyroscopeUsart3RxBuffer[0] == 0x55)
    {
        uint16_t AccelerationSumData = 0, AngularSumData = 0, AngleSumData = 0;
        for(uint8_t index = 0; index < GYROSCOPE_BUFFER_SIZE/3-1; index++)
            AccelerationSumData += GyroscopeUsart3RxBuffer[index];

        for(uint8_t index = GYROSCOPE_BUFFER_SIZE/3; index < 2*GYROSCOPE_BUFFER_SIZE/3-1; index++)
            AngularSumData += GyroscopeUsart3RxBuffer[index];

        for(uint8_t index = 2*GYROSCOPE_BUFFER_SIZE/3; index < GYROSCOPE_BUFFER_SIZE-1; index++)
            AngleSumData += GyroscopeUsart3RxBuffer[index];

        if(GyroscopeUsart3RxBuffer[GYROSCOPE_BUFFER_SIZE/3-1] == (uint8_t)(AccelerationSumData & 0x00FF)
        && GyroscopeUsart3RxBuffer[2*GYROSCOPE_BUFFER_SIZE/3-1] == (uint8_t)(AngularSumData & 0x00FF)
        && GyroscopeUsart3RxBuffer[GYROSCOPE_BUFFER_SIZE-1] == (uint8_t)(AngleSumData & 0x00FF))
        {
            JY61P_DecodeFrame(GyroscopeUsart3RxBuffer);
            JY61P_DecodeFrame(&GyroscopeUsart3RxBuffer[11]);
            JY61P_DecodeFrame(&GyroscopeUsart3RxBuffer[22]);
        }
    }
    else
    {
        memset(GyroscopeUsart3RxBuffer, 0x00, sizeof(GyroscopeUsart3RxBuffer));
    }
}

void GYROSCOPE_DATA_Decoder(uint8_t *buf)
{
    if(buf == NULL){
        return;
    }

    /* JY61P 标准串口输出为 11 字节子帧：0x51 加速度、0x52 角速度、0x53 姿态角。 */
    JY61P_DecodeFrame(buf);
}

void JY61P_Init(UART_Regs *uart){
    (void)uart;
    memset(GyroscopeUsart3RxBuffer, 0x00, sizeof(GyroscopeUsart3RxBuffer));
}

int32_t WitGetAcc(WIT_VECTOR3F *out)
{
    if(out == NULL)return WIT_HAL_INVAL;

    out->x = (float)GyroscopeChannelData[0];
    out->y = (float)GyroscopeChannelData[1];
    out->z = (float)GyroscopeChannelData[2];
    return WIT_HAL_OK;
}

int32_t WitGetGyro(WIT_VECTOR3F *out)
{
    if(out == NULL)return WIT_HAL_INVAL;

    out->x = (float)GyroscopeChannelData[3];
    out->y = (float)GyroscopeChannelData[4];
    out->z = (float)GyroscopeChannelData[5];
    return WIT_HAL_OK;
}

int32_t WitGetAttitude(WIT_ATTITUDE *out)
{
    if(out == NULL)return WIT_HAL_INVAL;

    out->roll = (float)GyroscopeChannelData[6];
    out->pitch = (float)GyroscopeChannelData[7];
    out->yaw = (float)GyroscopeChannelData[8];
    return WIT_HAL_OK;
}

int32_t WitGetData(WIT_IMU_DATA *out)
{
    if(out == NULL)return WIT_HAL_INVAL;

    out->acc_g.x = (float)GyroscopeChannelData[0];
    out->acc_g.y = (float)GyroscopeChannelData[1];
    out->acc_g.z = (float)GyroscopeChannelData[2];
    out->gyro_deg_s.x = (float)GyroscopeChannelData[3];
    out->gyro_deg_s.y = (float)GyroscopeChannelData[4];
    out->gyro_deg_s.z = (float)GyroscopeChannelData[5];
    out->attitude_deg.roll = (float)GyroscopeChannelData[6];
    out->attitude_deg.pitch = (float)GyroscopeChannelData[7];
    out->attitude_deg.yaw = (float)GyroscopeChannelData[8];
    out->temperature_c = (float)GyroscopeChannelData[9];
    return WIT_HAL_OK;
}


/* ═══════════════════════════════════════════════════════════════════════════
 * JY61P 硬件 I2C 驱动实现 (替代 UART 方式)
 *
 * 参考: MSPM0 SDK i2c_controller_rw_multibyte_fifo_poll (官方 FIFO 轮询模式)
 *       MSPM0 SDK data_sensor_aggregator (多 I2C 传感器采集)
 *
 * 外设: I2C0 (SysConfig), PA0=SDA, PA1=SCL, 400kHz, 设备地址 0x50
 * 轮询: 当前由使用 JY61P 的 app 任务在每个 20ms 控制拍调用 JY61P_I2C_Poll()
 * ═══════════════════════════════════════════════════════════════════════════ */

#include "bsp_time.h"
#include <ti/driverlib/dl_common.h>

#define JY61P_I2C_INST          Gray_JY61P_I2C_INST
#define JY61P_I2C_IRQN          Gray_JY61P_I2C_INST_INT_IRQN
/* 单次读寄存器字节数 (acc/angle/gyro 各 6 字节) */
#define JY61P_I2C_READ_LEN      6U
/* 事务看门狗超时(ms): 中断状态机卡住超过此值则复位, 防止 IMU 数据永久冻结。
 * 正常一轮"读acc→读angle→读gyro"< 1ms 完成; 看门狗由 5ms 一次的 Poll 检查。 */
#define JY61P_I2C_XFER_TIMEOUT_MS 50U

static volatile uint32_t s_jy61p_i2c_poll_count;
static volatile uint32_t s_jy61p_i2c_error_count;
static volatile uint32_t s_jy61p_i2c_nack_count;
static volatile uint32_t s_jy61p_i2c_sample_count;
static volatile uint32_t s_jy61p_i2c_last_sample_ms;
/* 故障分类状态：OLED 直接显示，避免每次都靠猜 */
static volatile JY61P_HEALTH s_jy61p_health = JY61P_HEALTH_NO_DATA;
static volatile uint32_t s_jy61p_snapshot_sequence;
static volatile JY61P_I2C_SAMPLE s_jy61p_snapshot;
static WIT_VECTOR3F s_jy61p_staging_acc;
static WIT_ATTITUDE s_jy61p_staging_attitude;
static WIT_VECTOR3F s_jy61p_staging_gyro;
/* 软件加速度零偏（g），由校准页面采集静态均值后写入，PublishAccel 中直接扣除。 */
static float s_jy61p_acc_offset_x;
static float s_jy61p_acc_offset_y;
static float s_jy61p_acc_offset_z;

/*
 * 中断驱动异步读状态机: Poll 只 kick 一次"读acc→读angle→读gyro"链并立即返回,
 * 实际传输由 I2C0 中断逐阶段推进, 不在任何 ISR 里忙等。
 */
typedef enum {
    JY61P_I2C_IDLE = 0,
    JY61P_I2C_ACCEL_TX,   /* 已发 acc 寄存器地址，等 TX_DONE */
    JY61P_I2C_ACCEL_RX,   /* 重复起始读 6 字节，等 RX_DONE */
    JY61P_I2C_ANGLE_TX,   /* 已发 angle 寄存器地址(TX, 不发 STOP), 等 TX_DONE */
    JY61P_I2C_ANGLE_RX,   /* 重复起始读 6 字节, 等 RX_DONE */
    JY61P_I2C_GYRO_TX,    /* 已发 gyro 寄存器地址, 等 TX_DONE */
    JY61P_I2C_GYRO_RX,    /* 读 6 字节, 等 RX_DONE */
} JY61P_I2C_STATE;

static volatile JY61P_I2C_STATE s_jy61p_state;
static volatile uint32_t s_jy61p_state_ms;   /* 进入当前非 IDLE 态的时间戳 (看门狗用) */
static uint8_t s_jy61p_rx[JY61P_I2C_READ_LEN];
static volatile uint8_t s_jy61p_rx_count;

/* ═══════════════ 中断驱动异步 I2C 底层 (非阻塞) ═══════════════════════════ */

static volatile uint32_t s_jy61p_recover_count;

/*
 * I2C 总线死锁恢复 (关键修复)
 * ---------------------------------------------------------------
 * 故障现象: 陀螺仪跑几秒后数据永久冻结，OLED 上除编码器里程 D 之外
 *           所有数值都不再变化，断电重启后依旧。
 *
 * 根因: JY61P 是标准 I2C 从机。当主机在一次字节传输中途超时并调用
 *       DL_I2C_resetControllerTransfer() 强行中止时，从机仍停在"发送
 *       第 N 个 bit"的状态，会持续把 SDA 拉低等待 SCL。此时总线被
 *       从机死锁在低电平，之后每一次事务都在 IDLE 检测处超时，
 *       控制器再怎么 reset 也无法让从机释放 SDA —— 必须由主机手动
 *       补发时钟脉冲，把从机移位寄存器里的残留位全部顶出来。
 *
 * 处理: 把 SCL/SDA 临时切成普通 GPIO，打 9 个时钟 + 一个手工 STOP，
 *       再把引脚还原成 I2C 复用。这是 I2C 规范推荐的标准总线恢复流程。
 */
static void JY61P_I2C_BusRecover(void)
{
    s_jy61p_recover_count++;

    DL_I2C_disableController(JY61P_I2C_INST);

    /* SCL / SDA 从 I2C 复用切回普通 GPIO 输出，先都置高 */
    DL_GPIO_initDigitalOutput(GPIO_Gray_JY61P_I2C_IOMUX_SCL);
    DL_GPIO_initDigitalOutput(GPIO_Gray_JY61P_I2C_IOMUX_SDA);
    DL_GPIO_setPins(GPIO_Gray_JY61P_I2C_SCL_PORT, GPIO_Gray_JY61P_I2C_SCL_PIN);
    DL_GPIO_setPins(GPIO_Gray_JY61P_I2C_SDA_PORT, GPIO_Gray_JY61P_I2C_SDA_PIN);
    DL_GPIO_enableOutput(GPIO_Gray_JY61P_I2C_SCL_PORT, GPIO_Gray_JY61P_I2C_SCL_PIN);
    DL_GPIO_enableOutput(GPIO_Gray_JY61P_I2C_SDA_PORT, GPIO_Gray_JY61P_I2C_SDA_PIN);
    DL_Common_delayCycles(320U);            /* ~10us @32MHz */

    /* 9 个 SCL 时钟: 从机每看到一个时钟就移出一位，最多 9 个必定清空 */
    for (uint8_t i = 0U; i < 9U; i++){
        DL_GPIO_clearPins(GPIO_Gray_JY61P_I2C_SCL_PORT, GPIO_Gray_JY61P_I2C_SCL_PIN);
        DL_Common_delayCycles(320U);
        DL_GPIO_setPins(GPIO_Gray_JY61P_I2C_SCL_PORT, GPIO_Gray_JY61P_I2C_SCL_PIN);
        DL_Common_delayCycles(320U);
    }

    /* 手工 STOP: SCL 保持高电平期间，SDA 由低变高 */
    DL_GPIO_clearPins(GPIO_Gray_JY61P_I2C_SDA_PORT, GPIO_Gray_JY61P_I2C_SDA_PIN);
    DL_Common_delayCycles(320U);
    DL_GPIO_setPins(GPIO_Gray_JY61P_I2C_SCL_PORT, GPIO_Gray_JY61P_I2C_SCL_PIN);
    DL_Common_delayCycles(320U);
    DL_GPIO_setPins(GPIO_Gray_JY61P_I2C_SDA_PORT, GPIO_Gray_JY61P_I2C_SDA_PIN);
    DL_Common_delayCycles(320U);

    /* 还原为 I2C0 复用功能 */
    DL_GPIO_initPeripheralInputFunctionFeatures(GPIO_Gray_JY61P_I2C_IOMUX_SDA,
        GPIO_Gray_JY61P_I2C_IOMUX_SDA_FUNC, DL_GPIO_INVERSION_DISABLE,
        DL_GPIO_RESISTOR_NONE, DL_GPIO_HYSTERESIS_DISABLE,
        DL_GPIO_WAKEUP_DISABLE);
    DL_GPIO_initPeripheralInputFunctionFeatures(GPIO_Gray_JY61P_I2C_IOMUX_SCL,
        GPIO_Gray_JY61P_I2C_IOMUX_SCL_FUNC, DL_GPIO_INVERSION_DISABLE,
        DL_GPIO_RESISTOR_NONE, DL_GPIO_HYSTERESIS_DISABLE,
        DL_GPIO_WAKEUP_DISABLE);

    DL_I2C_enableController(JY61P_I2C_INST);
    DL_I2C_resetControllerTransfer(JY61P_I2C_INST);
}

/* ═══════════ 单次寄存器读：写地址 → 重复起始 → 读数据 ═══════════
 *
 * 为什么必须是"重复起始"而不是"写一次(带STOP) + 再读一次(START)"：
 *   JY61P 的寄存器指针在 STOP 之后失效，第二次 START 读回的是未定义数据；
 *   更糟的是从机若停在"移出第 N 个 bit"的半字节状态，会一直拉住 SDA，
 *   于是后续事务全部超时 → 复位 → 再超时，IMU 数据永久冻结。
 *   这正是"跑几秒数据不动、只剩编码器里程在变"的物理成因。
 *
 * 实现照搬 SDK 官方 i2c_controller_rw_repeated_start 例程：
 *   TX 阶段 STOP_DISABLE，RX 阶段紧接 START_ENABLE/STOP_ENABLE，
 *   由硬件自动产生重复起始。
 */
typedef enum {
    JY61P_XFER_OK = 0,
    JY61P_XFER_NACK,      /* 从机无应答：地址/供电/接线/模式问题 */
    JY61P_XFER_TIMEOUT    /* 控制器或总线无响应 */
} JY61P_XFER_RESULT;

#define JY61P_I2C_GUARD_IDLE   40000U   /* 等控制器空闲 */
#define JY61P_I2C_GUARD_XFER   40000U   /* 等单次字节/总线释放 */

static JY61P_XFER_RESULT JY61P_I2C_ReadRegistersEx(uint8_t reg, uint8_t *dest, uint8_t len)
{
    uint32_t guard;
    uint32_t status;

    /* 1) 等控制器空闲 */
    guard = JY61P_I2C_GUARD_IDLE;
    while (((status = DL_I2C_getControllerStatus(JY61P_I2C_INST)) &
            DL_I2C_CONTROLLER_STATUS_IDLE) == 0U){
        if (--guard == 0U){ return JY61P_XFER_TIMEOUT; }
    }

    /* 2) 清掉上一次事务的残留 */
    DL_I2C_resetControllerTransfer(JY61P_I2C_INST);
    DL_I2C_flushControllerTXFIFO(JY61P_I2C_INST);
    DL_I2C_flushControllerRXFIFO(JY61P_I2C_INST);

    /* 3) TX：只发寄存器地址，抑制 STOP，为重复起始做准备 */
    DL_I2C_transmitControllerData(JY61P_I2C_INST, reg);
    DL_I2C_startControllerTransferAdvanced(JY61P_I2C_INST, JY61P_I2C_ADDR_7BIT,
        DL_I2C_CONTROLLER_DIRECTION_TX, 1U,
        DL_I2C_CONTROLLER_START_ENABLE,
        DL_I2C_CONTROLLER_STOP_DISABLE,
        DL_I2C_CONTROLLER_ACK_DISABLE);

    /* 4) 先确认 BUSY 已经置起，避免"刚启动就被判定为已完成"的竞态 */
    guard = 200U;
    while (((status = DL_I2C_getControllerStatus(JY61P_I2C_INST)) &
            DL_I2C_CONTROLLER_STATUS_BUSY) == 0U){
        if (--guard == 0U){ break; }
    }

    /* 5) 等这个地址字节移出：控制器 BUSY 清零（总线仍被主机占用） */
    guard = JY61P_I2C_GUARD_XFER;
    while (((status = DL_I2C_getControllerStatus(JY61P_I2C_INST)) &
            DL_I2C_CONTROLLER_STATUS_BUSY) != 0U){
        if (--guard == 0U){ return JY61P_XFER_TIMEOUT; }
    }
    if ((status & DL_I2C_CONTROLLER_STATUS_ERROR) != 0U){
        return JY61P_XFER_NACK;      /* 从机 NACK，重试无意义 */
    }

    /* 6) RX：紧接着发重复起始读 len 字节，这次允许 STOP */
    DL_I2C_startControllerTransferAdvanced(JY61P_I2C_INST, JY61P_I2C_ADDR_7BIT,
        DL_I2C_CONTROLLER_DIRECTION_RX, len,
        DL_I2C_CONTROLLER_START_ENABLE,
        DL_I2C_CONTROLLER_STOP_ENABLE,
        DL_I2C_CONTROLLER_ACK_DISABLE);

    for (uint8_t i = 0U; i < len; i++){
        guard = JY61P_I2C_GUARD_XFER;
        while (DL_I2C_isControllerRXFIFOEmpty(JY61P_I2C_INST)){
            if (--guard == 0U){ return JY61P_XFER_TIMEOUT; }
        }
        dest[i] = DL_I2C_receiveControllerData(JY61P_I2C_INST);
    }

    /* 7) 等总线真正释放，确认 STOP 已发出 */
    guard = JY61P_I2C_GUARD_XFER;
    while (((status = DL_I2C_getControllerStatus(JY61P_I2C_INST)) &
            DL_I2C_CONTROLLER_STATUS_BUSY_BUS) != 0U){
        if (--guard == 0U){ return JY61P_XFER_TIMEOUT; }
    }
    if ((status & DL_I2C_CONTROLLER_STATUS_ERROR) != 0U){
        return JY61P_XFER_NACK;
    }

    return JY61P_XFER_OK;
}
/* ═══════════════════ 应用层接口 ═══════════════════════════════════════════ */

static int16_t JY61P_I2C_ParseI16(const uint8_t *buf)
{
    return (int16_t)(((uint16_t)buf[1] << 8) | (uint16_t)buf[0]);
}

static float JY61P_I2C_ParseAngle(int16_t raw)
{
    float angle = (float)raw / 32768.0f * 180.0f;
    if (angle > 180.0f)       { angle -= 360.0f; }
    else if (angle < -180.0f) { angle += 360.0f; }
    return angle;
}

/* 把接收缓冲的 6 字节 acc 帧解码为 g；量程与厂家串口协议一致，为 ±16 g。 */
static void JY61P_I2C_PublishAccel(const uint8_t *buf)
{
    s_jy61p_staging_acc.x =
        (float)JY61P_I2C_ParseI16(&buf[0]) / 32768.0f * 16.0f
        - s_jy61p_acc_offset_x;
    s_jy61p_staging_acc.y =
        (float)JY61P_I2C_ParseI16(&buf[2]) / 32768.0f * 16.0f
        - s_jy61p_acc_offset_y;
    s_jy61p_staging_acc.z =
        (float)JY61P_I2C_ParseI16(&buf[4]) / 32768.0f * 16.0f
        - s_jy61p_acc_offset_z;
    GyroscopeChannelData[0] = (double)s_jy61p_staging_acc.x;
    GyroscopeChannelData[1] = (double)s_jy61p_staging_acc.y;
    GyroscopeChannelData[2] = (double)s_jy61p_staging_acc.z;
}

void JY61P_I2C_SetAccelOffset(float ox, float oy, float oz)
{
    s_jy61p_acc_offset_x = ox;
    s_jy61p_acc_offset_y = oy;
    s_jy61p_acc_offset_z = oz;
}

void JY61P_I2C_GetAccelOffset(float *ox, float *oy, float *oz)
{
    if (ox != NULL){ *ox = s_jy61p_acc_offset_x; }
    if (oy != NULL){ *oy = s_jy61p_acc_offset_y; }
    if (oz != NULL){ *oz = s_jy61p_acc_offset_z; }
}

/* 把接收缓冲的 6 字节 angle 帧解码并发布到 GyroscopeChannelData[6..8]。 */
static void JY61P_I2C_PublishAngle(const uint8_t *buf)
{
    s_jy61p_staging_attitude.roll =
        JY61P_I2C_ParseAngle(JY61P_I2C_ParseI16(&buf[0]));
    s_jy61p_staging_attitude.pitch =
        JY61P_I2C_ParseAngle(JY61P_I2C_ParseI16(&buf[2]));
    /* 陀螺仪安装于底盘底部，翻转航向角正负方向 */
    s_jy61p_staging_attitude.yaw =
        -JY61P_I2C_ParseAngle(JY61P_I2C_ParseI16(&buf[4]));
    GyroscopeChannelData[6] = (double)s_jy61p_staging_attitude.roll;
    GyroscopeChannelData[7] = (double)s_jy61p_staging_attitude.pitch;
    GyroscopeChannelData[8] = (double)s_jy61p_staging_attitude.yaw;
}

/* 把接收缓冲的 6 字节 gyro 帧解码并发布到 GyroscopeChannelData[3..5] (deg/s)。 */
static void JY61P_I2C_PublishGyro(const uint8_t *buf)
{
    s_jy61p_staging_gyro.x =
        (float)JY61P_I2C_ParseI16(&buf[0]) / 32768.0f * 2000.0f;
    s_jy61p_staging_gyro.y =
        (float)JY61P_I2C_ParseI16(&buf[2]) / 32768.0f * 2000.0f;
    s_jy61p_staging_gyro.z =
        (float)JY61P_I2C_ParseI16(&buf[4]) / 32768.0f * 2000.0f;
    GyroscopeChannelData[3] = (double)s_jy61p_staging_gyro.x;
    GyroscopeChannelData[4] = (double)s_jy61p_staging_gyro.y;
    GyroscopeChannelData[5] = (double)s_jy61p_staging_gyro.z;
}

/** acc、angle 与 gyro 都完成后，在 ISR 内一次性发布一致快照。 */
static void JY61P_I2C_PublishSnapshot(void)
{
    uint32_t timestamp_ms = BSP_Time_GetMs();
    uint32_t sample_count = s_jy61p_i2c_sample_count + 1U;

    s_jy61p_snapshot_sequence++;  /* 奇数表示写入中。 */
    __DMB();
    s_jy61p_snapshot.data.acc_g.x = s_jy61p_staging_acc.x;
    s_jy61p_snapshot.data.acc_g.y = s_jy61p_staging_acc.y;
    s_jy61p_snapshot.data.acc_g.z = s_jy61p_staging_acc.z;
    s_jy61p_snapshot.data.gyro_deg_s.x = s_jy61p_staging_gyro.x;
    s_jy61p_snapshot.data.gyro_deg_s.y = s_jy61p_staging_gyro.y;
    s_jy61p_snapshot.data.gyro_deg_s.z = s_jy61p_staging_gyro.z;
    s_jy61p_snapshot.data.attitude_deg.roll = s_jy61p_staging_attitude.roll;
    s_jy61p_snapshot.data.attitude_deg.pitch = s_jy61p_staging_attitude.pitch;
    s_jy61p_snapshot.data.attitude_deg.yaw = s_jy61p_staging_attitude.yaw;
    s_jy61p_snapshot.data.temperature_c = 0.0f;
    s_jy61p_snapshot.sample_count = sample_count;
    s_jy61p_snapshot.timestamp_ms = timestamp_ms;
    s_jy61p_i2c_sample_count = sample_count;
    s_jy61p_i2c_last_sample_ms = timestamp_ms;
    __DMB();
    s_jy61p_snapshot_sequence++;  /* 偶数表示完整快照可读。 */
}

/* 挂起标志: 与 MPU6050 共用 I2C0 时, 测试期挂起 JY61P (停轮询 + 关 I2C0 NVIC),
 * 避免 MPU6050 的 I2C 事务触发本驱动的 I2C0 中断而误动状态机/污染总线。 */
static volatile bool s_jy61p_suspended;

void JY61P_I2C_SetSuspended(bool suspend)
{
    if (suspend){
        s_jy61p_suspended = true;
        NVIC_DisableIRQ(JY61P_I2C_IRQN);
        DL_I2C_resetControllerTransfer(JY61P_I2C_INST);
        s_jy61p_state = JY61P_I2C_IDLE;
    } else{
        s_jy61p_state = JY61P_I2C_IDLE;
        NVIC_ClearPendingIRQ(JY61P_I2C_IRQN);
        NVIC_DisableIRQ(JY61P_I2C_IRQN);
        s_jy61p_suspended = false;
    }
}

bool JY61P_I2C_IsIdle(void)
{
    return (s_jy61p_state == JY61P_I2C_IDLE) &&
           ((DL_I2C_getControllerStatus(JY61P_I2C_INST) &
             DL_I2C_CONTROLLER_STATUS_IDLE) != 0U);
}

void JY61P_I2C_Init(void)
{
    s_jy61p_i2c_poll_count  = 0U;
    s_jy61p_i2c_error_count = 0U;
    s_jy61p_i2c_nack_count  = 0U;
    s_jy61p_i2c_sample_count = 0U;
    s_jy61p_i2c_last_sample_ms = 0U;
    s_jy61p_snapshot_sequence = 0U;
    s_jy61p_snapshot = (JY61P_I2C_SAMPLE){0};
    s_jy61p_staging_acc = (WIT_VECTOR3F){0};
    s_jy61p_staging_attitude = (WIT_ATTITUDE){0};
    s_jy61p_staging_gyro = (WIT_VECTOR3F){0};
    s_jy61p_state           = JY61P_I2C_IDLE;
    s_jy61p_suspended       = false;
    s_jy61p_health          = JY61P_HEALTH_NO_DATA;
    /* 校准已固化在 JY61P flash 中, 上电无需重复执行 */

    /*
     * 【关键】把 I2C0 从 400kHz 降到 100kHz。
     * JY61P 在 400kHz 下对总线时序余量很小（上升沿、时钟拉伸都吃紧），
     * 偶发一个位错误就会让从机停在"半字节"状态并把 SDA 拉低，
     * 之后主机每次事务都超时 —— 这正是"跑几秒就冻结、只剩编码器里程在动"
     * 的物理成因。100kHz 是 WitMotion 官方推荐值，实测最稳。
     * 32MHz / ((TPR+1) * 10) = 100kHz  =>  TPR = 31
     */
    DL_I2C_setTimerPeriod(JY61P_I2C_INST, 31U);

    /* I2C 事件中断由 SysConfig 生成的 init 使能 (intController);
     * 此处只开 NVIC。优先级 2: 低于 UART/视觉的 1, 且 ISR 很短(仅排空 6 字节)。 */
    NVIC_SetPriority(JY61P_I2C_IRQN, 2U);
    NVIC_ClearPendingIRQ(JY61P_I2C_IRQN);
    NVIC_DisableIRQ(JY61P_I2C_IRQN);
}

/*
 * 非阻塞 kick + 看门狗 (当前由 app 任务每 20ms 调用一次):
 *   - 上一轮事务仍在进行且未超时 -> 本拍不动 (让中断继续推进);
 *   - 事务卡死超过看门狗阈值 -> 复位控制器回 IDLE, 防 IMU 数据永久冻结;
 *   - 空闲则启动新一轮 "读acc -> 读angle -> 读gyro" 链, 立即返回。
 * 实际传输全部在 I2C0 中断里推进, 本函数不忙等。
 */
/* 50Hz 同步轮询采集: 一轮约 0.6ms, 全部带超时, 绝不永久阻塞主循环 */
void JY61P_I2C_Poll(void)
{
    static uint32_t s_last_poll_ms = 0U;
    uint32_t now_ms = BSP_Time_GetMs();
    uint8_t acc_buf[6];
    uint8_t angle_buf[6];
    uint8_t gyro_buf[6];
    JY61P_XFER_RESULT res;

    if (s_jy61p_suspended){ return; }

    if ((now_ms - s_last_poll_ms) < 20U && s_last_poll_ms > 0U){
        return;
    }
    s_last_poll_ms = now_ms;

    res = JY61P_I2C_ReadRegistersEx(JY61P_I2C_REG_ACCEL, acc_buf, 6U);
    if (res == JY61P_XFER_OK){
        res = JY61P_I2C_ReadRegistersEx(JY61P_I2C_REG_ANGLE, angle_buf, 6U);
    }
    if (res == JY61P_XFER_OK){
        res = JY61P_I2C_ReadRegistersEx(JY61P_I2C_REG_GYRO, gyro_buf, 6U);
    }

    if (res == JY61P_XFER_OK){
        JY61P_I2C_PublishAccel(acc_buf);
        JY61P_I2C_PublishAngle(angle_buf);
        JY61P_I2C_PublishGyro(gyro_buf);
        JY61P_I2C_PublishSnapshot();
        s_jy61p_i2c_poll_count++;
        s_jy61p_health = JY61P_HEALTH_OK;
        return;
    }

    s_jy61p_i2c_error_count++;
    if (res == JY61P_XFER_NACK){
        /* 从机不应答 —— 总线本身是好的（时钟/上拉正常，只是没人 ACK）。
         * 这种情况做"打 9 个时钟"的总线恢复毫无意义，只会白花 180us。 */
        s_jy61p_i2c_nack_count++;
        s_jy61p_health = JY61P_HEALTH_NACK;
    } else {
        /* 控制器/总线卡死 —— 必须由主机补时钟把从机移位寄存器顶空 */
        s_jy61p_health = JY61P_HEALTH_TIMEOUT;
        JY61P_I2C_BusRecover();
    }
}

JY61P_HEALTH JY61P_I2C_GetHealth(void)
{
    return s_jy61p_health;
}

void I2C0_IRQHandler(void)
{
    /* 同步轮询模式下无需中断推进, 排空标志即返回 */
    (void)DL_I2C_getPendingInterrupt(JY61P_I2C_INST);
}

/* ═══════════════════ 阻塞 I2C 写（校准命令用）═══════════════════════ */

/** 通用阻塞 I2C 写：reg + len 字节数据，发 START 和 STOP，等总线释放。 */
static void JY61P_I2C_WriteBytes(uint8_t reg, const uint8_t *data, uint8_t len)
{
    /* 等当前事务结束；此处必须有超时，否则一旦总线被从机拉死就永久卡在这里 */
    uint32_t timeout = 10000U;
    while (!JY61P_I2C_IsIdle()){
        if (timeout-- == 0U){
            JY61P_I2C_BusRecover();
            return;
        }
    }
    DL_I2C_flushControllerRXFIFO(JY61P_I2C_INST);
    DL_I2C_flushControllerTXFIFO(JY61P_I2C_INST);
    DL_I2C_transmitControllerData(JY61P_I2C_INST, reg);
    for (uint8_t i = 0U; i < len; i++){
        DL_I2C_transmitControllerData(JY61P_I2C_INST, data[i]);
    }
    DL_I2C_startControllerTransferAdvanced(JY61P_I2C_INST, JY61P_I2C_ADDR_7BIT,
        DL_I2C_CONTROLLER_DIRECTION_TX, (uint32_t)(1U + len),
        DL_I2C_CONTROLLER_START_ENABLE,
        DL_I2C_CONTROLLER_STOP_ENABLE,
        DL_I2C_CONTROLLER_ACK_DISABLE);
    timeout = 20000U;
    while (!(DL_I2C_getControllerStatus(JY61P_I2C_INST) &
             DL_I2C_CONTROLLER_STATUS_IDLE)){
        if (timeout-- == 0U){
            JY61P_I2C_BusRecover();
            return;
        }
    }
    DL_I2C_resetControllerTransfer(JY61P_I2C_INST);
    s_jy61p_state = JY61P_I2C_IDLE;
}

void JY61P_I2C_WriteReg(uint8_t reg, uint8_t val)
{
    JY61P_I2C_WriteBytes(reg, &val, 1U);
}

void JY61P_I2C_WriteReg16(uint8_t reg, uint16_t val)
{
    uint8_t buf[2];
    buf[0] = (uint8_t)(val & 0xFFU);
    buf[1] = (uint8_t)((val >> 8) & 0xFFU);
    JY61P_I2C_WriteBytes(reg, buf, 2U);
}

uint32_t JY61P_I2C_GetPollCount(void)    { return s_jy61p_i2c_poll_count; }
uint32_t JY61P_I2C_GetErrorCount(void)   { return s_jy61p_i2c_error_count; }
uint32_t JY61P_I2C_GetRecoverCount(void) { return s_jy61p_recover_count; }
uint32_t JY61P_I2C_GetNackCount(void)    { return s_jy61p_i2c_nack_count; }
uint32_t JY61P_I2C_GetTimeoutCount(void) { return s_jy61p_i2c_error_count; }
uint32_t JY61P_I2C_GetSampleCount(void)  { return s_jy61p_i2c_sample_count; }

bool JY61P_I2C_GetSnapshot(JY61P_I2C_SAMPLE *out)
{
    if (out == NULL){
        return false;
    }

    uint32_t sequence_before;
    uint32_t sequence_after;
    for (;;){
        sequence_before = s_jy61p_snapshot_sequence;
        if ((sequence_before & 1U) != 0U){
            continue;
        }
        __DMB();
        out->data.acc_g.x = s_jy61p_snapshot.data.acc_g.x;
        out->data.acc_g.y = s_jy61p_snapshot.data.acc_g.y;
        out->data.acc_g.z = s_jy61p_snapshot.data.acc_g.z;
        out->data.gyro_deg_s.x = s_jy61p_snapshot.data.gyro_deg_s.x;
        out->data.gyro_deg_s.y = s_jy61p_snapshot.data.gyro_deg_s.y;
        out->data.gyro_deg_s.z = s_jy61p_snapshot.data.gyro_deg_s.z;
        out->data.attitude_deg.roll = s_jy61p_snapshot.data.attitude_deg.roll;
        out->data.attitude_deg.pitch = s_jy61p_snapshot.data.attitude_deg.pitch;
        out->data.attitude_deg.yaw = s_jy61p_snapshot.data.attitude_deg.yaw;
        out->data.temperature_c = s_jy61p_snapshot.data.temperature_c;
        out->sample_count = s_jy61p_snapshot.sample_count;
        out->timestamp_ms = s_jy61p_snapshot.timestamp_ms;
        __DMB();
        sequence_after = s_jy61p_snapshot_sequence;
        if ((sequence_before == sequence_after) &&
            ((sequence_after & 1U) == 0U)){
            break;
        }
    }

    return out->sample_count != 0U;
}

bool JY61P_I2C_IsDataFresh(uint32_t max_age_ms)
{
    if (s_jy61p_i2c_sample_count == 0U){
        return false;
    }
    return (uint32_t)(BSP_Time_GetMs() - s_jy61p_i2c_last_sample_ms) <= max_age_ms;
}
