VincentttWang/MSP430_WirelessCar/NUEDC_2026/[Demo] MSPM0_Car_v5/bsp/oled/oled_font_arial.h

/**
 * @file      oled_font_arial.h
 * @brief     高清晰度无衬线粗体 (Arial Bold) 点阵字体库
 * @details   包含 10pt (标题栏专用) 与 13pt (主数据大字号专用) 字体点阵
 *            针对 128x64 OLED 屏幕调优，比例字宽，支持微距排版
 */

#ifndef OLED_FONT_ARIAL_H
#define OLED_FONT_ARIAL_H

#include <stdint.h>

typedef struct {
    uint8_t width;       /* 点阵有效像素宽度 (列数) */
    uint8_t advance;     /* 字符排版光标步进步长 */
    uint16_t cols[12];   /* 每列 16 位垂直像素位掩码 (bit0 为顶, bit15 为底) */
} ArialGlyph_t;

static const ArialGlyph_t g_arial_bold_10[95] = {
    {3U, 3U, {0x0000U, 0x0000U, 0x0000U, 0x0000U, 0x0000U, 0x0000U, 0x0000U, 0x0000U, 0x0000U, 0x0000U, 0x0000U, 0x0000U}}, /* ' ' (0x20) */
    {3U, 3U, {0x0000U, 0x02F8U, 0x0000U, 0x0000U, 0x0000U, 0x0000U, 0x0000U, 0x0000U, 0x0000U, 0x0000U, 0x0000U, 0x0000U}}, /* '!' (0x21) */
    {5U, 5U, {0x0000U, 0x0038U, 0x0000U, 0x0038U, 0x0000U, 0x0000U, 0x0000U, 0x0000U, 0x0000U, 0x0000U, 0x0000U, 0x0000U}}, /* '"' (0x22) */
    {6U, 6U, {0x03A0U, 0x00E0U, 0x00B8U, 0x03A0U, 0x00E0U, 0x00B8U, 0x0000U, 0x0000U, 0x0000U, 0x0000U, 0x0000U, 0x0000U}}, /* '#' (0x23) */
    {6U, 6U, {0x0130U, 0x0248U, 0x07FCU, 0x0248U, 0x0190U, 0x0000U, 0x0000U, 0x0000U, 0x0000U, 0x0000U, 0x0000U, 0x0000U}}, /* '$' (0x24) */
    {9U, 9U, {0x0078U, 0x0048U, 0x0278U, 0x0180U, 0x0040U, 0x0030U, 0x03C8U, 0x0240U, 0x03C0U, 0x0000U, 0x0000U, 0x0000U}}, /* '%' (0x25) */
    {7U, 7U, {0x0000U, 0x0180U, 0x0270U, 0x0248U, 0x01B8U, 0x0280U, 0x0000U, 0x0000U, 0x0000U, 0x0000U, 0x0000U, 0x0000U}}, /* '&' (0x26) */
    {2U, 2U, {0x0038U, 0x0000U, 0x0000U, 0x0000U, 0x0000U, 0x0000U, 0x0000U, 0x0000U, 0x0000U, 0x0000U, 0x0000U, 0x0000U}}, /* ''' (0x27) */
    {3U, 3U, {0x07F0U, 0x0808U, 0x0000U, 0x0000U, 0x0000U, 0x0000U, 0x0000U, 0x0000U, 0x0000U, 0x0000U, 0x0000U, 0x0000U}}, /* '(' (0x28) */
    {3U, 3U, {0x0000U, 0x0808U, 0x07F0U, 0x0000U, 0x0000U, 0x0000U, 0x0000U, 0x0000U, 0x0000U, 0x0000U, 0x0000U, 0x0000U}}, /* ')' (0x29) */
    {4U, 4U, {0x0050U, 0x0038U, 0x0050U, 0x0000U, 0x0000U, 0x0000U, 0x0000U, 0x0000U, 0x0000U, 0x0000U, 0x0000U, 0x0000U}}, /* '*' (0x2A) */
    {6U, 6U, {0x0040U, 0x0040U, 0x01F0U, 0x0040U, 0x0040U, 0x0000U, 0x0000U, 0x0000U, 0x0000U, 0x0000U, 0x0000U, 0x0000U}}, /* '+' (0x2B) */
    {3U, 3U, {0x0000U, 0x0E00U, 0x0000U, 0x0000U, 0x0000U, 0x0000U, 0x0000U, 0x0000U, 0x0000U, 0x0000U, 0x0000U, 0x0000U}}, /* ',' (0x2C) */
    {3U, 3U, {0x0080U, 0x0080U, 0x0000U, 0x0000U, 0x0000U, 0x0000U, 0x0000U, 0x0000U, 0x0000U, 0x0000U, 0x0000U, 0x0000U}}, /* '-' (0x2D) */
    {3U, 3U, {0x0000U, 0x0200U, 0x0000U, 0x0000U, 0x0000U, 0x0000U, 0x0000U, 0x0000U, 0x0000U, 0x0000U, 0x0000U, 0x0000U}}, /* '.' (0x2E) */
    {3U, 3U, {0x0300U, 0x00E0U, 0x0018U, 0x0000U, 0x0000U, 0x0000U, 0x0000U, 0x0000U, 0x0000U, 0x0000U, 0x0000U, 0x0000U}}, /* '/' (0x2F) */
    {6U, 6U, {0x01F0U, 0x0208U, 0x0208U, 0x0208U, 0x01F0U, 0x0000U, 0x0000U, 0x0000U, 0x0000U, 0x0000U, 0x0000U, 0x0000U}}, /* '0' (0x30) */
    {6U, 6U, {0x0000U, 0x0020U, 0x0010U, 0x03F8U, 0x0000U, 0x0000U, 0x0000U, 0x0000U, 0x0000U, 0x0000U, 0x0000U, 0x0000U}}, /* '1' (0x31) */
    {6U, 6U, {0x0210U, 0x0308U, 0x0288U, 0x0248U, 0x0230U, 0x0000U, 0x0000U, 0x0000U, 0x0000U, 0x0000U, 0x0000U, 0x0000U}}, /* '2' (0x32) */
    {6U, 6U, {0x0110U, 0x0208U, 0x0248U, 0x0248U, 0x01B0U, 0x0000U, 0x0000U, 0x0000U, 0x0000U, 0x0000U, 0x0000U, 0x0000U}}, /* '3' (0x33) */
    {6U, 6U, {0x0180U, 0x0160U, 0x0110U, 0x03F8U, 0x0100U, 0x0000U, 0x0000U, 0x0000U, 0x0000U, 0x0000U, 0x0000U, 0x0000U}}, /* '4' (0x34) */
    {6U, 6U, {0x0160U, 0x0238U, 0x0228U, 0x0228U, 0x01C8U, 0x0000U, 0x0000U, 0x0000U, 0x0000U, 0x0000U, 0x0000U, 0x0000U}}, /* '5' (0x35) */
    {6U, 6U, {0x01F0U, 0x0248U, 0x0248U, 0x0248U, 0x0190U, 0x0000U, 0x0000U, 0x0000U, 0x0000U, 0x0000U, 0x0000U, 0x0000U}}, /* '6' (0x36) */
    {6U, 6U, {0x0008U, 0x0008U, 0x0388U, 0x0068U, 0x0018U, 0x0000U, 0x0000U, 0x0000U, 0x0000U, 0x0000U, 0x0000U, 0x0000U}}, /* '7' (0x37) */
    {6U, 6U, {0x01B0U, 0x0248U, 0x0248U, 0x0248U, 0x01B0U, 0x0000U, 0x0000U, 0x0000U, 0x0000U, 0x0000U, 0x0000U, 0x0000U}}, /* '8' (0x38) */
    {6U, 6U, {0x0130U, 0x0248U, 0x0248U, 0x0248U, 0x01F0U, 0x0000U, 0x0000U, 0x0000U, 0x0000U, 0x0000U, 0x0000U, 0x0000U}}, /* '9' (0x39) */
    {3U, 3U, {0x0000U, 0x0220U, 0x0000U, 0x0000U, 0x0000U, 0x0000U, 0x0000U, 0x0000U, 0x0000U, 0x0000U, 0x0000U, 0x0000U}}, /* ':' (0x3A) */
    {3U, 3U, {0x0000U, 0x0E20U, 0x0000U, 0x0000U, 0x0000U, 0x0000U, 0x0000U, 0x0000U, 0x0000U, 0x0000U, 0x0000U, 0x0000U}}, /* ';' (0x3B) */
    {6U, 6U, {0x0040U, 0x00A0U, 0x00A0U, 0x00A0U, 0x0110U, 0x0000U, 0x0000U, 0x0000U, 0x0000U, 0x0000U, 0x0000U, 0x0000U}}, /* '<' (0x3C) */
    {6U, 6U, {0x00A0U, 0x00A0U, 0x00A0U, 0x00A0U, 0x00A0U, 0x0000U, 0x0000U, 0x0000U, 0x0000U, 0x0000U, 0x0000U, 0x0000U}}, /* '=' (0x3D) */
    {6U, 6U, {0x0110U, 0x00A0U, 0x00A0U, 0x00A0U, 0x0040U, 0x0000U, 0x0000U, 0x0000U, 0x0000U, 0x0000U, 0x0000U, 0x0000U}}, /* '>' (0x3E) */
    {6U, 6U, {0x0010U, 0x0008U, 0x0288U, 0x0048U, 0x0030U, 0x0000U, 0x0000U, 0x0000U, 0x0000U, 0x0000U, 0x0000U, 0x0000U}}, /* '?' (0x3F) */
    {10U, 10U, {0x03C0U, 0x0430U, 0x05D0U, 0x0A28U, 0x0A28U, 0x0928U, 0x0BE8U, 0x0A28U, 0x0510U, 0x04E0U, 0x0000U, 0x0000U}}, /* '@' (0x40) */
    {7U, 7U, {0x0200U, 0x01C0U, 0x00B0U, 0x0088U, 0x00B0U, 0x01C0U, 0x0200U, 0x0000U, 0x0000U, 0x0000U, 0x0000U, 0x0000U}}, /* 'A' (0x41) */
    {7U, 7U, {0x0000U, 0x03F8U, 0x0248U, 0x0248U, 0x0248U, 0x01B0U, 0x0000U, 0x0000U, 0x0000U, 0x0000U, 0x0000U, 0x0000U}}, /* 'B' (0x42) */
    {7U, 7U, {0x0000U, 0x01F0U, 0x0208U, 0x0208U, 0x0208U, 0x0110U, 0x0000U, 0x0000U, 0x0000U, 0x0000U, 0x0000U, 0x0000U}}, /* 'C' (0x43) */
    {7U, 7U, {0x0000U, 0x03F8U, 0x0208U, 0x0208U, 0x0208U, 0x01F0U, 0x0000U, 0x0000U, 0x0000U, 0x0000U, 0x0000U, 0x0000U}}, /* 'D' (0x44) */
    {7U, 7U, {0x0000U, 0x03F8U, 0x0248U, 0x0248U, 0x0248U, 0x0248U, 0x0000U, 0x0000U, 0x0000U, 0x0000U, 0x0000U, 0x0000U}}, /* 'E' (0x45) */
    {6U, 6U, {0x0000U, 0x03F8U, 0x0048U, 0x0048U, 0x0048U, 0x0000U, 0x0000U, 0x0000U, 0x0000U, 0x0000U, 0x0000U, 0x0000U}}, /* 'F' (0x46) */
    {8U, 8U, {0x0000U, 0x01F0U, 0x0208U, 0x0208U, 0x0248U, 0x0248U, 0x01D0U, 0x0000U, 0x0000U, 0x0000U, 0x0000U, 0x0000U}}, /* 'G' (0x47) */
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
    {3U, 3U, {0x0018U, 0x00E0U, 0x0300U, 0x0000U, 0x0000U, 0x0000U, 0x0000U, 0x0000U, 0x0000U, 0x0000U, 0x0000U, 0x0000U}}, /* 'code_92' (0x5C) */
    {3U, 3U, {0x0808U, 0x0FF8U, 0x0000U, 0x0000U, 0x0000U, 0x0000U, 0x0000U, 0x0000U, 0x0000U, 0x0000U, 0x0000U, 0x0000U}}, /* ']' (0x5D) */
    {6U, 6U, {0x0000U, 0x0060U, 0x0018U, 0x0018U, 0x0060U, 0x0000U, 0x0000U, 0x0000U, 0x0000U, 0x0000U, 0x0000U, 0x0000U}}, /* '^' (0x5E) */
    {6U, 6U, {0x0800U, 0x0800U, 0x0800U, 0x0800U, 0x0800U, 0x0800U, 0x0000U, 0x0000U, 0x0000U, 0x0000U, 0x0000U, 0x0000U}}, /* '_' (0x5F) */
    {3U, 3U, {0x0008U, 0x0010U, 0x0000U, 0x0000U, 0x0000U, 0x0000U, 0x0000U, 0x0000U, 0x0000U, 0x0000U, 0x0000U, 0x0000U}}, /* '`' (0x60) */
    {6U, 6U, {0x0120U, 0x02A0U, 0x02A0U, 0x02A0U, 0x03C0U, 0x0000U, 0x0000U, 0x0000U, 0x0000U, 0x0000U, 0x0000U, 0x0000U}}, /* 'a' (0x61) */
    {6U, 6U, {0x03F8U, 0x0220U, 0x0220U, 0x0220U, 0x01C0U, 0x0000U, 0x0000U, 0x0000U, 0x0000U, 0x0000U, 0x0000U, 0x0000U}}, /* 'b' (0x62) */
    {6U, 6U, {0x01C0U, 0x0220U, 0x0220U, 0x0220U, 0x0140U, 0x0000U, 0x0000U, 0x0000U, 0x0000U, 0x0000U, 0x0000U, 0x0000U}}, /* 'c' (0x63) */
    {6U, 6U, {0x01C0U, 0x0220U, 0x0220U, 0x0220U, 0x03F8U, 0x0000U, 0x0000U, 0x0000U, 0x0000U, 0x0000U, 0x0000U, 0x0000U}}, /* 'd' (0x64) */
    {6U, 6U, {0x01C0U, 0x02A0U, 0x02A0U, 0x02A0U, 0x02C0U, 0x0000U, 0x0000U, 0x0000U, 0x0000U, 0x0000U, 0x0000U, 0x0000U}}, /* 'e' (0x65) */
    {3U, 3U, {0x03F8U, 0x0028U, 0x0000U, 0x0000U, 0x0000U, 0x0000U, 0x0000U, 0x0000U, 0x0000U, 0x0000U, 0x0000U, 0x0000U}}, /* 'f' (0x66) */
    {6U, 6U, {0x05C0U, 0x0A20U, 0x0A20U, 0x0A20U, 0x07E0U, 0x0000U, 0x0000U, 0x0000U, 0x0000U, 0x0000U, 0x0000U, 0x0000U}}, /* 'g' (0x67) */
    {6U, 6U, {0x03F8U, 0x0020U, 0x0020U, 0x0020U, 0x03C0U, 0x0000U, 0x0000U, 0x0000U, 0x0000U, 0x0000U, 0x0000U, 0x0000U}}, /* 'h' (0x68) */
    {3U, 3U, {0x03E8U, 0x0000U, 0x0000U, 0x0000U, 0x0000U, 0x0000U, 0x0000U, 0x0000U, 0x0000U, 0x0000U, 0x0000U, 0x0000U}}, /* 'i' (0x69) */
    {3U, 3U, {0x0800U, 0x07E8U, 0x0000U, 0x0000U, 0x0000U, 0x0000U, 0x0000U, 0x0000U, 0x0000U, 0x0000U, 0x0000U, 0x0000U}}, /* 'j' (0x6A) */
    {6U, 6U, {0x0000U, 0x03F8U, 0x0080U, 0x0140U, 0x0220U, 0x0000U, 0x0000U, 0x0000U, 0x0000U, 0x0000U, 0x0000U, 0x0000U}}, /* 'k' (0x6B) */
    {3U, 3U, {0x03F8U, 0x0000U, 0x0000U, 0x0000U, 0x0000U, 0x0000U, 0x0000U, 0x0000U, 0x0000U, 0x0000U, 0x0000U, 0x0000U}}, /* 'l' (0x6C) */
    {9U, 9U, {0x0000U, 0x03E0U, 0x0020U, 0x0020U, 0x03C0U, 0x0020U, 0x0020U, 0x03C0U, 0x0000U, 0x0000U, 0x0000U, 0x0000U}}, /* 'm' (0x6D) */
    {6U, 6U, {0x03E0U, 0x0020U, 0x0020U, 0x0020U, 0x03C0U, 0x0000U, 0x0000U, 0x0000U, 0x0000U, 0x0000U, 0x0000U, 0x0000U}}, /* 'n' (0x6E) */
    {6U, 6U, {0x01C0U, 0x0220U, 0x0220U, 0x0220U, 0x01C0U, 0x0000U, 0x0000U, 0x0000U, 0x0000U, 0x0000U, 0x0000U, 0x0000U}}, /* 'o' (0x6F) */
    {6U, 6U, {0x0FE0U, 0x0220U, 0x0220U, 0x0220U, 0x01C0U, 0x0000U, 0x0000U, 0x0000U, 0x0000U, 0x0000U, 0x0000U, 0x0000U}}, /* 'p' (0x70) */
    {6U, 6U, {0x01C0U, 0x0220U, 0x0220U, 0x0220U, 0x0FE0U, 0x0000U, 0x0000U, 0x0000U, 0x0000U, 0x0000U, 0x0000U, 0x0000U}}, /* 'q' (0x71) */
    {4U, 4U, {0x03E0U, 0x0020U, 0x0020U, 0x0000U, 0x0000U, 0x0000U, 0x0000U, 0x0000U, 0x0000U, 0x0000U, 0x0000U, 0x0000U}}, /* 'r' (0x72) */
    {6U, 6U, {0x0240U, 0x02A0U, 0x02A0U, 0x02A0U, 0x0120U, 0x0000U, 0x0000U, 0x0000U, 0x0000U, 0x0000U, 0x0000U, 0x0000U}}, /* 's' (0x73) */
    {3U, 3U, {0x03F8U, 0x0220U, 0x0000U, 0x0000U, 0x0000U, 0x0000U, 0x0000U, 0x0000U, 0x0000U, 0x0000U, 0x0000U, 0x0000U}}, /* 't' (0x74) */
    {6U, 6U, {0x01E0U, 0x0200U, 0x0200U, 0x0200U, 0x03E0U, 0x0000U, 0x0000U, 0x0000U, 0x0000U, 0x0000U, 0x0000U, 0x0000U}}, /* 'u' (0x75) */
    {6U, 6U, {0x0020U, 0x00C0U, 0x0300U, 0x0300U, 0x00C0U, 0x0020U, 0x0000U, 0x0000U, 0x0000U, 0x0000U, 0x0000U, 0x0000U}}, /* 'v' (0x76) */
    {9U, 8U, {0x0020U, 0x00C0U, 0x0300U, 0x0080U, 0x0060U, 0x0080U, 0x0300U, 0x00C0U, 0x0020U, 0x0000U, 0x0000U, 0x0000U}}, /* 'w' (0x77) */
    {6U, 6U, {0x0220U, 0x0140U, 0x0080U, 0x0140U, 0x0220U, 0x0000U, 0x0000U, 0x0000U, 0x0000U, 0x0000U, 0x0000U, 0x0000U}}, /* 'x' (0x78) */
    {6U, 6U, {0x0820U, 0x09C0U, 0x0600U, 0x01C0U, 0x0020U, 0x0000U, 0x0000U, 0x0000U, 0x0000U, 0x0000U, 0x0000U, 0x0000U}}, /* 'y' (0x79) */
    {5U, 5U, {0x0320U, 0x02A0U, 0x0260U, 0x0220U, 0x0000U, 0x0000U, 0x0000U, 0x0000U, 0x0000U, 0x0000U, 0x0000U, 0x0000U}}, /* 'z' (0x7A) */
    {4U, 4U, {0x0080U, 0x0F78U, 0x0808U, 0x0808U, 0x0000U, 0x0000U, 0x0000U, 0x0000U, 0x0000U, 0x0000U, 0x0000U, 0x0000U}}, /* '{' (0x7B) */
    {3U, 3U, {0x0000U, 0x0FF8U, 0x0000U, 0x0000U, 0x0000U, 0x0000U, 0x0000U, 0x0000U, 0x0000U, 0x0000U, 0x0000U, 0x0000U}}, /* '|' (0x7C) */
    {4U, 4U, {0x0808U, 0x0808U, 0x0F78U, 0x0080U, 0x0000U, 0x0000U, 0x0000U, 0x0000U, 0x0000U, 0x0000U, 0x0000U, 0x0000U}}, /* '}' (0x7D) */
    {6U, 6U, {0x0040U, 0x0020U, 0x0020U, 0x0040U, 0x0040U, 0x0020U, 0x0000U, 0x0000U, 0x0000U, 0x0000U, 0x0000U, 0x0000U}}, /* '~' (0x7E) */
};

static const ArialGlyph_t g_arial_bold_13[95] = {
    {4U, 4U, {0x0000U, 0x0000U, 0x0000U, 0x0000U, 0x0000U, 0x0000U, 0x0000U, 0x0000U, 0x0000U, 0x0000U, 0x0000U, 0x0000U}}, /* ' ' (0x20) */
    {4U, 4U, {0x0000U, 0x0DFCU, 0x0DFCU, 0x0000U, 0x0000U, 0x0000U, 0x0000U, 0x0000U, 0x0000U, 0x0000U, 0x0000U, 0x0000U}}, /* '!' (0x21) */
    {6U, 6U, {0x0000U, 0x001CU, 0x001CU, 0x0000U, 0x001CU, 0x001CU, 0x0000U, 0x0000U, 0x0000U, 0x0000U, 0x0000U, 0x0000U}}, /* '"' (0x22) */
    {7U, 7U, {0x0F20U, 0x01E0U, 0x013CU, 0x0F20U, 0x01E0U, 0x013CU, 0x0000U, 0x0000U, 0x0000U, 0x0000U, 0x0000U, 0x0000U}}, /* '#' (0x23) */
    {7U, 7U, {0x0000U, 0x0478U, 0x08E4U, 0x1FFEU, 0x09C4U, 0x0788U, 0x0000U, 0x0000U, 0x0000U, 0x0000U, 0x0000U, 0x0000U}}, /* '$' (0x24) */
    {12U, 12U, {0x0000U, 0x007CU, 0x0044U, 0x0C7CU, 0x0380U, 0x0060U, 0x0F9CU, 0x0880U, 0x0F80U, 0x0000U, 0x0000U, 0x0000U}}, /* '%' (0x25) */
    {9U, 9U, {0x0000U, 0x0700U, 0x0F98U, 0x08FCU, 0x09E4U, 0x0FBCU, 0x0638U, 0x0F80U, 0x0800U, 0x0000U, 0x0000U, 0x0000U}}, /* '&' (0x26) */
    {3U, 3U, {0x0000U, 0x001CU, 0x001CU, 0x0000U, 0x0000U, 0x0000U, 0x0000U, 0x0000U, 0x0000U, 0x0000U, 0x0000U, 0x0000U}}, /* ''' (0x27) */
    {4U, 4U, {0x0000U, 0x0FE0U, 0x3FF8U, 0x600CU, 0x0000U, 0x0000U, 0x0000U, 0x0000U, 0x0000U, 0x0000U, 0x0000U, 0x0000U}}, /* '(' (0x28) */
    {4U, 4U, {0x600CU, 0x3FF8U, 0x0FE0U, 0x0000U, 0x0000U, 0x0000U, 0x0000U, 0x0000U, 0x0000U, 0x0000U, 0x0000U, 0x0000U}}, /* ')' (0x29) */
    {5U, 5U, {0x0028U, 0x0028U, 0x001CU, 0x0028U, 0x0028U, 0x0000U, 0x0000U, 0x0000U, 0x0000U, 0x0000U, 0x0000U, 0x0000U}}, /* '*' (0x2A) */
    {8U, 8U, {0x0000U, 0x0080U, 0x0080U, 0x03E0U, 0x03E0U, 0x0080U, 0x0080U, 0x0000U, 0x0000U, 0x0000U, 0x0000U, 0x0000U}}, /* '+' (0x2B) */
    {4U, 4U, {0x0000U, 0x2C00U, 0x1C00U, 0x0000U, 0x0000U, 0x0000U, 0x0000U, 0x0000U, 0x0000U, 0x0000U, 0x0000U, 0x0000U}}, /* ',' (0x2C) */
    {4U, 4U, {0x0000U, 0x0200U, 0x0200U, 0x0200U, 0x0000U, 0x0000U, 0x0000U, 0x0000U, 0x0000U, 0x0000U, 0x0000U, 0x0000U}}, /* '-' (0x2D) */
    {4U, 4U, {0x0000U, 0x0C00U, 0x0C00U, 0x0000U, 0x0000U, 0x0000U, 0x0000U, 0x0000U, 0x0000U, 0x0000U, 0x0000U, 0x0000U}}, /* '.' (0x2E) */
    {4U, 4U, {0x0C00U, 0x0380U, 0x0070U, 0x000CU, 0x0000U, 0x0000U, 0x0000U, 0x0000U, 0x0000U, 0x0000U, 0x0000U, 0x0000U}}, /* '/' (0x2F) */
    {7U, 7U, {0x07F8U, 0x0FFCU, 0x0804U, 0x0804U, 0x0FFCU, 0x07F8U, 0x0000U, 0x0000U, 0x0000U, 0x0000U, 0x0000U, 0x0000U}}, /* '0' (0x30) */
    {7U, 7U, {0x0000U, 0x0030U, 0x0018U, 0x0FFCU, 0x0FFCU, 0x0000U, 0x0000U, 0x0000U, 0x0000U, 0x0000U, 0x0000U, 0x0000U}}, /* '1' (0x31) */
    {7U, 7U, {0x0C08U, 0x0E0CU, 0x0B84U, 0x09C4U, 0x08FCU, 0x0838U, 0x0000U, 0x0000U, 0x0000U, 0x0000U, 0x0000U, 0x0000U}}, /* '2' (0x32) */
    {7U, 7U, {0x0408U, 0x0C0CU, 0x0844U, 0x0844U, 0x0FFCU, 0x07B8U, 0x0000U, 0x0000U, 0x0000U, 0x0000U, 0x0000U, 0x0000U}}, /* '3' (0x33) */
    {7U, 7U, {0x0300U, 0x02C0U, 0x0230U, 0x0FFCU, 0x0FFCU, 0x0200U, 0x0000U, 0x0000U, 0x0000U, 0x0000U, 0x0000U, 0x0000U}}, /* '4' (0x34) */
    {7U, 7U, {0x0470U, 0x0C7CU, 0x082CU, 0x0824U, 0x0FE4U, 0x07C4U, 0x0000U, 0x0000U, 0x0000U, 0x0000U, 0x0000U, 0x0000U}}, /* '5' (0x35) */
    {7U, 7U, {0x07F0U, 0x0FF8U, 0x0844U, 0x0844U, 0x0FCCU, 0x0788U, 0x0000U, 0x0000U, 0x0000U, 0x0000U, 0x0000U, 0x0000U}}, /* '6' (0x36) */
    {7U, 7U, {0x0004U, 0x0E04U, 0x0FC4U, 0x01F4U, 0x003CU, 0x000CU, 0x0000U, 0x0000U, 0x0000U, 0x0000U, 0x0000U, 0x0000U}}, /* '7' (0x37) */
    {7U, 7U, {0x07B8U, 0x0FFCU, 0x0844U, 0x0844U, 0x0FFCU, 0x07B8U, 0x0000U, 0x0000U, 0x0000U, 0x0000U, 0x0000U, 0x0000U}}, /* '8' (0x38) */
    {7U, 7U, {0x0478U, 0x0CFCU, 0x0884U, 0x0884U, 0x07FCU, 0x03F8U, 0x0000U, 0x0000U, 0x0000U, 0x0000U, 0x0000U, 0x0000U}}, /* '9' (0x39) */
    {4U, 4U, {0x0000U, 0x0C60U, 0x0C60U, 0x0000U, 0x0000U, 0x0000U, 0x0000U, 0x0000U, 0x0000U, 0x0000U, 0x0000U, 0x0000U}}, /* ':' (0x3A) */
    {4U, 4U, {0x0000U, 0x2C60U, 0x1C60U, 0x0000U, 0x0000U, 0x0000U, 0x0000U, 0x0000U, 0x0000U, 0x0000U, 0x0000U, 0x0000U}}, /* ';' (0x3B) */
    {8U, 8U, {0x0080U, 0x01C0U, 0x0140U, 0x0360U, 0x0220U, 0x0630U, 0x0000U, 0x0000U, 0x0000U, 0x0000U, 0x0000U, 0x0000U}}, /* '<' (0x3C) */
    {8U, 8U, {0x0140U, 0x0140U, 0x0140U, 0x0140U, 0x0140U, 0x0140U, 0x0140U, 0x0000U, 0x0000U, 0x0000U, 0x0000U, 0x0000U}}, /* '=' (0x3D) */
    {8U, 8U, {0x0000U, 0x0630U, 0x0220U, 0x0360U, 0x0140U, 0x01C0U, 0x0080U, 0x0000U, 0x0000U, 0x0000U, 0x0000U, 0x0000U}}, /* '>' (0x3E) */
    {8U, 8U, {0x0008U, 0x000CU, 0x0D04U, 0x0D84U, 0x00C4U, 0x007CU, 0x0038U, 0x0000U, 0x0000U, 0x0000U, 0x0000U, 0x0000U}}, /* '?' (0x3F) */
    {12U, 12U, {0x07C0U, 0x1830U, 0x2798U, 0x2FC8U, 0x4CE4U, 0x4C64U, 0x4664U, 0x4FC4U, 0x4FE4U, 0x48E4U, 0x2408U, 0x2610U}}, /* '@' (0x40) */
    {9U, 9U, {0x0C00U, 0x0F80U, 0x03F0U, 0x027CU, 0x020CU, 0x027CU, 0x03F0U, 0x0F80U, 0x0C00U, 0x0000U, 0x0000U, 0x0000U}}, /* 'A' (0x41) */
    {9U, 9U, {0x0000U, 0x0FFCU, 0x0FFCU, 0x0844U, 0x0844U, 0x0844U, 0x0FFCU, 0x07B8U, 0x0000U, 0x0000U, 0x0000U, 0x0000U}}, /* 'B' (0x42) */
    {9U, 9U, {0x0000U, 0x03F0U, 0x07F8U, 0x0C0CU, 0x0804U, 0x0804U, 0x0804U, 0x0C0CU, 0x0408U, 0x0000U, 0x0000U, 0x0000U}}, /* 'C' (0x43) */
    {9U, 9U, {0x0000U, 0x0FFCU, 0x0FFCU, 0x0804U, 0x0804U, 0x0C0CU, 0x07F8U, 0x03F0U, 0x0000U, 0x0000U, 0x0000U, 0x0000U}}, /* 'D' (0x44) */
    {9U, 9U, {0x0000U, 0x0FFCU, 0x0FFCU, 0x0844U, 0x0844U, 0x0844U, 0x0844U, 0x0000U, 0x0000U, 0x0000U, 0x0000U, 0x0000U}}, /* 'E' (0x45) */
    {8U, 8U, {0x0000U, 0x0FFCU, 0x0FFCU, 0x0084U, 0x0084U, 0x0084U, 0x0084U, 0x0000U, 0x0000U, 0x0000U, 0x0000U, 0x0000U}}, /* 'F' (0x46) */
    {10U, 10U, {0x0000U, 0x03F0U, 0x07F8U, 0x0C0CU, 0x0804U, 0x0884U, 0x0884U, 0x0F8CU, 0x0788U, 0x0000U, 0x0000U, 0x0000U}}, /* 'G' (0x47) */
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
    {4U, 4U, {0x000CU, 0x0070U, 0x0380U, 0x0C00U, 0x0000U, 0x0000U, 0x0000U, 0x0000U, 0x0000U, 0x0000U, 0x0000U, 0x0000U}}, /* 'code_92' (0x5C) */
    {4U, 4U, {0x4004U, 0x7FFCU, 0x7FFCU, 0x0000U, 0x0000U, 0x0000U, 0x0000U, 0x0000U, 0x0000U, 0x0000U, 0x0000U, 0x0000U}}, /* ']' (0x5D) */
    {8U, 8U, {0x0080U, 0x00E0U, 0x0038U, 0x0038U, 0x00E0U, 0x0080U, 0x0000U, 0x0000U, 0x0000U, 0x0000U, 0x0000U, 0x0000U}}, /* '^' (0x5E) */
    {7U, 7U, {0x4000U, 0x4000U, 0x4000U, 0x4000U, 0x4000U, 0x4000U, 0x4000U, 0x0000U, 0x0000U, 0x0000U, 0x0000U, 0x0000U}}, /* '_' (0x5F) */
    {4U, 4U, {0x0004U, 0x000CU, 0x0008U, 0x0000U, 0x0000U, 0x0000U, 0x0000U, 0x0000U, 0x0000U, 0x0000U, 0x0000U, 0x0000U}}, /* '`' (0x60) */
    {7U, 7U, {0x0000U, 0x0640U, 0x0F20U, 0x09A0U, 0x08A0U, 0x0FE0U, 0x0FC0U, 0x0000U, 0x0000U, 0x0000U, 0x0000U, 0x0000U}}, /* 'a' (0x61) */
    {8U, 8U, {0x0000U, 0x0FFCU, 0x0FFCU, 0x0440U, 0x0820U, 0x0FE0U, 0x07C0U, 0x0000U, 0x0000U, 0x0000U, 0x0000U, 0x0000U}}, /* 'b' (0x62) */
    {7U, 7U, {0x0000U, 0x07C0U, 0x0FE0U, 0x0820U, 0x0820U, 0x0C60U, 0x0440U, 0x0000U, 0x0000U, 0x0000U, 0x0000U, 0x0000U}}, /* 'c' (0x63) */
    {8U, 8U, {0x0000U, 0x07C0U, 0x0FE0U, 0x0820U, 0x0440U, 0x0FFCU, 0x0FFCU, 0x0000U, 0x0000U, 0x0000U, 0x0000U, 0x0000U}}, /* 'd' (0x64) */
    {7U, 7U, {0x0000U, 0x07C0U, 0x0FE0U, 0x0920U, 0x0920U, 0x0DE0U, 0x05C0U, 0x0000U, 0x0000U, 0x0000U, 0x0000U, 0x0000U}}, /* 'e' (0x65) */
    {5U, 4U, {0x0020U, 0x0FF8U, 0x0FFCU, 0x0024U, 0x0004U, 0x0000U, 0x0000U, 0x0000U, 0x0000U, 0x0000U, 0x0000U, 0x0000U}}, /* 'f' (0x66) */
    {8U, 8U, {0x0000U, 0x27C0U, 0x4FE0U, 0x4820U, 0x4440U, 0x7FE0U, 0x3FE0U, 0x0000U, 0x0000U, 0x0000U, 0x0000U, 0x0000U}}, /* 'g' (0x67) */
    {8U, 8U, {0x0000U, 0x0FFCU, 0x0FFCU, 0x0040U, 0x0020U, 0x0FE0U, 0x0FC0U, 0x0000U, 0x0000U, 0x0000U, 0x0000U, 0x0000U}}, /* 'h' (0x68) */
    {4U, 4U, {0x0000U, 0x0FECU, 0x0FECU, 0x0000U, 0x0000U, 0x0000U, 0x0000U, 0x0000U, 0x0000U, 0x0000U, 0x0000U, 0x0000U}}, /* 'i' (0x69) */
    {4U, 4U, {0x4000U, 0x7FECU, 0x3FECU, 0x0000U, 0x0000U, 0x0000U, 0x0000U, 0x0000U, 0x0000U, 0x0000U, 0x0000U, 0x0000U}}, /* 'j' (0x6A) */
    {7U, 7U, {0x0000U, 0x0FFCU, 0x0FFCU, 0x0180U, 0x07C0U, 0x0E60U, 0x0820U, 0x0000U, 0x0000U, 0x0000U, 0x0000U, 0x0000U}}, /* 'k' (0x6B) */
    {4U, 4U, {0x0000U, 0x0FFCU, 0x0FFCU, 0x0000U, 0x0000U, 0x0000U, 0x0000U, 0x0000U, 0x0000U, 0x0000U, 0x0000U, 0x0000U}}, /* 'l' (0x6C) */
    {12U, 12U, {0x0000U, 0x0FE0U, 0x0FE0U, 0x0040U, 0x0020U, 0x0FE0U, 0x0FE0U, 0x0040U, 0x0020U, 0x0FE0U, 0x0FC0U, 0x0000U}}, /* 'm' (0x6D) */
    {8U, 8U, {0x0000U, 0x0FE0U, 0x0FE0U, 0x0040U, 0x0020U, 0x0FE0U, 0x0FC0U, 0x0000U, 0x0000U, 0x0000U, 0x0000U, 0x0000U}}, /* 'n' (0x6E) */
    {8U, 8U, {0x0000U, 0x07C0U, 0x0FE0U, 0x0820U, 0x0820U, 0x0FE0U, 0x07C0U, 0x0000U, 0x0000U, 0x0000U, 0x0000U, 0x0000U}}, /* 'o' (0x6F) */
    {8U, 8U, {0x0000U, 0x7FE0U, 0x7FE0U, 0x0440U, 0x0820U, 0x0FE0U, 0x07C0U, 0x0000U, 0x0000U, 0x0000U, 0x0000U, 0x0000U}}, /* 'p' (0x70) */
    {8U, 8U, {0x0000U, 0x07C0U, 0x0FE0U, 0x0820U, 0x0440U, 0x7FE0U, 0x7FE0U, 0x0000U, 0x0000U, 0x0000U, 0x0000U, 0x0000U}}, /* 'q' (0x71) */
    {5U, 5U, {0x0000U, 0x0FE0U, 0x0FE0U, 0x0020U, 0x0020U, 0x0000U, 0x0000U, 0x0000U, 0x0000U, 0x0000U, 0x0000U, 0x0000U}}, /* 'r' (0x72) */
    {7U, 7U, {0x04C0U, 0x0DE0U, 0x09A0U, 0x0B20U, 0x0F60U, 0x0640U, 0x0000U, 0x0000U, 0x0000U, 0x0000U, 0x0000U, 0x0000U}}, /* 's' (0x73) */
    {4U, 4U, {0x0020U, 0x07F0U, 0x0FF8U, 0x0820U, 0x0000U, 0x0000U, 0x0000U, 0x0000U, 0x0000U, 0x0000U, 0x0000U, 0x0000U}}, /* 't' (0x74) */
    {8U, 8U, {0x0000U, 0x07E0U, 0x0FE0U, 0x0800U, 0x0800U, 0x0FE0U, 0x0FE0U, 0x0000U, 0x0000U, 0x0000U, 0x0000U, 0x0000U}}, /* 'u' (0x75) */
    {7U, 7U, {0x0060U, 0x03E0U, 0x0F80U, 0x0C00U, 0x0F80U, 0x03E0U, 0x0060U, 0x0000U, 0x0000U, 0x0000U, 0x0000U, 0x0000U}}, /* 'v' (0x76) */
    {11U, 10U, {0x0060U, 0x03E0U, 0x0F80U, 0x0E00U, 0x07C0U, 0x00E0U, 0x07C0U, 0x0E00U, 0x0F80U, 0x03E0U, 0x0060U, 0x0000U}}, /* 'w' (0x77) */
    {7U, 7U, {0x0000U, 0x0C60U, 0x0EE0U, 0x0380U, 0x0380U, 0x0EE0U, 0x0C60U, 0x0000U, 0x0000U, 0x0000U, 0x0000U, 0x0000U}}, /* 'x' (0x78) */
    {7U, 7U, {0x4060U, 0x43E0U, 0x7F80U, 0x7C00U, 0x1F80U, 0x03E0U, 0x0060U, 0x0000U, 0x0000U, 0x0000U, 0x0000U, 0x0000U}}, /* 'y' (0x79) */
    {7U, 7U, {0x0000U, 0x0C20U, 0x0F20U, 0x0BA0U, 0x08E0U, 0x0860U, 0x0000U, 0x0000U, 0x0000U, 0x0000U, 0x0000U, 0x0000U}}, /* 'z' (0x7A) */
    {5U, 5U, {0x0100U, 0x3FF8U, 0x7EFCU, 0x4004U, 0x4004U, 0x0000U, 0x0000U, 0x0000U, 0x0000U, 0x0000U, 0x0000U, 0x0000U}}, /* '{' (0x7B) */
    {4U, 4U, {0x0000U, 0x3FFCU, 0x0000U, 0x0000U, 0x0000U, 0x0000U, 0x0000U, 0x0000U, 0x0000U, 0x0000U, 0x0000U, 0x0000U}}, /* '|' (0x7C) */
    {5U, 5U, {0x4004U, 0x4004U, 0x7EFCU, 0x3FF8U, 0x0100U, 0x0000U, 0x0000U, 0x0000U, 0x0000U, 0x0000U, 0x0000U, 0x0000U}}, /* '}' (0x7D) */
    {8U, 8U, {0x0100U, 0x0080U, 0x0080U, 0x0180U, 0x0100U, 0x0100U, 0x0080U, 0x0000U, 0x0000U, 0x0000U, 0x0000U, 0x0000U}}, /* '~' (0x7E) */
};
#endif /* OLED_FONT_ARIAL_H */
