VincentttWang/MSP430_WirelessCar/NUEDC_2026/[Doc] Hardware/感为灰度Keil_MSPM0例程/examples/Software_IIC/ti_msp_dl_config.c

/*
 * Copyright (c) 2023, Texas Instruments Incorporated
 * All rights reserved.
 *
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
 * *  Redistributions of source code must retain the above copyright
 *    notice, this list of conditions and the following disclaimer.
 *
 * *  Redistributions in binary form must reproduce the above copyright
 *    notice, this list of conditions and the following disclaimer in the
 *    documentation and/or other materials provided with the distribution.
 *
 * *  Neither the name of Texas Instruments Incorporated nor the names of
 *    its contributors may be used to endorse or promote products derived
 *    from this software without specific prior written permission.
 *
 * THIS SOFTWARE IS PROVIDED BY THE COPYRIGHT HOLDERS AND CONTRIBUTORS "AS IS"
 * AND ANY EXPRESS OR IMPLIED WARRANTIES, INCLUDING, BUT NOT LIMITED TO,
 * THE IMPLIED WARRANTIES OF MERCHANTABILITY AND FITNESS FOR A PARTICULAR
 * PURPOSE ARE DISCLAIMED. IN NO EVENT SHALL THE COPYRIGHT OWNER OR
 * CONTRIBUTORS BE LIABLE FOR ANY DIRECT, INDIRECT, INCIDENTAL, SPECIAL,
 * EXEMPLARY, OR CONSEQUENTIAL DAMAGES (INCLUDING, BUT NOT LIMITED TO,
 * PROCUREMENT OF SUBSTITUTE GOODS OR SERVICES; LOSS OF USE, DATA, OR PROFITS;
 * OR BUSINESS INTERRUPTION) HOWEVER CAUSED AND ON ANY THEORY OF LIABILITY,
 * WHETHER IN CONTRACT, STRICT LIABILITY, OR TORT (INCLUDING NEGLIGENCE OR
 * OTHERWISE) ARISING IN ANY WAY OUT OF THE USE OF THIS SOFTWARE,
 * EVEN IF ADVISED OF THE POSSIBILITY OF SUCH DAMAGE.
 */

/*
 *  ============ ti_msp_dl_config.c =============
 *  Configured MSPM0 DriverLib module definitions
 *
 *  DO NOT EDIT - This file is generated for the MSPM0G350X
 *  by the SysConfig tool.
 */

#include "ti_msp_dl_config.h"

/*
 *  ======== SYSCFG_DL_init ========
 *  Perform any initialization needed before using any board APIs
 */
SYSCONFIG_WEAK void SYSCFG_DL_init(void)
{
    SYSCFG_DL_initPower();
    SYSCFG_DL_GPIO_init();
    /* Module-Specific Initializations*/
    SYSCFG_DL_SYSCTL_init();
    SYSCFG_DL_I2C_0_init();
    SYSCFG_DL_UART_0_init();
    SYSCFG_DL_UART_1_init();
    SYSCFG_DL_ADC1_init();
    SYSCFG_DL_DMA_init();
    SYSCFG_DL_SYSTICK_init();
}



SYSCONFIG_WEAK void SYSCFG_DL_initPower(void)
{
    DL_GPIO_reset(GPIOA);
    DL_GPIO_reset(GPIOB);
    DL_I2C_reset(I2C_0_INST);
    DL_UART_Main_reset(UART_0_INST);
    DL_UART_Main_reset(UART_1_INST);
    DL_ADC12_reset(ADC1_INST);



    DL_GPIO_enablePower(GPIOA);
    DL_GPIO_enablePower(GPIOB);
    DL_I2C_enablePower(I2C_0_INST);
    DL_UART_Main_enablePower(UART_0_INST);
    DL_UART_Main_enablePower(UART_1_INST);
    DL_ADC12_enablePower(ADC1_INST);


    delay_cycles(POWER_STARTUP_DELAY);
}

SYSCONFIG_WEAK void SYSCFG_DL_GPIO_init(void)
{

    DL_GPIO_initPeripheralAnalogFunction(GPIO_HFXIN_IOMUX);
    DL_GPIO_initPeripheralAnalogFunction(GPIO_HFXOUT_IOMUX);

    DL_GPIO_initPeripheralInputFunctionFeatures(GPIO_I2C_0_IOMUX_SDA,
        GPIO_I2C_0_IOMUX_SDA_FUNC, DL_GPIO_INVERSION_DISABLE,
        DL_GPIO_RESISTOR_NONE, DL_GPIO_HYSTERESIS_DISABLE,
        DL_GPIO_WAKEUP_DISABLE);
    DL_GPIO_initPeripheralInputFunctionFeatures(GPIO_I2C_0_IOMUX_SCL,
        GPIO_I2C_0_IOMUX_SCL_FUNC, DL_GPIO_INVERSION_DISABLE,
        DL_GPIO_RESISTOR_NONE, DL_GPIO_HYSTERESIS_DISABLE,
        DL_GPIO_WAKEUP_DISABLE);
    DL_GPIO_enableHiZ(GPIO_I2C_0_IOMUX_SDA);
    DL_GPIO_enableHiZ(GPIO_I2C_0_IOMUX_SCL);

    DL_GPIO_initPeripheralOutputFunction(
        GPIO_UART_0_IOMUX_TX, GPIO_UART_0_IOMUX_TX_FUNC);
    DL_GPIO_initPeripheralInputFunction(
        GPIO_UART_0_IOMUX_RX, GPIO_UART_0_IOMUX_RX_FUNC);
    DL_GPIO_initPeripheralOutputFunction(
        GPIO_UART_1_IOMUX_TX, GPIO_UART_1_IOMUX_TX_FUNC);
    DL_GPIO_initPeripheralInputFunction(
        GPIO_UART_1_IOMUX_RX, GPIO_UART_1_IOMUX_RX_FUNC);

    DL_GPIO_initDigitalOutputFeatures(LED_PIN_22_IOMUX,
		 DL_GPIO_INVERSION_DISABLE, DL_GPIO_RESISTOR_PULL_DOWN,
		 DL_GPIO_DRIVE_STRENGTH_LOW, DL_GPIO_HIZ_DISABLE);

    DL_GPIO_initDigitalOutput(Gray_Address_PIN_0_IOMUX);

    DL_GPIO_initDigitalOutput(Gray_Address_PIN_1_IOMUX);

    DL_GPIO_initDigitalOutput(Gray_Address_PIN_2_IOMUX);

    DL_GPIO_initDigitalInput(Serial_DAT_IOMUX);

    DL_GPIO_initDigitalOutput(Serial_CLK_IOMUX);

    DL_GPIO_initDigitalOutput(Software_iic_SDA_IOMUX);

    DL_GPIO_initDigitalOutput(Software_iic_SCL_IOMUX);

    DL_GPIO_clearPins(Software_iic_PORT, Software_iic_SDA_PIN |
		Software_iic_SCL_PIN);
    DL_GPIO_enableOutput(Software_iic_PORT, Software_iic_SDA_PIN |
		Software_iic_SCL_PIN);
    DL_GPIO_clearPins(GPIOB, LED_PIN_22_PIN |
		Gray_Address_PIN_0_PIN |
		Gray_Address_PIN_1_PIN |
		Gray_Address_PIN_2_PIN |
		Serial_CLK_PIN);
    DL_GPIO_enableOutput(GPIOB, LED_PIN_22_PIN |
		Gray_Address_PIN_0_PIN |
		Gray_Address_PIN_1_PIN |
		Gray_Address_PIN_2_PIN |
		Serial_CLK_PIN);

}


static const DL_SYSCTL_SYSPLLConfig gSYSPLLConfig = {
    .inputFreq              = DL_SYSCTL_SYSPLL_INPUT_FREQ_32_48_MHZ,
	.rDivClk2x              = 0,
	.rDivClk1               = 0,
	.rDivClk0               = 0,
	.enableCLK2x            = DL_SYSCTL_SYSPLL_CLK2X_DISABLE,
	.enableCLK1             = DL_SYSCTL_SYSPLL_CLK1_DISABLE,
	.enableCLK0             = DL_SYSCTL_SYSPLL_CLK0_ENABLE,
	.sysPLLMCLK             = DL_SYSCTL_SYSPLL_MCLK_CLK0,
	.sysPLLRef              = DL_SYSCTL_SYSPLL_REF_HFCLK,
	.qDiv                   = 3,
	.pDiv                   = DL_SYSCTL_SYSPLL_PDIV_1
};
SYSCONFIG_WEAK void SYSCFG_DL_SYSCTL_init(void)
{

	//Low Power Mode is configured to be SLEEP0
    DL_SYSCTL_setBORThreshold(DL_SYSCTL_BOR_THRESHOLD_LEVEL_0);
    DL_SYSCTL_setFlashWaitState(DL_SYSCTL_FLASH_WAIT_STATE_2);

    DL_SYSCTL_setSYSOSCFreq(DL_SYSCTL_SYSOSC_FREQ_BASE);
	/* Set default configuration */
	DL_SYSCTL_disableHFXT();
	DL_SYSCTL_disableSYSPLL();
    DL_SYSCTL_setHFCLKSourceHFXTParams(DL_SYSCTL_HFXT_RANGE_32_48_MHZ,0, false);
    DL_SYSCTL_configSYSPLL((DL_SYSCTL_SYSPLLConfig *) &gSYSPLLConfig);
    DL_SYSCTL_setULPCLKDivider(DL_SYSCTL_ULPCLK_DIV_2);
    DL_SYSCTL_setHFCLKDividerForMFPCLK(DL_SYSCTL_HFCLK_MFPCLK_DIVIDER_6);
    DL_SYSCTL_enableMFCLK();
    DL_SYSCTL_enableMFPCLK();
	DL_SYSCTL_setMFPCLKSource(DL_SYSCTL_MFPCLK_SOURCE_SYSOSC);
    DL_SYSCTL_setMCLKSource(SYSOSC, HSCLK, DL_SYSCTL_HSCLK_SOURCE_SYSPLL);

}


static const DL_I2C_ClockConfig gI2C_0ClockConfig = {
    .clockSel = DL_I2C_CLOCK_BUSCLK,
    .divideRatio = DL_I2C_CLOCK_DIVIDE_1,
};

SYSCONFIG_WEAK void SYSCFG_DL_I2C_0_init(void) {

    DL_I2C_setClockConfig(I2C_0_INST,
        (DL_I2C_ClockConfig *) &gI2C_0ClockConfig);
    DL_I2C_setAnalogGlitchFilterPulseWidth(I2C_0_INST,
        DL_I2C_ANALOG_GLITCH_FILTER_WIDTH_50NS);
    DL_I2C_enableAnalogGlitchFilter(I2C_0_INST);

    /* Configure Controller Mode */
    DL_I2C_resetControllerTransfer(I2C_0_INST);
    /* Set frequency to 100000 Hz*/
    DL_I2C_setTimerPeriod(I2C_0_INST, 39);
    DL_I2C_setControllerTXFIFOThreshold(I2C_0_INST, DL_I2C_TX_FIFO_LEVEL_BYTES_7);
    DL_I2C_setControllerRXFIFOThreshold(I2C_0_INST, DL_I2C_RX_FIFO_LEVEL_BYTES_8);
    DL_I2C_enableControllerClockStretching(I2C_0_INST);


    /* Enable module */
    DL_I2C_enableController(I2C_0_INST);


}


static const DL_UART_Main_ClockConfig gUART_0ClockConfig = {
    .clockSel    = DL_UART_MAIN_CLOCK_BUSCLK,
    .divideRatio = DL_UART_MAIN_CLOCK_DIVIDE_RATIO_2
};

static const DL_UART_Main_Config gUART_0Config = {
    .mode        = DL_UART_MAIN_MODE_NORMAL,
    .direction   = DL_UART_MAIN_DIRECTION_TX_RX,
    .flowControl = DL_UART_MAIN_FLOW_CONTROL_NONE,
    .parity      = DL_UART_MAIN_PARITY_NONE,
    .wordLength  = DL_UART_MAIN_WORD_LENGTH_8_BITS,
    .stopBits    = DL_UART_MAIN_STOP_BITS_ONE
};

SYSCONFIG_WEAK void SYSCFG_DL_UART_0_init(void)
{
    DL_UART_Main_setClockConfig(UART_0_INST, (DL_UART_Main_ClockConfig *) &gUART_0ClockConfig);

    DL_UART_Main_init(UART_0_INST, (DL_UART_Main_Config *) &gUART_0Config);
    /*
     * Configure baud rate by setting oversampling and baud rate divisors.
     *  Target baud rate: 115200
     *  Actual baud rate: 115273.78
     */
    DL_UART_Main_setOversampling(UART_0_INST, DL_UART_OVERSAMPLING_RATE_16X);
    DL_UART_Main_setBaudRateDivisor(UART_0_INST, UART_0_IBRD_20_MHZ_115200_BAUD, UART_0_FBRD_20_MHZ_115200_BAUD);



    DL_UART_Main_enable(UART_0_INST);
}

static const DL_UART_Main_ClockConfig gUART_1ClockConfig = {
    .clockSel    = DL_UART_MAIN_CLOCK_BUSCLK,
    .divideRatio = DL_UART_MAIN_CLOCK_DIVIDE_RATIO_1
};

static const DL_UART_Main_Config gUART_1Config = {
    .mode        = DL_UART_MAIN_MODE_NORMAL,
    .direction   = DL_UART_MAIN_DIRECTION_TX_RX,
    .flowControl = DL_UART_MAIN_FLOW_CONTROL_NONE,
    .parity      = DL_UART_MAIN_PARITY_NONE,
    .wordLength  = DL_UART_MAIN_WORD_LENGTH_8_BITS,
    .stopBits    = DL_UART_MAIN_STOP_BITS_ONE
};

SYSCONFIG_WEAK void SYSCFG_DL_UART_1_init(void)
{
    DL_UART_Main_setClockConfig(UART_1_INST, (DL_UART_Main_ClockConfig *) &gUART_1ClockConfig);

    DL_UART_Main_init(UART_1_INST, (DL_UART_Main_Config *) &gUART_1Config);
    /*
     * Configure baud rate by setting oversampling and baud rate divisors.
     *  Target baud rate: 115200
     *  Actual baud rate: 115190.78
     */
    DL_UART_Main_setOversampling(UART_1_INST, DL_UART_OVERSAMPLING_RATE_16X);
    DL_UART_Main_setBaudRateDivisor(UART_1_INST, UART_1_IBRD_40_MHZ_115200_BAUD, UART_1_FBRD_40_MHZ_115200_BAUD);


    /* Configure Interrupts */
    DL_UART_Main_enableInterrupt(UART_1_INST,
                                 DL_UART_MAIN_INTERRUPT_DMA_DONE_RX |
                                 DL_UART_MAIN_INTERRUPT_RX);

    /* Configure DMA Receive Event */
    DL_UART_Main_enableDMAReceiveEvent(UART_1_INST, DL_UART_DMA_INTERRUPT_RX);

    DL_UART_Main_enable(UART_1_INST);
}

/* ADC1 Initialization */
static const DL_ADC12_ClockConfig gADC1ClockConfig = {
    .clockSel       = DL_ADC12_CLOCK_SYSOSC,
    .divideRatio    = DL_ADC12_CLOCK_DIVIDE_8,
    .freqRange      = DL_ADC12_CLOCK_FREQ_RANGE_24_TO_32,
};
SYSCONFIG_WEAK void SYSCFG_DL_ADC1_init(void)
{
    DL_ADC12_setClockConfig(ADC1_INST, (DL_ADC12_ClockConfig *) &gADC1ClockConfig);
    DL_ADC12_initSingleSample(ADC1_INST,
        DL_ADC12_REPEAT_MODE_ENABLED, DL_ADC12_SAMPLING_SOURCE_AUTO, DL_ADC12_TRIG_SRC_SOFTWARE,
        DL_ADC12_SAMP_CONV_RES_12_BIT, DL_ADC12_SAMP_CONV_DATA_FORMAT_UNSIGNED);
    DL_ADC12_configConversionMem(ADC1_INST, ADC1_ADCMEM_ADC_Channel0,
        DL_ADC12_INPUT_CHAN_0, DL_ADC12_REFERENCE_VOLTAGE_VDDA, DL_ADC12_SAMPLE_TIMER_SOURCE_SCOMP0, DL_ADC12_AVERAGING_MODE_DISABLED,
        DL_ADC12_BURN_OUT_SOURCE_DISABLED, DL_ADC12_TRIGGER_MODE_AUTO_NEXT, DL_ADC12_WINDOWS_COMP_MODE_DISABLED);
    DL_ADC12_setPowerDownMode(ADC1_INST,DL_ADC12_POWER_DOWN_MODE_MANUAL);
    DL_ADC12_setSampleTime0(ADC1_INST,0);
    DL_ADC12_enableConversions(ADC1_INST);
}

static const DL_DMA_Config gDMA_CH0Config = {
    .transferMode   = DL_DMA_SINGLE_TRANSFER_MODE,
    .extendedMode   = DL_DMA_NORMAL_MODE,
    .destIncrement  = DL_DMA_ADDR_UNCHANGED,
    .srcIncrement   = DL_DMA_ADDR_UNCHANGED,
    .destWidth      = DL_DMA_WIDTH_WORD,
    .srcWidth       = DL_DMA_WIDTH_WORD,
    .trigger        = UART_1_INST_DMA_TRIGGER,
    .triggerType    = DL_DMA_TRIGGER_TYPE_EXTERNAL,
};

SYSCONFIG_WEAK void SYSCFG_DL_DMA_CH0_init(void)
{
    DL_DMA_initChannel(DMA, DMA_CH0_CHAN_ID , (DL_DMA_Config *) &gDMA_CH0Config);
}
SYSCONFIG_WEAK void SYSCFG_DL_DMA_init(void){
    SYSCFG_DL_DMA_CH0_init();
}


SYSCONFIG_WEAK void SYSCFG_DL_SYSTICK_init(void)
{
    /* Initialize the period to 1.00 μs */
    DL_SYSTICK_init(80);
    /* Enable the SysTick and start counting */
    DL_SYSTICK_enable();
}
