VincentttWang/MSP430_WirelessCar/NUEDC_2026/[Demo] MSPM0_Car_v5/bsp/oled/oled_font_cn.h

/**
 * @file      oled_font_cn.h
 * @brief     校准向导用的 24px / 16px 汉字点阵（1bpp，行优先，bit0 = 最左列）
 * @details   由 tools/gen_oled_cn_font.py 用微软雅黑 Bold 渲染后二值化生成，
 *            不要手工修改。改字请改脚本里的字符表并重新生成。
 */

#ifndef OLED_FONT_CN_H
#define OLED_FONT_CN_H

#include <stdint.h>

/* 索引顺序：循 线 校 准 成 功 失 败 */
#define CN24_IDX_XUN    0U
#define CN24_IDX_XIAN   1U
#define CN24_IDX_JIAO   2U
#define CN24_IDX_ZHUN   3U
#define CN24_IDX_CHENG  4U
#define CN24_IDX_GONG   5U
#define CN24_IDX_SHI    6U
#define CN24_IDX_BAI    7U

/* 索引顺序：请 放 在 白 色 上 黑 失 败 重 试 */
#define CN16_IDX_QING   0U
#define CN16_IDX_FANG   1U
#define CN16_IDX_ZAI    2U
#define CN16_IDX_BAI    3U
#define CN16_IDX_SE     4U
#define CN16_IDX_SHANG  5U
#define CN16_IDX_HEI    6U
#define CN16_IDX_SHI    7U   /* 失 */
#define CN16_IDX_BAI2   8U   /* 败 */
#define CN16_IDX_ZHONG  9U   /* 重 */
#define CN16_IDX_SHI3  10U   /* 试 */

static const uint32_t g_oled_font_cn24[8][24] = {
    { /* 循 */
        0x000000, 0x7FC070, 0x7FFFF0, 0x7FFF78, 0x07073C, 0x07871E, 0xFFFF0F, 0x7FFF26,
        0x0707F0, 0x0783F0, 0x7FF378, 0x7FF33C, 0x70333E, 0x7FF33F, 0x7FF3BF, 0x7FF3BE,
        0x7073B8, 0x7FF3B8, 0x7FF3B8, 0x7033F8, 0x7FF1F8, 0x7FF1F8, 0x7FF1B8, 0x703018,
    },
    { /* 线 */
        0x006000, 0x0E7070, 0x1E7078, 0x1C7038, 0x38F03C, 0x7FFC9C, 0x7FFFDE, 0x07FFCE,
        0x00F1FF, 0x70E0FE, 0x7FF07E, 0x7FFE78, 0x1FFE3C, 0x38EFFC, 0x3CE1FE, 0x1FE0FE,
        0x0FC03E, 0x67E000, 0xF3F9F8, 0x77FFFF, 0x7FBFFF, 0x3F0F1E, 0x3E0000, 0x000000,
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
        0x3FFC, 0x3FFC, 0x3FFC, 0x0180, 0x7FFE, 0x0180, 0xFFFF, 0x0000,
    },
    { /* 试 */
        0x0C00, 0x7C06, 0x6C0E, 0xFFFC, 0xFFF0, 0x1C0F, 0x0C0F, 0x1FEE,
        0x1FEC, 0x1CCC, 0x18CC, 0xD8DC, 0xDBFC, 0xFBFE, 0x70EE, 0x3000,
    },
};

#endif /* OLED_FONT_CN_H */
