VincentttWang/MSP430_WirelessCar/NUEDC_2026/[Doc] Hardware/感为灰度Keil_MSPM0例程/examples/Serial/keil/BSP/Uart.c

#include "Uart.h"
void uart0_send_char(char ch)
{
	while( DL_UART_isBusy(UART_0_INST) == true );
	DL_UART_Main_transmitData(UART_0_INST, ch);

}
void uart0_send_string(char* str)
{
	while(*str!=0&&str!=0)
	{
		uart0_send_char(*str++);
	}
}
