VincentttWang/MSP430_WirelessCar/(commit log)

2026-11-03 feat: Initial release of MSP430 & MSPM0 Wireless Dual-Core Smart Car system
    [2025E_dump.txt, 2026H_dump.txt, MSPM0_SDK_syscfg_menu_import.cfg, xdsalias.cfg, xdserror.cfg, xdsfamily.cfg, xdsinitial.cfg, 模块清单.xlsx]
2026-11-03 fix: smooth post-turn transition with 250ms inertia settling before heading lock
    [app_remote_car_task.c]
2026-11-03 feat: add stiction breakaway boost and fine-grained gyro rate damping for consistent inching displacement
2026-11-03 fix(autopilot): smooth u-turn alignment, Stanley cross-track correction, and filtered derivative PID damping
    [app_remote_car_task.c]
2026-11-03 fix(ui): remove trailing (停止) from STOP and enforce equal height on metric grid cards
2026-11-03 fix(autopilot): eliminate head-shaking weave with 525mm lookahead, deadband, yaw rate damping, and zero Ki
2026-11-03 style(ui): adjust left column layout to 2:1 ratio for imu panel vs comms log
2026-11-03 feat: add Ganwei 8-ch grayscale calibration via Web modal & Tianmengxing DOWN key (PB25)
2026-11-03 fix(sensor): implement Ganwei official I2C stop-handshake, auto-probing, and real-time 8-probe streaming to web modal
    [app_remote_car_task.c, grayscale_sensor.c, grayscale_sensor.h, web_server.py]
2026-11-03 fix(sensor): strictly pure I2C mode with bus recover, auto-pullup, multi-address scan and live probe visualizer
    [app_remote_car_task.c, grayscale_sensor.c, grayscale_sensor.h, ti_msp_dl_config.c, wit_sdk.h]
2026-11-04 fix(i2c-grayscale): align pure hardware I2C with Ganwei official routine and eliminate line tracking oscillation
    [app_remote_car_task.c, grayscale_sensor.c]
2026-11-04 fix(i2c-grayscale): read via repeated start and feed the 9-byte write past the 8-deep TX FIFO
    - 感为模块的 STM8 不接受 STOP 后立刻 START 的读时序，实测只有重复起始（或 STOP 后
    留 2ms 总线空闲）才能读回数据；旧实现照抄官方例程，导致模块被判离线、读数全 0。
    - 写阈值是「寄存器 + 8 字节」= 9 字节，而 MSPM0 的 I2C TX FIFO 只有 8 深，
    fillControllerTXFIFO 填满即停；改为启动传输后在循环里补剩余字节，否则第 9 字节
    永远等不到，表现为 !CAL:B# 一直回 ERR_I2C、校准卡在采黑线。
    - 超时 200000 -> 4000 次循环（约 1ms），失败统一 reset + flush TX/RX FIFO，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
    [grayscale_sensor.c]
2026-11-04 feat(oled): Chinese calibration wizard, UP-key 8-channel monitor page and hot-plug self-healing
    - 校准向导改成 24px/16px 两行汉字（循线校准/请放在白色上、请放在黑色上、校准成功、
    校准失败/请重试），点阵由 tools/gen_oled_cn_font.py 生成到 oled_font_cn.h，源码不含
    UTF-8 汉字字面量。
    - 退出流程收敛到 AppRemoteCar_ExitCalibration()：按键 / 上位机 EXIT / 成功后自动 /
    60s 无操作兜底四条路径共用，成功页停 2s 后同一帧内切回仪表盘。
    - 新增天猛星 UP 键（PA14，Key_Init 现场配成上拉输入）：短按在指南针仪表盘与
    「八路灰度实时监视」之间切换（2 列 x 4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
2026-11-04 feat(web): gamepad-style mobile layout, hand-drawn route and round-trip autopilot on both ends
    - 手机端 mobile.html 重写：左侧虚拟摇杆 + RUN/清零/急停/限速，右侧紧凑罗盘、车速里程、
    轨迹图；去掉波形与通信日志；点轨迹图进入全屏自动驾驶面板；支持 #auto / #draw 深链。
    - 自动驾驶改为「规范路线 + 方向」模型：drive.route 只在采点/手绘时更新，回放、返回、
    往返循环共用；修复「原路返回回到起点后再点回放，因轨迹首尾重合而立刻判到达、一动不动」。
    - 新增往返循环：到端点停 1.2s 自动掉头，直到手动停止；起始状态按车头与首段夹角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
2026-11-04 docs: refresh README, module interfaces and add a hands-on troubleshooting guide
    - README：补手机手柄端、手绘路线/往返循环、循线标定闭环、UP/DOWN 按键、!CAL:* 指令表
    与文档索引；硬件表补感为八路（I2C0 0x4C）与按键引脚。
    - bsp_grayscale_sensor.md 重写：原文还停留在「GPIO 读 8 路电平」，改为 I2C 版的寄存器表、
    三条时序铁律（重复起始 / TX FIFO 8 深 / 失败必须总线恢复）与完整 API 列表。
    - bsp_key.md、bsp_oled.md 补 UP 键、汉字向导、掉屏自愈与 2x4 监视页说明。
    - 新增 docs/troubleshooting.md：I2C 状态寄存器判读、内部上拉判定「模块挂 vs 总线死」、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
2026-11-04 docs(readme): add interface preview gallery with real renders and OLED framebuffer captures
    - 新增「界面预览」：电脑端绘制路线、手机端手柄/全屏自动驾驶，以及三张车载 OLED 页面。
    - OLED 图是直接读 s_oled_fb 反解出来的真实帧，不是手绘示意。
    - 截图统一压到展示尺寸（390 / 1280 宽），避免仓库里堆大图。
2026-11-04 fix(web): keep the hand-drawn route transform in sync with the live canvas size
    - 症状：在电脑端点「绘制路线」后，鼠标位置和橙色线条的落点差一大截，越往地图边缘越严重。
    - 根因：世界坐标<->屏幕坐标的换算用的是缓存的 traj.vw/vh，而它只在进出大窗和 window.resize
    时更新。绘制工具条显隐会改变地图高度（实测 453 -> 407），缓存比实际大，渲染被 CSS 缩回，
    于是线条整体缩小了一圈；小窗口下误差可超过 10%。
    - 修复：新增 trajSyncSize()，在每帧渲染前与每次指针事件前比对画布 CSS 尺寸并按需重算；
    屏幕->世界反算改用 trajCanvas.getBound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
2026-11-05 feat(web/fw): exact hand-drawn route following, unified autopilot speed, online line-follow PID tuning
    Web (PC + mobile):
    - hand-drawn route now starts from the car's current position and follows the full
    drawn polyline: short look-ahead (140~240mm), narrow nearest-point window,
    stronger cross-track correction, no 'fly to start' shortcut, length-based timeout
    - replay/return/loop all take the current speed from the speed slider (g_speedPct)
    instead of a hidden select; steering gains, look-ahead, spin power and duty floor
    are normalized by speed so different speeds stay stable
    - replaced the 'dual-side start/stop' button with a line-follow PID tuning dialog
    (Kp/Ki/Kd sliders, preset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
    [app_remote_car_task.c]
2026-11-05 fix(net): dual-stack IPv4/IPv6 listener and hotspot-aware address discovery for the phone remote
    - web_server.py now listens on both 0.0.0.0:PORT and [::]:PORT (V6ONLY),
    PORT overridable via MSP430_PORT
    - /api/info returns addresses[] with labels, preferred_url and hotspot flag;
    IPv6 literals are wrapped in [] and stable IPv6 is preferred over temporary
    privacy addresses; hotspot subnets (192.168.43/137/42/49, 172.20.10) are
    detected and their IPv4 is put first, so phone-hotspot needs no traversal
    - startup banner and PC page log list every reachable URL
    - docs/troubleshooting.md section 7: IPv6 campus direct link, phone/PC hotspot,
    firewall rule, adb reverse, ZeroTier; explain why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
    [web_server.py]
2026-11-05 feat(web/mobile): roomier landscape layout, PC-style compass, compact autopilot buttons
    - remove the top status bar; serial/car state become small boxes on the
    opposite side of the tiny RUN / reset buttons
    - drop the big emergency-stop button (long-press RUN 650ms keeps a hidden
    fallback; releasing the stick still sends !DIR:0#)
    - joystick is smaller and truly centered in the left half; it is sized from
    the available box so it never gets clipped on short landscape screens
    - speed slider spans the whole lower-left column and gets a longer track
    - right side becomes two columns: top-left speed/distance, top-right a
    rotating N/E/S/W compass matching the PC dial, bottom full-width trajec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
2026-11-05 fix(web/draw): allow zoom/pan while drawing and clear the leftover route overlay
    Drawing mode used to freeze the whole view (wheel, pan, dblclick, auto-fit
    were all short-circuited). Only continuous auto-fit recentering actually
    needs to be blocked, so:
    - wheel zoom works again and is anchored at the cursor (the world point
    under the pointer stays fixed); committed strokes are in world coords and
    follow the view, the in-progress stroke stays in screen pixels so it never
    drifts under the pointer
    - left drag draws; right/middle/Shift drag pans; context menu suppressed
    - dblclick and the auto-fit button perform a one-shot fit over trajectory +
    drawn strokes instead of enabling continuou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
2026-11-05 feat(web/mobile): PC-style brand title, nudge joystick up, larger speed/distance digits
    - add the same car-logo badge + white-to-cyan gradient h1 as the PC ground
    station at the top-left of the landscape left column; portrait shrinks it
    to two small lines so it never overlaps the joystick
    - move the joystick up by 5.5vh to make room for the title (still horizontally
    centered); direction detection still uses getBoundingClientRect so the
    transform does not affect pointer math
    - enlarge the speed/distance numbers (landscape 20px -> clamp 26..34px via
    8.4vh, portrait 22px -> 26px) with tighter line-height/padding/gap so the
    stats card keeps exactly the same outer box and nothing clip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
2026-11-07 chore(repo): polish README, rename all build/flash/start scripts to English, ship final report
    Documentation:
    - README rewritten from 221 to 181 lines: remove duplicated phone-layout prose,
    marketing filler and stale claims; align architecture with the report
    (MSP430F5529 sole decision master, MSPM0G3507 interface bridge, ESP32
    transparent serial), fix the command table to the real protocol
    (!SET:SPD=, single-char 1/2/space, !SET:PID=, 400/1200/800 ms watchdogs),
    drop the obsolete WebSocket / dual-UART / dual-wheel-encoder descriptions
    - all local links verified to resolve
    Scripts (repo root .bat, now formal English names):
    - 一键编译全部固件 -> build_all.bat
    - 一键编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
2026-11-07 chore(repo): use the final RAR submission bundle instead of the ZIP
    The user repacked the submission bundle as RAR after the previous push.
    Keep the repository in sync with the local deliverable: remove the ZIP,
    add MSP430设计报告附件_U202413712_王佳宁.rar (WinRAR integrity test passed).
