VincentttWang/MSP430_WirelessCar/(notices)

Notices in the files:
README.md:
License: MIT
